SunXingzhi/topping_machine/firmware/STM32F103C8T6/docs/PD42S1_Motor_Driver_Requirements_Design_v1.0.md

# PD42S1 三轴 CAN 电机驱动模块

## 需求与设计说明书（V1.0）

| 项目 | 内容 |
|---|---|
| 文档编号 | FW-MOTOR-PD42S1-001 |
| 版本 | V1.0 |
| 日期 | 2026-10-27 |
| 状态 | 已评审；P5 完成，等待 P6 实机联调 |
| 适用工程 | `F:\topping\topping_machine\firmware\STM32F103C8T6` |
| 目标硬件 | STM32F103C8T6 + SN65HVD230 + 3 × ATK-PD42S1（CAN 光耦版） |
| 参考文档 | 《PD42S1 步进电机闭环驱动器用户手册 V1.2》、正点原子控制协议 V1.2、CAN 通讯例程 |
| 编制 | 项目组 |
| 审核 | 待定 |

### 修订记录

| 版本 | 日期 | 修改内容 | 状态 |
|---|---|---|---|
| V1.0-draft | 2026-10-27 | 初稿：冻结 v1 需求、协议、接口、时序、测试与风险 | 已确认 |
| V1.0 | 2026-10-27 | P1：完成 `Core/Inc/motor.h` 公共接口，C/C++ 语法检查通过 | P1 完成 |
| V1.0 | 2026-10-27 | P2：完成 `Core/Src/motor.c` CAN 传输层及 `Motor_Init` / `Motor_Ping` / `Motor_GetLastDeviceError`，严格编译检查通过 | P2 完成 |
| V1.0 | 2026-10-27 | P3：完成设备服务层全部 API；ARM 严格编译与主机侧协议测试通过 | P3 完成 |
| V1.0 | 2026-10-27 | P4：接入 CMake/main，Debug/Release 完整固件编译通过；示例默认关闭 | P4 完成 |
| V1.0 | 2026-10-27 | P5：完成干净构建、HEX/BIN 校验和 26 组主机测试；详见 P5 报告 | P5 完成 |
| V1.0 | 2026-10-29 | P6 准备：`main.c` 改为三轴 100 RPM 连续旋转测试；不生成新固件 | 测试源码 |
| V1.0 | 2026-10-30 | 仓库整理：测试移至 `tests/`，生产 `main.c` 仅保留初始化；新增 Test preset 与固件 `.gitignore` | 仓库整理完成 |

> **重要说明**
>
> 本文档已于 2026-10-27 经用户确认。P1 完成 `Core/Inc/motor.h`；P2 完成 CAN 传输层；P3 完成设备服务层；P4 完成 CMake/main 接入和整机编译；P5 完成干净构建、HEX/BIN 校验和 26 组主机测试。下一步为 P6 实机联调。后续阶段需按第 15 节和 P5 报告执行。

---

## 1. 文档目的

本文档用于冻结“三轴 PD42S1 CAN 闭环步进电机驱动模块”的 v1 需求，并作为后续编码、联调和验收的依据。

目标读者：

- 负责 STM32 主程序、CAN 通信和运动控制的开发人员；
- 负责接线、地址配置和整机联调的调试人员；
- 后续维护该模块的软件人员。

---

## 2. 项目背景与目标

### 2.1 背景

- 主控：STM32F103C8T6 最小系统板，HSE 8 MHz，系统时钟 72 MHz。
- 执行机构：3 台 42 步进电机，分别搭配 1 台正点原子 ATK-PD42S1 CAN 光耦版闭环驱动器。
- 通信：3 台驱动器挂在同一条 CAN 总线上，通过 1 块 SN65HVD230 收发器与 STM32 的 CAN1 相连。
- 当前工程已用 STM32CubeMX 配置 CAN1 和基础外设，但尚未配置 CAN 过滤器、尚未启动 CAN，也没有电机控制代码。

### 2.2 目标

提供一个可复用的电机驱动模块，使调用方可以：

1. 不关心 CAN 帧拆分、重组、校验和、超时和重试；
2. 用简单接口控制 3 个电机的使能、相对位置、绝对位置、速度和停止；
3. 读取位置、速度、运行状态、到位标志和堵转标志；
4. 在裸机主循环中安全使用，不引入动态内存和 RTOS 依赖；
5. 在后续整机程序中直接复用，而不必把协议细节散落在 `main.c` 中。

### 2.3 非目标

v1 不实现：

- 驱动器内部 FOC/PID 算法（由 PD42S1 完成）；
- 自动回零、限位开关逻辑；
- 多轴直线/圆弧插补；
- 力矩模式、开环模式、脉冲模式、PWM 脉宽模式；
- PID、电流、细分、波特率、地址、CAN ID 等参数的在线配置；
- FreeRTOS 任务封装；
- CAN 总线错误注入和完整诊断工具。

---

## 3. 术语

| 术语 | 说明 |
|---|---|
| PD42S1 | 正点原子 42 步进电机 FOC 闭环驱动器，本文指 CAN 光耦版 |
| counts | 驱动器通信位置单位；51200 counts = 电机轴 1 圈 |
| 单圈绝对定位 | 上电后可确定电机在一圈内的绝对角度，但不知道掉电前累计转了多少圈 |
| 事务（transaction） | 一次“主机发一条完整指令 + 驱动器回一条完整应答”的过程 |
| 帧（frame） | 协议层完整帧：`0xC5 ... 0x5C` |
| CAN 报文 | CAN 总线上的一个数据帧，最多 8 字节 |
| 多帧 | 一条协议帧超过 8 字节，需要拆成多个 CAN 报文 |
| ACK | 驱动器对指令的应答；不是 CAN 硬件 ACK |
| 到位 | 驱动器 `0x30` 指令返回的 in-position 标志为 1 |

---

## 4. 系统概述

### 4.1 硬件拓扑

```text
                    +----------------------+
                    |  STM32F103C8T6       |
                    |  CAN1: PA11 / PA12   |
                    +----------+-----------+
                               |
                        CAN_TX / CAN_RX
                               |
                    +----------v-----------+
                    |  SN65HVD230          |
                    |  3.3V CAN 收发器      |
                    +----------+-----------+
                               |
                    CAN_H / CAN_L / GND
                               |
        +----------------------+----------------------+
        |                      |                      |
+-------v--------+     +-------v--------+     +-------v--------+
| PD42S1 #1      |     | PD42S1 #2      |     | PD42S1 #3      |
| addr = 1       |     | addr = 2       |     | addr = 3       |
| 42 stepper     |     | 42 stepper     |     | 42 stepper     |
+----------------+     +----------------+     +----------------+
```

### 4.2 软件边界

```text
应用层（main.c / 整机逻辑）
        |
        |  motor.h 公共接口
        v
电机驱动模块（motor.c）
        |
        +-- 设备服务层：命令组包、状态解析、单位换算、重试策略
        |
        +-- CAN 传输层：过滤器/启动、多帧发送、应答重组、2 ms 间隔、超时
        |
        v
STM32 HAL CAN1 -> SN65HVD230 -> CAN 总线 -> PD42S1
```

模块内部不动态申请内存，所有缓冲区为静态数组。

---

## 5. 已确认需求

| 编号 | 需求 | 确认结果 |
|---|---|---|
| REQ-001 | 控制对象 | 3 台 PD42S1，从机地址规划为 1/2/3 |
| REQ-002 | 闭环位置 | 闭环在驱动器内部完成；STM32 只发指令、读状态 |
| REQ-003 | 总线 | CAN1，500 kbps，扩展帧；仅使用正点原子自定义协议 |
| REQ-004 | 发送与应答 | 主机固定发送 ID `0x1000`；应答按报文内 `addr + code + 校验` 匹配，不依赖唯一回传 ID |
| REQ-005 | 运动接口语义 | 收到驱动器 ACK 即返回；到位等待由独立接口完成 |
| REQ-006 | 位置单位 | 底层 counts；51200 counts/圈；对外提供圈、度换算 |
| REQ-007 | 绝对定位 | 三轴行程均小于 1 圈；v1 不做回零；绝对目标默认限制 ±51200 counts |
| REQ-008 | 功能范围 | 初始化、使能/失能、相对/绝对位置、速度、立即停止、位置/速度/状态/到位/堵转读取、到位等待 |
| REQ-009 | 初始化安全 | 上电不自动使能、不自动运动 |
| REQ-010 | 运行环境 | 裸机、STM32 HAL、C11、CMake、arm-none-eabi-gcc |
| REQ-011 | 地址配置 | 使用驱动器屏幕菜单逐台设置为 1/2/3，代码按 1/2/3 固定 |
| REQ-012 | 当前硬件状态 | 尚未接线；先完成代码与编译验证，接线后联调 |
| REQ-013 | 多轴协同 | 独立运动；需要同时启动时由上层依次下发指令，不做插补 |
| REQ-014 | 重试策略 | 相对运动不自动重试；读、绝对运动、停止、使能可安全重试 |
| REQ-015 | 等待超时 | 只返回错误，不擅自刹车；需要安全停机时显式调用停止接口 |
| REQ-016 | 示例 | 提供最小示例，但默认关闭，不能在上电时自动动作 |

---

## 6. 硬件与总线前提

### 6.1 主控与 CAN

| 项目 | 配置 |
|---|---|
| MCU | STM32F103C8T6，LQFP48 |
| 系统时钟 | 72 MHz（HSE 8 MHz × 9） |
| CAN 外设 | CAN1 |
| CAN_RX | PA11 |
| CAN_TX | PA12 |
| CAN 波特率 | 500 kbps |
| CAN 模式 | Normal，AutoBusOff = ENABLE，AutoRetransmission = ENABLE |
| CAN 帧类型 | 扩展帧（29-bit ID） |
| 收发器 | SN65HVD230，3.3 V |
| 当前 CubeMX 状态 | `MX_CAN_Init()` 已存在；过滤器未配置，CAN 未启动 |

### 6.2 驱动器与电机

| 项目 | 配置 |
|---|---|
| 驱动器 | ATK-PD42S1 CAN 光耦版 × 3 |
| 电机 | 42 步进电机，1.8°，200 全步/圈 |
| 驱动器供电 | 12~32 V；手册建议 24 V、3 A |
| 通信协议 | 正点原子自定义协议；MODBUS 必须失能 |
| 从机地址 | 1、2、3 |
| CAN 速率 | 500 kbps |
| 位置分辨率 | 51200 counts/圈（通信位置模式） |
| 编码器 | 单圈绝对值；多圈累计位置掉电丢失 |

### 6.3 总线接线与终端电阻

- CAN_H 接 CAN_H，CAN_L 接 CAN_L，所有节点共地。
- 使用双绞线，CAN_H/CAN_L 成对走线，分支尽量短。
- 总线两端各保留一个 120 Ω 终端电阻，中间节点不应再并联终端。
- PD42S1 每台自带 120 Ω；SN65HVD230 模块通常也带 120 Ω 或终端跳线。
- 三台驱动器 + 一个模块全部保留终端会导致终端过多，通信可能不稳定。
- 断电测量 `CAN_H` 与 `CAN_L` 之间电阻，正常应约为 **60 Ω**；明显低于 60 Ω 说明终端过多。

### 6.4 接线前检查清单

- [ ] 三台驱动器地址已通过屏幕菜单分别设为 1、2、3。
- [ ] 三台驱动器 CAN 速率均为 500 kbps。
- [ ] 三台驱动器 MODBUS 均为“失能”，使用正点原子自定义协议。
- [ ] 总线只保留两个 120 Ω 终端；断电测量约 60 Ω。
- [ ] STM32、SN65HVD230、驱动器共地。
- [ ] 驱动器 24 V 供电容量足够，极性正确。
- [ ] 电机四线 A+ / A− / B− / B+ 接线正确，未带电拔插。
- [ ] 首次上电不带机械负载，或机械机构处于安全位置。
- [ ] 准备急停/断电手段。

> 当前状态：**尚未接线**。以上检查必须在首次上电前完成。

---

## 7. 协议摘要

### 7.1 协议选择

PD42S1 的 CAN 版本**只支持正点原子自定义协议，不支持 Modbus-RTU**。因此本模块只实现自定义协议。

### 7.2 协议帧格式

| 帧头 | 从机地址 | 功能码 | 指令数据 | 校验和 | 帧尾 |
|---|---|---|---|---|---|
| `0xC5` | `addr` | `code` | `data[0..N-1]` | `checksum` | `0x5C` |

- 地址范围：0 为广播；1~255 为从机地址。
- 校验和：`checksum = (0xC5 + addr + code + data 所有字节) & 0xFF`。
- 多字节整数使用**大端序**（高字节在前）。
- 32 位浮点数使用 IEEE-754 单精度，按高字节到低字节发送。
- 一条完整协议帧可能超过 8 字节，需要拆成多个 CAN 报文。

### 7.3 CAN 传输规则

| 规则 | 要求 |
|---|---|
| CAN ID | 必须为 `0x100x` 扩展帧；主机发送固定使用 `0x1000` |
| 单条协议帧 | 从 `0xC5` 到 `0x5C` 连续输出 |
| CAN 拆分 | 每 8 字节一包，最后一包 1~8 字节 |
| 指令间隔 | 两条完整指令之间至少 2 ms |
| 应答 | 驱动器回复一条完整协议帧，可能跨多个 CAN 报文 |
| 多机 | 同一时刻只允许一个从机应答；主机必须串行发指令 |
| 广播/分组 | 广播地址和分组地址不应答 |

### 7.4 位置、方向、速度、加减速度

| 项目 | 说明 |
|---|---|
| 位置单位 | 51200 counts/圈 |
| 方向 | `0` 正转，`1` 反转 |
| 绝对位置/相对位置 | 数据域为“方向 + 加减速度 + 速度 + 位置幅值” |
| 位置幅值 | `uint32_t`，按大端发送；API 的带符号 counts 在内部拆成方向和幅值 |
| 位置模式速度 | `uint16_t`，0~6000 RPM；API 实际要求 1~6000 RPM |
| 速度模式速度 | `float`，0.1~6000 RPM |
| 加减速度 | `uint8_t`，0~200；0 表示直接启动 |
| 绝对定位限制 | v1 软件限制 `abs(target_counts) <= 51200` |

### 7.5 v1 使用的功能码

| 功能 | 功能码 | 下行数据长度 | 下行总长 | 上行数据长度 | 上行总长 | v1 |
|---|---|---:|---:|---:|---:|---|
| 读取软硬件版本（Ping） | `0x20` | 0 | 5 | 3 | 8 | 是 |
| 读实时转速 | `0x29` | 0 | 5 | 3 | 8 | 是 |
| 读实时位置 | `0x2A` | 0 | 5 | 5 | 10 | 是 |
| 读运行状态 | `0x2C` | 0 | 5 | 2 | 7 | 是 |
| 读堵转标志 | `0x2D` | 0 | 5 | 2 | 7 | 是 |
| 读使能状态 | `0x2F` | 0 | 5 | 2 | 7 | 是 |
| 读到位标志 | `0x30` | 0 | 5 | 2 | 7 | 是 |
| 电机使能控制 | `0xFA` | 1 | 6 | 2 | 7 | 是 |
| 速度模式控制 | `0xF1` | 6 | 11 | 1 | 6 | 是 |
| 绝对位置模式控制 | `0xF2` | 8 | 13 | 1 | 6 | 是 |
| 相对位置模式控制 | `0xF3` | 8 | 13 | 1 | 6 | 是 |
| 立即停止（刹车） | `0xFC` | 0 | 5 | 1 | 6 | 是 |
| 当前位置清零 | `0xF8` | 0 | 5 | 1 | 6 | 可选 |
| 设置从机地址 | `0x60` | 1 | 6 | 2 | 7 | 否（屏幕配置） |
| 设置发送 CAN_ID | `0x6C` | 4 | 9 | 5 | 10 | 否 |

> 表中的“总长”包含帧头、地址、功能码、数据、校验和、帧尾。
>
> 0xF2 / 0xF3 的 13 字节长度以手册 V1.2 为准。厂商 CAN 例程中这两个函数多发送了一个保留 0 字节（14 字节），首次联调时需要实机确认，详见第 14 节风险 R-03。

### 7.6 驱动器错误码

| 错误码 | 含义 | 本模块映射 |
|---|---|---|
| `0x01` | 应答成功 | `MOTOR_OK` |
| `0xE1` | 帧长度不足 | `MOTOR_ERR_FRAME` |
| `0xE2` | 帧头错误 | `MOTOR_ERR_FRAME` |
| `0xE3` | 帧尾错误 | `MOTOR_ERR_FRAME` |
| `0xE4` | 校验和错误 | `MOTOR_ERR_CHECKSUM` |
| `0xE5` | 不支持的功能码 | `MOTOR_ERR_DEVICE` |
| `0xE6` | 数据不合法 | `MOTOR_ERR_DEVICE` |

原始错误码通过 `Motor_GetLastDeviceError()` 保留，便于调试。

### 7.7 运行状态编码

| 值 | 状态 |
|---:|---|
| 0 | 停止 |
| 1 | 任务完成 |
| 2 | 正在运行 |
| 3 | 过载 |
| 4 | 堵转 |
| 5 | 欠压 |

### 7.8 使能状态编码

驱动器 `0x2F` 返回值：

- `0`：电机使能；
- `1`：电机失能。

注意这是反逻辑。公共接口 `Motor_ReadEnabled()` 会转换成 `true = 使能`。

> 手册 4.3.16 的示例说明存在一处自相矛盾：正文写“0：使能、1：失能”，但示例说明把 `0x00` 写成了“失能”。`0x31` 系统参数也写“0：使能、1：失能”。本设计以正文和 `0x31` 为准，联调时用 `Motor_Enable` 后读取 `0x2F` 实测确认。

---

## 8. 软件架构

### 8.1 文件规划

| 文件 | 作用 |
|---|---|
| `Core/Inc/motor.h` | 公共类型、常量、API 声明 |
| `Core/Src/motor.c` | CAN 传输、协议组包/解析、设备服务、单位换算 |
| `Core/Src/main.c` | 增加初始化和默认关闭的示例（只改 USER CODE 区） |
| `CMakeLists.txt` | 增加 `motor.c` 源文件 |
| `docs/PD42S1_Motor_Driver_Requirements_Design_v1.0.md` | 本文档 |

不修改：

- `Core/Src/can.c` 中 CubeMX 生成的初始化逻辑；
- `Core/Src/stm32f1xx_it.c` 的中断框架；
- `cmake/stm32cubemx/CMakeLists.txt` 的自动生成内容。

### 8.2 分层职责

| 层 | 职责 |
|---|---|
| 应用层 | 决定什么时候使能、运动、停止；处理业务错误 |
| 设备服务层 | 构造功能码和数据域；解析状态；单位换算；决定是否重试 |
| CAN 传输层 | 过滤器、启动、发送拆分、接收重组、2 ms 间隔、超时、校验 |
| HAL | CAN1 寄存器操作、邮箱、FIFO |

### 8.3 初始化流程

1. 应用先调用 CubeMX 生成的 `MX_CAN_Init()`（已存在，500 kbps）。
2. 应用调用 `Motor_Init()`。
3. `Motor_Init()` 配置 CAN 过滤器：接收所有扩展帧，具体地址在软件层匹配。
4. `Motor_Init()` 调用 `HAL_CAN_Start()`。
5. 清空 RX FIFO 中的残留报文。
6. 标记模块已初始化。
7. **不发送使能命令，不发送运动命令。**

### 8.4 一次指令事务

1. 检查模块已初始化、`id` 合法、参数在范围内。
2. 检查距离上一条完整指令是否已满 2 ms；不足则等待。
3. 清空 RX FIFO 中的陈旧报文。
4. 组协议帧：帧头、地址、功能码、数据、校验和、帧尾。
5. 按 8 字节拆分，逐包发送；等待每包发送完成，保证顺序。
6. 轮询 RX FIFO，按 5 ms 空闲间隔判断应答帧结束。
7. 校验帧头、地址、功能码、帧尾、校验和。
8. 解析数据域；若是驱动器错误码，映射为本地错误。
9. 对允许重试的指令，在超时/总线错误时重试；相对运动不重试。
10. 返回统一状态码。

### 8.5 并发模型

- v1 为裸机、单调用者模型。
- 模块内部用一个 `busy` 标志防止重入；重入时返回 `MOTOR_ERR_BUSY`。
- 不建议在中断中调用任何公共 API。
- `Motor_WaitInPosition()` 会阻塞轮询；不要放在 ISR 中。
- 后续若使用 RTOS，需要把 `HAL_Delay` 和轮询替换为任务友好的等待方式；v1 不提供。

---

## 9. 公共接口设计

### 9.1 类型

| 类型 | 定义 | 说明 |
|---|---|---|
| `motor_id_t` | `MOTOR_1 = 0`、`MOTOR_2 = 1`、`MOTOR_3 = 2`、`MOTOR_COUNT = 3` | 电机编号 |
| `motor_status_t` | 见 9.3 | 统一返回状态 |
| `motor_run_state_t` | 0~5，对应 7.7 | 运行状态 |
| `bool` | `<stdbool.h>` | 使能、到位、堵转等布尔量 |

### 9.2 常量

| 常量 | 建议值 | 说明 |
|---|---:|---|
| `MOTOR_COUNTS_PER_REV` | 51200 | 每圈 counts |
| `MOTOR_ABS_LIMIT_COUNTS` | 51200 | 绝对目标默认限制 |
| `MOTOR_MAX_SPEED_RPM` | 6000 | 最大速度 |
| `MOTOR_MAX_ACCEL` | 200 | 最大加减速度参数 |
| `MOTOR_ACK_TIMEOUT_MS` | 50 | 单次 ACK 超时 |
| `MOTOR_CMD_GAP_MS` | 3 | 指令间隔；保证 ≥2 ms |
| `MOTOR_RX_GAP_MS` | 5 | 应答多帧空闲判定 |
| `MOTOR_WAIT_POLL_MS` | 50 | 到位轮询周期 |
| `MOTOR_DEFAULT_WAIT_TIMEOUT_MS` | 30000 | 默认到位超时 |
| `MOTOR_RETRY_COUNT` | 1 | 安全指令重试次数 |
| `MOTOR_RX_BUF_SIZE` | 64 | 应答缓冲区 |
| `MOTOR_TX_BUF_SIZE` | 32 | 指令缓冲区 |

### 9.3 状态码

| 状态码 | 含义 |
|---|---|
| `MOTOR_OK` | 成功 |
| `MOTOR_ERR_PARAM` | 参数非法（空指针、速度/加速度越界等） |
| `MOTOR_ERR_RANGE` | 绝对目标超出 ±51200 限制 |
| `MOTOR_ERR_NOT_INIT` | 模块未初始化 |
| `MOTOR_ERR_BUSY` | 重入或总线忙 |
| `MOTOR_ERR_TIMEOUT` | ACK 或到位等待超时 |
| `MOTOR_ERR_CAN` | HAL CAN 发送/启动/状态错误 |
| `MOTOR_ERR_FRAME` | 应答帧结构错误 |
| `MOTOR_ERR_CHECKSUM` | 应答校验和错误 |
| `MOTOR_ERR_DEVICE` | 驱动器返回错误码 |
| `MOTOR_ERR_STALL` | 堵转 |
| `MOTOR_ERR_STATE` | 过载/欠压/状态不允许 |

### 9.4 API 列表

| 函数 | 主要参数 | 返回 | 行为 | 阻塞 |
|---|---|---|---|---|
| `Motor_Init` | 无 | `motor_status_t` | 配置过滤器、启动 CAN、清 FIFO；不使能、不运动 | 短暂 |
| `Motor_Ping` | `id` | `motor_status_t` | 发送 `0x20`，验证地址和应答 | 等待 ACK |
| `Motor_Enable` | `id`、`enable` | `motor_status_t` | `0xFA`；0 使能，1 失能 | 等待 ACK |
| `Motor_ReadEnabled` | `id`、`bool *enabled` | `motor_status_t` | `0x2F`，转换为 true=使能 | 等待 ACK |
| `Motor_MoveRelative` | `id`、`int32_t delta_counts`、`speed_rpm`、`accel` | `motor_status_t` | `0xF3`；ACK 后返回 | 等待 ACK |
| `Motor_MoveAbsolute` | `id`、`int32_t target_counts`、`speed_rpm`、`accel` | `motor_status_t` | `0xF2`；检查 ±51200 | 等待 ACK |
| `Motor_MoveRelativeRev` | `id`、`float rev`、`speed_rpm`、`accel` | `motor_status_t` | 圈→counts 后调用相对运动 | 等待 ACK |
| `Motor_MoveRelativeDeg` | `id`、`float deg`、`speed_rpm`、`accel` | `motor_status_t` | 度→counts 后调用相对运动 | 等待 ACK |
| `Motor_MoveAbsoluteRev` | `id`、`float rev`、`speed_rpm`、`accel` | `motor_status_t` | 圈→counts 后调用绝对运动 | 等待 ACK |
| `Motor_MoveAbsoluteDeg` | `id`、`float deg`、`speed_rpm`、`accel` | `motor_status_t` | 度→counts 后调用绝对运动 | 等待 ACK |
| `Motor_SetSpeed` | `id`、`int32_t rpm`、`accel` | `motor_status_t` | `0xF1`；带符号速度 | 等待 ACK |
| `Motor_Stop` | `id` | `motor_status_t` | `0xFC`；单轴刹车 | 等待 ACK |
| `Motor_StopAll` | 无 | `motor_status_t` | 广播 `0xFC`；不应答 | 只等发送完成 |
| `Motor_ReadPosition` | `id`、`int32_t *counts` | `motor_status_t` | `0x2A` | 等待 ACK |
| `Motor_ReadSpeed` | `id`、`int16_t *rpm` | `motor_status_t` | `0x29` | 等待 ACK |
| `Motor_ReadState` | `id`、`motor_run_state_t *state` | `motor_status_t` | `0x2C` | 等待 ACK |
| `Motor_ReadInPosition` | `id`、`bool *in_position` | `motor_status_t` | `0x30` | 等待 ACK |
| `Motor_ReadStall` | `id`、`bool *stalled` | `motor_status_t` | `0x2D` | 等待 ACK |
| `Motor_WaitInPosition` | `id`、`uint32_t timeout_ms` | `motor_status_t` | 轮询 `0x30`，检测堵转/故障 | 阻塞到到位/超时 |
| `Motor_ZeroPosition` | `id` | `motor_status_t` | `0xF8`，当前位置清零；可选 | 等待 ACK |
| `Motor_GetLastDeviceError` | `id` | `uint8_t` | 返回最近一次驱动器错误码 | 不通信 |
| `Motor_CountsToRev` | `int32_t counts` | `float` | counts → 圈 | 不通信 |
| `Motor_CountsToDeg` | `int32_t counts` | `float` | counts → 度 | 不通信 |
| `Motor_RevToCounts` | `float rev` | `int32_t` | 圈 → counts，四舍五入 | 不通信 |
| `Motor_DegToCounts` | `float deg` | `int32_t` | 度 → counts，四舍五入 | 不通信 |

### 9.5 参数范围

| 参数 | 范围 | 处理 |
|---|---|---|
| `id` | `MOTOR_1` ~ `MOTOR_3` | 越界返回 `MOTOR_ERR_PARAM` |
| 位置 counts | `int32_t`；绝对目标 `abs <= 51200` | 越界返回 `MOTOR_ERR_RANGE` |
| 位置模式速度 | 1~6000 RPM | 0 或超限返回 `MOTOR_ERR_PARAM` |
| 速度模式速度 | `abs(rpm)` 1~6000 | 0 用 `Motor_Stop`，不通过速度接口 |
| 加减速度 | 0~200 | 超限返回 `MOTOR_ERR_PARAM` |
| `timeout_ms` | 0 表示使用默认 30000 ms | 其他值按调用者给定 |

### 9.6 方向与符号

- `Motor_MoveRelative` / `Motor_MoveAbsolute` 接受带符号 counts。
- 内部映射：
  - `target >= 0`：方向 0，幅值 `target`；
  - `target < 0`：方向 1，幅值 `-target`。
- `int32_t` 的 `INT32_MIN` 取绝对值会溢出，直接返回 `MOTOR_ERR_PARAM`。
- `Motor_SetSpeed` 接受带符号 RPM：
  - `rpm > 0`：方向 0；
  - `rpm < 0`：方向 1，幅值 `-rpm`。

---

## 10. 关键行为与策略

### 10.1 指令间隔

- 两条完整指令之间至少 2 ms。
- 实现使用 3 ms 保护间隔，避免 `HAL_GetTick()` 1 ms 分辨率导致不足 2 ms。
- 间隔从上一条指令的最后一个 CAN 报文发送完成开始计时。
- 同一条指令内部的多个 CAN 报文连续发送，不插入 3 ms 间隔。

### 10.2 多帧发送

- 协议帧长度 ≤ 8 字节：一包发送。
- 协议帧长度 > 8 字节：按 8 字节拆分，最后一包为剩余长度。
- 例如 13 字节的 `0xF2` 指令拆为 8 + 5。
- 逐包等待发送完成，保证 CAN 报文顺序。
- 发送超时返回 `MOTOR_ERR_CAN`。

### 10.3 多帧接收与重组

- 接收所有扩展帧，按到达顺序追加到 RX 缓冲区。
- 每收到一包刷新“最后接收时间”。
- 当总线空闲达到 `MOTOR_RX_GAP_MS`（5 ms）且至少收到一包时，认为应答结束。
- 校验：
  - 首字节 `0xC5`；
  - 末字节 `0x5C`；
  - 地址等于目标电机；
  - 功能码等于期望值；
  - 校验和正确；
  - 总长度不小于 5。
- 任一校验失败返回对应错误，不把数据交给上层。
- 缓冲区最大 64 字节；v1 实际最长应答为 10 字节。

### 10.4 应答 ID 与匹配

- 主机发送 ID 固定 `0x1000`。
- 驱动器回传 ID 由 `0x6C` 配置，当前未确认。
- 本模块**不依赖回传 ID 唯一**：接受任意扩展帧，按报文内 `addr + code + checksum` 匹配。
- 这样即使三台驱动器都使用默认回传 ID，也能工作；前提是主机串行发指令，避免同时应答冲突。
- 若总线上存在其他扩展帧设备，应在软件层忽略不匹配的报文；v1 假设这是专用总线。

### 10.5 重试策略

| 指令 | 自动重试 | 原因 |
|---|---|---|
| `Motor_Ping`、所有读指令 | 是，1 次 | 幂等 |
| `Motor_Enable` / 失能 | 是，1 次 | 幂等 |
| `Motor_Stop` | 是，1 次 | 幂等 |
| `Motor_MoveAbsolute` | 是，1 次 | 目标相同，重复发送安全 |
| `Motor_SetSpeed` | 是，1 次 | 目标速度相同 |
| `Motor_MoveRelative` | **否** | ACK 丢失后重发会多走一段 |
| `Motor_ZeroPosition` | **否** | 电机可能已移动，重复清零会改变零点 |
| `Motor_StopAll` | 否 | 广播无应答，无法确认；由上层决定是否重发 |

重试时同样要满足 3 ms 指令间隔。

### 10.6 超时建议值

| 超时 | 值 | 说明 |
|---|---:|---|
| ACK 超时 | 50 ms | 500 kbps 下足够覆盖多帧应答和驱动器处理 |
| 应答空闲间隔 | 5 ms | 判断一帧结束 |
| 到位轮询周期 | 50 ms | 避免总线过载 |
| 默认到位超时 | 30000 ms | 调用者可覆盖 |
| 单次重试 | 1 次 | 避免总线异常时长时间阻塞 |

### 10.7 到位等待

`Motor_WaitInPosition(id, timeout_ms)` 的行为：

1. 每 50 ms 读取一次 `0x30` 到位标志。
2. 若到位为 1，返回 `MOTOR_OK`。
3. 每次轮询读取 `0x2D` 堵转标志；为 1 返回 `MOTOR_ERR_STALL`。
4. 每 5 次轮询读取一次 `0x2C` 运行状态；若为 3/4/5（过载/堵转/欠压），返回 `MOTOR_ERR_STATE`。
5. 到达总超时仍未到位，返回 `MOTOR_ERR_TIMEOUT`。
6. **超时后不自动刹车**；调用者应视安全要求调用 `Motor_Stop` 或 `Motor_StopAll`。
7. 通信连续失败两次，返回通信错误，不继续无限重试。

### 10.8 停止

- `Motor_Stop(id)`：单轴 `0xFC`，等待 ACK，幂等，可重试。
- `Motor_StopAll()`：广播地址 0 发送 `0xFC`，所有驱动器执行但不应答。
  - 返回 `MOTOR_OK` 仅表示 CAN 报文发送成功，不表示每个驱动器都已确认。
  - 广播会影响总线上所有从机，只能在专用总线使用。
- 急停优先使用 `Motor_StopAll()`，随后再逐个读取状态确认。

### 10.9 绝对定位保护

- `Motor_MoveAbsolute` 在组包前检查 `abs(target_counts) <= 51200`。
- 超出返回 `MOTOR_ERR_RANGE`，**不发送任何 CAN 报文**。
- `±51200` 是单圈绝对定位的坐标合理性保护，不是机械行程限制。
- 实际机械安全范围应由硬限位、限位开关或上层更小的软件范围保证。
- 相对运动不受该硬限制，但累计行程仍应保持在一圈以内，否则会回到多圈绝对位置不可靠的问题。

### 10.10 绝对零点

- 绝对坐标的 0 点是驱动器零点，不一定是机械零点。
- 如果两者不一致，需要在装配时对齐，或在上层加固定偏移，或在已知位置调用 `Motor_ZeroPosition()` 后重新建立坐标。
- `0xF8` 清零是否会掉电保持，手册未明确保证；v1 不依赖它跨上电保持。
- 由于三轴行程都小于 1 圈，单圈绝对位置在机械连接不打滑的前提下可跨上电使用。

### 10.11 上电安全

- `Motor_Init()` 不使能、不运动。
- 示例默认关闭，不能在上电时自动动作。
- 调用者必须显式 `Motor_Enable(..., true)` 后才允许运动。
- 建议整机上电流程：初始化 CAN → 读取状态 → 确认安全 → 使能 → 运动。

> 例外：测试构建（`MOTOR_BUILD_TESTS=ON`）会在上电 1 秒后运行 `tests/embedded/motor_validation_test.c`，逐台使能并短时旋转。生产构建默认不编译测试，`main.c` 不会自动动作。

### 10.12 CAN 错误与总线关闭

- CubeMX 已配置 `AutoBusOff = ENABLE`，硬件可自动恢复总线关闭。
- v1 不实现主动总线恢复状态机；HAL 返回错误时，API 返回 `MOTOR_ERR_CAN`。
- 若连续出现 CAN 错误，调用者应停止运动、检查接线/终端电阻/地址，再重新初始化。

---

## 11. 内部数据结构

### 11.1 配置表

内部静态配置表，每台电机一条：

| 字段 | 类型 | 值/说明 |
|---|---|---|
| `addr` | `uint8_t` | 1、2、3 |
| `tx_id` | `uint32_t` | `0x1000` |
| `counts_per_rev` | `int32_t` | 51200 |

地址固定为 1/2/3；如果后续需要修改，应改配置表或增加配置接口，不在 v1 范围内。

### 11.2 运行时状态

| 字段 | 类型 | 说明 |
|---|---|---|
| `initialized` | `bool` | 模块是否已初始化 |
| `busy` | `bool` | 防止重入 |
| `last_device_error` | `uint8_t[3]` | 每台最近一次驱动器错误码 |
| `last_cmd_tick` | `uint32_t` | 上一条指令结束时刻 |

### 11.3 缓冲区

| 缓冲区 | 大小 | 用途 |
|---|---:|---|
| TX 组包缓冲 | 32 字节 | 最长 v1 指令 13 字节 |
| RX 重组缓冲 | 64 字节 | 最长 v1 应答 10 字节，留余量 |
| CAN 单包数据 | 8 字节 | HAL 发送/接收 |

### 11.4 资源占用

- 不使用 `malloc/free`。
- 不使用全局大数组。
- 预计静态 RAM 占用小于 200 字节（不含 HAL 和栈）。
- 预计代码量小于 8 KB Flash（以实际编译为准）。

---

## 12. 集成方案

### 12.1 源文件

新增：

- `Core/Inc/motor.h`
- `Core/Src/motor.c`
- `tests/embedded/motor_validation_test.c`
- `tests/embedded/motor_validation_test.h`

### 12.2 CMake

在根 `CMakeLists.txt` 的 `target_sources` 用户区加入：

- `Core/Src/motor.c`

增加可选测试开关 `MOTOR_BUILD_TESTS`（默认 `OFF`）。打开后加入：

- `tests/embedded/motor_validation_test.c`
- `tests/embedded` 头文件路径
- `MOTOR_TEST_ENABLE=1`

`Core/Inc` 已在 CubeMX 生成的包含路径中，不需要额外添加。

根 CMake 还增加了 POST_BUILD 步骤，生成 `.hex` 和 `.bin`，便于 STM32CubeProgrammer 或其它烧录工具使用。

### 12.3 main.c

只在 USER CODE 区增加：

1. `#include "motor.h"`
2. 测试构建时包含 `motor_validation_test.h`
3. `MX_CAN_Init()` 之后调用 `Motor_Init()`，检查返回值；失败进入 `Error_Handler()`
4. 测试构建时调用 `MotorTest_RunValidation()`；生产构建不调用

生产 `main.c` 不包含测试宏、测试全局变量或自动运动逻辑。测试构建通过 `Test` preset 使用独立的 `build/Test/`。

不修改 CubeMX 生成的 `MX_CAN_Init()` 参数。

### 12.4 CAN 中断

- v1 使用轮询接收，不启用 `HAL_CAN_ActivateNotification()`。
- `can.c` 中 NVIC 已使能 `USB_LP_CAN1_RX0_IRQn`，但没有激活 RX 中断通知，不会产生回调。
- `stm32f1xx_it.c` 中的 `HAL_CAN_IRQHandler(&hcan)` 保留不动。
- 后续如改为中断接收，需要新增 `HAL_CAN_RxFifo0MsgPendingCallback`，不在 v1 范围。

### 12.5 测试构建行为

测试源码位于 `tests/embedded/motor_validation_test.c`，仅在 `MOTOR_BUILD_TESTS=ON` 时参与构建：

1. 上电等待 1 秒。
2. 逐台测试 M1/M2/M3；每台 Ping 最多 3 次，单台失败只跳过该台，不阻塞其它电机。
3. 每台执行使能、读状态/位置、100 RPM 短时旋转、停止、失能。
4. 三台分别完成后，对测试成功的电机做 50 RPM 群组运行，再调用 `Motor_StopAll()`。
5. 共 3 轮，每轮间隔 3 秒；结束后停止并失能。

测试结果保存在 `tests/embedded/motor_validation_test.c` 的 `g_test_*` 变量中，可用 GDB 观察；具体步骤见 `tests/README.md`。

> 正数对应驱动器方向 0（手册定义为顺时针/正转）。如果实际转向相反，把测试文件中的 `MOTOR_TEST_SPEED_RPM` 和 `MOTOR_TEST_GROUP_SPEED_RPM` 改成负数后重新编译。

---

## 13. 测试与验收

### 13.1 编译与静态检查

| 编号 | 测试 | 通过标准 |
|---|---|---|
| T-01 | CMake 配置 | 使用 STM32CubeCLT 的 arm-none-eabi-gcc 配置成功 |
| T-02 | 编译 | 无错误；无新增严重警告 |
| T-03 | 链接 | 生成 elf/hex/bin，Flash/RAM 不超限 |
| T-04 | 接口检查 | `motor.h` 可被 C 和 C++ 调用（`extern "C"`） |

### 13.2 协议逻辑测试

| 编号 | 测试 | 通过标准 |
|---|---|---|
| T-05 | 校验和向量 | `C5 01 FA 00` → `0xC0`；`C5 01 FC` → `0xC2`；`C5 01 F2 00 64 07 D0 00 00 64 00` → `0x57` |
| T-06 | 多帧拆分 | 13 字节拆为 8+5；10 字节拆为 8+2 |
| T-07 | 0x2A 应答解析 | 10 字节应答解析出正确的 `int32_t` 位置 |
| T-08 | 校验和错误 | 返回 `MOTOR_ERR_CHECKSUM`，不更新位置 |
| T-09 | 地址不匹配 | 忽略错误地址，最终超时或继续等待正确应答 |
| T-10 | 绝对目标越界 | `76800` 返回 `MOTOR_ERR_RANGE`，无 CAN 发送 |

### 13.3 硬件联调测试

前提：地址 1/2/3 已配置，500 kbps，MODBUS 失能，终端电阻约 60 Ω，24 V 供电正常。

| 编号 | 测试 | 通过标准 |
|---|---|---|
| H-01 | Ping 三台 | 1/2/3 均返回 `MOTOR_OK` |
| H-02 | 使能/失能 | `Motor_Enable` 后 `Motor_ReadEnabled` 为 true；失能后为 false |
| H-03 | 相对小角度 | 90° 相对运动，位置变化约 12800 counts |
| H-04 | 绝对 90° | 目标 25600 counts，到位后位置误差在允许范围内 |
| H-05 | 速度模式 | 设定 100 RPM，实际速度符号/大小正确；`Motor_Stop` 能停 |
| H-06 | 到位等待成功 | 正常运动时 `Motor_WaitInPosition` 返回 `MOTOR_OK` |
| H-07 | 到位等待超时 | 极短超时返回 `MOTOR_ERR_TIMEOUT`，不自动刹车 |
| H-08 | 堵转/故障检测 | 人为堵转时返回 `MOTOR_ERR_STALL` 或 `MOTOR_ERR_STATE` |
| H-09 | 多帧应答 | 读位置 10 字节应答正确重组 |
| H-10 | 指令间隔 | 逻辑分析仪确认两条完整指令间隔 ≥2 ms |
| H-11 | 三轴顺序控制 | 三台依次运动/读取不互相干扰 |
| H-12 | 广播停止 | `Motor_StopAll` 后三台都停止 |
| H-13 | 掉电单圈位置 | 断电再上电，单圈绝对位置仍在预期范围（机械不打滑） |
| H-14 | 上电安全 | 上电后电机不自动使能、不自动运动 |
| H-15 | 错误码透传 | 驱动器返回 0xE? 时，API 返回对应错误，原始码可读 |

### 13.4 验收标准

满足以下条件视为 v1 验收通过：

1. 编译、链接通过，无严重警告。
2. 三台驱动器可通过地址 1/2/3 独立通信。
3. 相对/绝对位置、速度、停止、使能/失能、状态读取全部可用。
4. 多帧应答重组正确，校验失败能返回错误。
5. 绝对目标超过 ±51200 时不下发。
6. 上电不自动动作，示例默认关闭。
7. 连续运行 30 分钟无通信死锁、无看门狗复位（如启用看门狗）。
8. 联调记录和接线检查表归档。

### 13.5 需求追踪矩阵

| 需求 | 验证项 |
|---|---|
| REQ-001 三轴地址 1/2/3 | H-01、H-11 |
| REQ-002 驱动器内部闭环 | H-03、H-04、H-06 |
| REQ-003 CAN 500 kbps / 自定义协议 | H-01、H-09 |
| REQ-004 发送 0x1000 / 按 addr 匹配 | H-01、H-09 |
| REQ-005 ACK 后返回 / 独立等待 | H-06、H-07 |
| REQ-006 counts + 圈/度 | H-03、H-04 |
| REQ-007 单圈绝对 / 无回零 / ±51200 | H-04、H-13、T-10 |
| REQ-008 功能范围 | H-02~H-09、H-12 |
| REQ-009 初始化不使能、不运动 | H-14 |
| REQ-010 裸机 / HAL / CMake | T-01~T-04 |
| REQ-011 屏幕配置地址 | H-01 |
| REQ-012 先编译、后联调 | P5、P6 |
| REQ-013 独立运动 | H-11 |
| REQ-014 相对运动不重试 | T-10、H-07 |
| REQ-015 超时不自动刹车 | H-07 |
| REQ-016 示例默认关闭 | H-14 |

### 13.6 当前 P3/P4 测试记录

| 项目 | 结果 |
|---|---|
| ARM 交叉编译 | `arm-none-eabi-gcc`，`-Wall -Wextra -Werror -pedantic -Wmissing-prototypes -Wstrict-prototypes -Wshadow -Wconversion -Wsign-conversion`，退出码 0 |
| 代码尺寸 | `text 7084`、`data 0`、`bss 15` 字节（`motor.c` 目标文件，不含 HAL/newlib） |
| 主机侧协议测试 | 使用临时 fake HAL + MSVC 编译运行，26 组测试全部通过 |
| 测试覆盖 | Ping 成功/错误/超时、使能/失能、使能状态、正负位置/速度/状态/到位/堵转读取、绝对位置、相对运动不重试、越界保护、速度（含负速度）、停止、广播停止、设零、到位等待、单位换算 |
| P4 Debug 完整固件 | 编译/链接通过；RAM 1632 B / 20 KB，FLASH 7972 B / 64 KB |
| P4 Release 完整固件 | 编译/链接通过；RAM 1632 B / 20 KB，FLASH 4628 B / 64 KB |
| P4 Demo 打开编译 | 编译/链接通过；RAM 1648 B，FLASH 15520 B；默认仍为关闭 |
| 构建产物 | `build/Debug/` 和 `build/Release/` 下的 `STM32F103C8T6.elf`、`.hex`、`.bin` |
| 未覆盖 | 真实 CAN 总线时序、真实驱动器应答、终端电阻、地址配置、机械到位 |
| 结论 | 固件和协议逻辑可用；硬件联调仍需按 H-01~H-15 执行 |

> 主机测试使用临时测试工程，不进入固件仓库；最终硬件行为以实机联调为准。
>
> P5 的完整构建日志、产物哈希和烧录说明见 `docs/P5_Build_and_Test_Report.md`。

---

## 14. 风险与待确认项

| 编号 | 风险/待确认 | 影响 | 处理 |
|---|---|---|---|
| R-01 | 三台驱动器地址仍为默认 1 | 多机通信会冲突 | 接线前用屏幕菜单逐台改为 1/2/3，并逐台 Ping 验证 |
| R-02 | 尚未接线，终端电阻未知 | 通信不稳定/无法通信 | 按 6.3/6.4 检查，断电测约 60 Ω |
| R-03 | 厂商 CAN 例程的 0xF2/0xF3 发送 14 字节，手册为 13 字节 | 位置指令可能不被驱动器接受 | 按手册 13 字节实现；首次联调单轴低速验证；必要时兼容两种长度 |
| R-04 | 驱动器回传 CAN ID 未确认 | 若按固定 ID 过滤可能收不到 | 本设计不依赖回传 ID，按报文 addr/code 匹配 |
| R-05 | 绝对零点与机械零点可能不一致 | 绝对定位偏差 | 装配对齐或上层加偏移；必要时用 `0xF8` 设零并验证掉电行为 |
| R-06 | 无限位开关，±51200 不是机械限位 | 可能撞机 | 加硬限位/限位开关；上层设置更小的每轴范围 |
| R-07 | Cortex-M3 无硬件 FPU，float 换算为软件运算 | 少量性能开销/舍入误差 | 只在配置和调用时换算；四舍五入到 counts |
| R-08 | 3 台电机同时运动时总线负载 | 轮询延迟、应答超时 | 串行事务；到位轮询 50 ms；必要时提高波特率或减少轮询 |
| R-09 | 24 V 电源容量不足 | 欠压、丢步、驱动器报警 | 按 3 台电机峰值电流选电源，留余量 |
| R-10 | 当前无硬件，无法实机验证 | 只能保证编译和逻辑 | 接线后按 H-01~H-15 联调 |
| R-11 | 手册与 Excel 在部分未使用功能上长度不一致 | 未来扩展踩坑 | v1 只实现已核对的功能码；扩展前重新核对 |

### 14.1 待确认项

| 编号 | 待确认 | 当前处理 | 是否阻塞编码 |
|---|---|---|---|
| OI-01 | 0xF2/0xF3 实际接受的帧长 | 按手册 13 字节，预留兼容开关 | 否 |
| OI-02 | `0xF8` 清零是否掉电保持 | v1 不依赖 | 否 |
| OI-03 | 三台驱动器实际回传 ID | 不依赖，按 addr 匹配 | 否 |
| OI-04 | 每轴机械安全范围 | v1 用全局 ±51200；后续可加每轴 min/max | 否 |
| OI-05 | 是否需要上电自动使能 | v1 明确不自动使能 | 否 |

---

## 15. 实施计划

| 阶段 | 内容 | 产出 | 进入条件 |
|---|---|---|---|
| P0 | 文档评审 | 本文档确认版（已完成 2026-10-27） | 用户确认 |
| P1 | 定义 `motor.h` 类型、常量、API | 头文件（已完成，C/C++ 语法检查通过） | P0 完成 |
| P2 | 实现 CAN 传输层 | 传输层与诊断接口（已完成，严格编译检查通过） | P1 完成 |
| P3 | 实现设备服务层 | 全部设备 API（已完成，ARM 编译/主机测试通过） | P2 完成 |
| P4 | 接入 CMake/main | 完整固件编译通过（已完成，Debug/Release） | P3 完成 |
| P5 | 编译与协议逻辑测试 | 构建日志、测试记录（已完成，见 P5 报告） | P4 完成 |
| P6 | 硬件联调 | H-01~H-15 记录 | 接线完成（下一步） |

> P5 已完成。P6 开始前必须完成接线、地址配置、终端电阻和供电检查；确认前不进行带电运动测试。

### 15.1 当前实现状态

| 公共接口 | 状态 |
|---|---|
| `Motor_Init` / `Motor_Ping` / `Motor_GetLastDeviceError` | P2 已实现 |
| `Motor_Enable` / `Motor_ReadEnabled` | P3 已实现 |
| `Motor_MoveRelative` / `Motor_MoveAbsolute` 及圈/度封装 | P3 已实现 |
| `Motor_SetSpeed` / `Motor_Stop` / `Motor_StopAll` | P3 已实现 |
| `Motor_ReadPosition` / `Motor_ReadSpeed` / `Motor_ReadState` / `Motor_ReadInPosition` / `Motor_ReadStall` | P3 已实现 |
| `Motor_WaitInPosition` / `Motor_ZeroPosition` | P3 已实现 |
| `Motor_CountsToRev` / `Motor_CountsToDeg` / `Motor_RevToCounts` / `Motor_DegToCounts` | P3 已实现 |
| CMake 接入 | P4 已完成 |
| `main.c` 生产初始化 | 已清理；默认不包含测试、不自动运动 |
| `tests/embedded` 实机验证测试 | 已接入 Test preset；覆盖读取/停止/使能/广播停止 |
| `tests/host` fake HAL 协议测试 | 已归档；Windows/MSVC 下 26 组测试通过 |
| Debug/Release 完整固件 | 本次仓库整理后重新编译通过 |
| P5 干净构建与主机测试 | 已完成，详见 `docs/P5_Build_and_Test_Report.md` |
| 三轴连续旋转测试 | 历史测试；已由逐台接口验证测试替代，不再位于 `main.c` |

---

## 16. 评审确认

请逐项确认：

- [x] 三轴行程均小于 1 圈，采用单圈绝对定位，v1 不做回零。
- [x] 三台地址通过屏幕菜单逐台设为 1/2/3，代码按 1/2/3 固定。
- [x] 绝对目标默认限制 ±51200 counts；超出返回 `MOTOR_ERR_RANGE`，不发送 CAN。
- [x] `Motor_Init()` 不自动使能、不自动运动。
- [x] 运动接口收到 ACK 即返回；到位等待使用独立接口。
- [x] 相对运动不自动重试；绝对运动/读/停止/使能可重试。
- [x] 到位等待超时不自动刹车。
- [x] 示例默认关闭。
- [x] API 列表和错误码满足使用要求。
- [x] 同意按本文档进入编码阶段。

确认人：用户（对话确认）

确认日期：2026-10-27

---

## 附录 A：关键协议帧示例

> 以下帧用于校验组包和联调。除特别注明外，均为地址 1、13 字节以内的 v1 允许指令。

| 动作 | 完整协议帧 | 说明 |
|---|---|---|
| Ping | `C5 01 20 E6 5C` | 读版本，验证通信 |
| 使能 | `C5 01 FA 00 C0 5C` | 0 = 使能 |
| 失能 | `C5 01 FA 01 C1 5C` | 1 = 失能 |
| 单轴停止 | `C5 01 FC C2 5C` | 0xFC |
| 广播停止 | `C5 00 FC C1 5C` | 广播，不应答 |
| 读位置 | `C5 01 2A F0 5C` | 应答 10 字节 |
| 读速度 | `C5 01 29 EF 5C` | 应答 8 字节 |
| 读状态 | `C5 01 2C F2 5C` | 应答 7 字节 |
| 读到位 | `C5 01 30 F6 5C` | 应答 7 字节 |
| 读堵转 | `C5 01 2D F3 5C` | 应答 7 字节 |
| 读使能 | `C5 01 2F F5 5C` | 应答 7 字节 |
| 当前位置清零 | `C5 01 F8 BE 5C` | 可选 |
| 速度 600 RPM | `C5 01 F1 00 64 44 16 00 00 75 5C` | 方向 0、加减速 100、float 600.0 |
| 相对 90° | `C5 01 F3 00 64 07 D0 00 00 32 00 26 5C` | 2000 RPM、12800 counts |
| 绝对 180° | `C5 01 F2 00 64 07 D0 00 00 64 00 57 5C` | 2000 RPM、25600 counts |
| 设置地址为 2 | `C5 01 60 02 28 5C` | 仅调试参考；v1 不提供 API |

### A.1 手册中的多圈示例（仅用于校验帧格式）

手册示例：

- 绝对 10 圈：`C5 01 F2 00 64 07 D0 00 07 D0 00 CA 5C`
- 相对 10 圈：`C5 01 F3 00 64 07 D0 00 07 D0 00 CB 5C`

> 这两个目标为 512000 counts（10 圈），超出 v1 的 ±51200 限制，**不能通过 v1 API 发送**；列出仅用于核对帧格式和校验和。

---

## 附录 B：参考文档

| 文档 | 路径 | 用途 |
|---|---|---|
| PD42S1 用户手册 V1.2 | `电机参考资料/PD42S1步进电机闭环驱动器用户手册_V1.2.pdf` | 协议、时序、接线、状态定义 |
| 正点原子控制协议 V1.2 | `电机参考资料/正点原子步进电机驱动器控制协议V1.2.xlsx` | 功能码和数据域 |
| CAN 通讯例程 | `电机参考资料/3，STM32例程/CAN通讯例程.zip` | 参考 CAN 收发和多帧处理 |
| P5 构建与测试报告 | `docs/P5_Build_and_Test_Report.md` | 最终构建、产物、主机测试和烧录说明 |
| 当前 CubeMX 工程 | `STM32F103C8T6.ioc` | CAN1、时钟、引脚配置 |

---

## 附录 C：决策记录

| 决策 | 结论 | 原因 |
|---|---|---|
| 协议选择 | 正点原子自定义协议 | CAN 版本不支持 Modbus-RTU |
| 发送 ID | 固定 0x1000 | 手册示例和厂商例程使用该 ID |
| 应答匹配 | 按 addr/code/checksum | 回传 ID 不确定，避免依赖唯一 ID |
| 运动语义 | ACK 后返回 | 便于三轴先后下发，之后分别等待 |
| 位置单位 | counts + 圈/度 | 精度和易用性兼顾 |
| 回零 | v1 不做 | 三轴行程小于 1 圈，单圈绝对定位够用 |
| 绝对限制 | ±51200 | 防止多圈绝对目标，不是机械限位 |
| 地址配置 | 屏幕菜单 | 避免总线批量改地址导致三台同时变更 |
| 重试 | 相对运动不重试 | 防止重复走位 |
| 接收方式 | 轮询 | 裸机简单可靠，v1 不需要异步 |
| 示例 | 默认关闭 | 防止上电自动动作 |

---

**文档结束**
