SunXingzhi/topping_machine/electrical/下位机控制板_原理图设计文档_v0.3.md

# 下位机控制板 PCB 原理图设计文档（v0.3）

> 范围：电源输入与分配、电源隔离、STM32 最小系统、CAN 总线（SN65HVD230）、主机接口（Windows PC 为主 / 树莓派 5B 预留）、3× 正点原子 PD42S1【光耦-CAN版 + 42电机】接口、调试接口、急停回路。
> 不含：无刷主轴电调、红外接收、蜂鸣/LED（本板预留扩展接口，v0.4 增补）。
> 状态：**原理图绘制前置输入**，本文档冻结后开始画原理图。

## 版本记录

| 版本 | 日期 | 变更 |
| --- | --- | --- |
| v0.1 | 2026-10-29 | 初稿：Pi5B 上位机 + CAN 隔离架构 |
| v0.2 | 2026-10-29 | ①上位机切换为 Windows PC，树莓派降为预留接口；②电机锁定正点原子 PD42S1【光耦-CAN版 + 42电机】；③电机接口改为 XH2.54 排线，补 CAN 波特率/地址/电流实参；④急停使能链适配光耦共阳输入；⑤新增 Lim 到位信号回采 |
| v0.3 | 2026-10-30 | ①电源规格锁定 24V/15Ah，接口待定；②依据固件协议文档（基于官方手册 V1.2）关闭 O1 大部分待办：CAN 扩展帧/主机 0x1000、自定义协议功能码表、控制口 9 信号线序；③J_TERM 改默认不贴（电机自带 120Ω，以 60Ω 实测为准）；④新增 MODBUS 失能与终端电阻验收项；⑤硬件 EN 极性降级为实测项（固件走 CAN 软使能 0xFA） |

---

## 0. 与 README v0.2 的差异声明（需评审确认）

| # | README v0.2 | 本板实际 | 处理 |
| --- | --- | --- | --- |
| C1 | 树莓派 4B 上位机 | **Windows PC 为主上位机**（板载 UART1 + USB-TTL 直连），树莓派 5B 接口保留为部署选项 | 待评审后更新 README |
| C2 | STM32F407 核心板 + 脉冲发生 | **STM32F103C8T6（LQFP48）**，脉冲发生取消，改为 CAN 指令控制闭环驱动器 | 同上 |
| C3 | 关节驱动：57 机座闭环步进 + 行星减速（D4） | **3× 正点原子 PD42S1【光耦-CAN版 + 42电机】**，CAN 总线直连 | 42 与 57 机座冲突，D4 需按扭矩校核结果裁决 |
| C4 | 通信：UART 115200（Pi↔STM32） | 保留 UART（主机↔STM32 状态机协议不变），新增 **CAN 500 kbps**（STM32↔电机） | 两级链路并存 |

## 1. 系统架构

```text
                        ┌────────────────────────────────────────────┐
  24V 电池 ──┬─ 熔断+防反接+TVS ─ 24V_M 动力轨 ──┬─ X3 PD42S1#1 (24V+光耦控制) │
             │                                  ├─ X4 PD42S1#2              │
             │                                  └─ X5 PD42S1#3              │
             │                                                            │
             ├─ BUCK1 5V/5A【选装, 默认DNP】──► 树莓派5B（部署选项，预留）  │
             │                                                            │
             └─ BUCK2 5V/1A ─► 3V3_SYS(LDO) ─► STM32F103C8T6 ── USART1 ── 主机接口
                                    │  3V3_SYS     │ PA12 TX / PA11 RX    ├ Windows PC: USB-TTL
                                    │              ▼                       └ 树莓派5B: 40-pin排母(预留)
                                    │        ISO7721 数字隔离器  ◄─ 3V3_ISO（隔离域）
                                    │              ▼
                                    │        SN65HVD230（VCC=3V3_ISO）
                                    │           │ CANH/CANL（GND_ISO 参考域）
                                    └─ 24V→5V 隔离 DC-DC（B2405S-2WR3）+ LDO
                                                   │
   急停常闭触点(干接点) ══════ 硬件使能链 ══════► 3× PD42S1 EN（共阳光耦输入，不经过软件）
```

- **主运行形态**：Windows PC 跑上位机（感知/逆解/状态机），经 USB-TTL 接本板 UART1；前期调试同样用 Windows/WSL2 主机（usbipd-win 接入 ST-Link 与串口）。
- **部署选项**：树莓派 5B 接口（40-pin 排母 + 选装 5V/5A 供电）保留在板上，量产形态如需边缘化部署直接换 Pi，无需改板。
- **职责**：STM32 只做 CAN 电机指令收发、状态机翻译、遥测汇聚；上位机职责不变（README §7）。

## 2. 电源设计

### 2.1 电源域划分

| 电源域 | 电压 | 来源 | 负载 | 隔离 |
| --- | --- | --- | --- | --- |
| 24V_M 动力域 | 24 V（电池 20–27 V） | 电池直入 | 3× PD42S1（V+ 输入 12–32V，建议 24V） | — |
| 5V_SYS / 3V3_SYS 逻辑域 | 5 V / 3.3 V | BUCK2 + LDO | STM32、调试口、光耦 COM 上拉 | 与 24V_M 非隔离但独立轨 |
| 5V_PI【选装】 | 5 V | BUCK1 | 树莓派 5B（部署选项） | 与 24V_M 非隔离 |
| **5V_ISO / 3V3_ISO / GND_ISO CAN 隔离域** | 5 V / 3.3 V | 隔离 DC-DC + LDO | SN65HVD230、隔离器副边 | **与全板隔离** |

### 2.2 24V 输入与保护（依次串联）

```text
电池+ ── X1(接口待定: 5.08端子 / XT60, 二者留一) ── F1 保险丝 15A ── TVS SMCJ26A(对地) ──
       防反接 PMOS(AOD4185, Rds<10mΩ, 栅极稳压+RC缓启) ── 共模磁环(选配) ── 24V_M 母线
电池- ── X1 ── PGND
母线入口并联: 2× 470µF/35V 低ESR 电解 + 10µF/100nF 陶瓷
```

- **电池规格：24V / 15Ah**（≈360 Wh）。TVS 选 **SMCJ26A**（LiFePO4 8S 满电 ≈26.4 V，standoff 26 V，钳位 ~42 V，1500 W）。
- 防反接用 PMOS 而非二极管：9 A 峰值下二极管损耗 >12 W，PMOS 损耗 <1 W。
- 分支熔断：每路电机 **F2/F3/F4 = 3.15A 慢断**（PD42S1 单台最大输入 3 A），Pi/逻辑支路 2A。

### 2.3 DC-DC 选型

| 编号 | 轨 | 选型（首选/备选） | 理由 |
| --- | --- | --- | --- |
| BUCK1 | 5V_PI 5A【**默认 DNP**】 | TPS5450（36V/5A） | 仅 Pi 上板供电时贴装；Pi 用官方电源时留空 |
| BUCK2 | 5V_SYS 1A | LMR51430 / MP1584EN | STM32 逻辑 <150 mA，留裕量 |
| DCDC1 | 5V_ISO 2W | **金升阳 B2405S-2WR3** | CAN 副边功耗 <100 mW，2W 足够 |
| LDO1 | 3V3_SYS | AMS1117-3.3（或 ME6211C33） | 5V→3.3V，Δ=1.7V 可压差 |
| LDO2 | 3V3_ISO | ME6211C33 / XC6206 | 隔离域内 5→3.3V，供 SN65HVD230 |

- Pi 供电跳线 J_PI_PWR：BUCK1 输出 / USB-C PD 诱骗器 二选一（**禁止同时供电**）；经 GPIO 5V 供电需 `usb_max_current_enable=1`。

### 2.4 功率预算

| 负载 | 峰值 | 典型 | 备注 |
| --- | --- | --- | --- |
| PD42S1 ×3 | 3 A/台 → **9 A** | ~1.5 A 合计 | 单台最大输入 3A（官方手册）；三轴同时加速为峰值工况 |
| Pi 5B（选装） | 5 A@5V | 1.5 A@5V | 满载 25 W |
| STM32 逻辑 | 0.15 A@5V | 0.05 A@5V | — |
| **24V 总需求** | **~10 A 峰值 / 250 W 峰值** | ~2 A / 50 W | 不含 Pi；Pi 上板时加 5A@5V ≈ 1.1A@24V |

- 电池 **24V/15Ah** 需支持 ≥12 A 放电（0.8C，常见动力电池满足）[待核定电芯规格]；主板 24V_M 铺铜 ≥4 mm 宽 @2oz，连接器端就近加粗铺铜。
- 续航估算：典型作业功耗 ~50 W（电机 1.5A 合计 + 逻辑）→ 360 Wh ÷ 50 W ≈ **7 h**；峰值工况（三轴同时加速 250 W）→ ≥1.4 h，均远超单日打顶作业需求。

## 3. CAN 总线设计（核心）

### 3.1 拓扑、帧格式与地址规划

```text
[STM32节点：本板, 总线一端] ══ CANH/CANL ══ [PD42S1#1 ID=01] ── [#2 ID=02] ── [#3 ID=03]
```

**帧格式与传输规则（已由固件协议文档冻结，来源：官方手册 V1.2，见 [PD42S1_Motor_Driver_Requirements_Design_v1.0.md](file:///c:/Users/q1325/Documents/Project/topping_machine/firmware/STM32F103C8T6/docs/PD42S1_Motor_Driver_Requirements_Design_v1.0.md)）：**

- **扩展帧（29-bit ID）**：主机发送固定 `0x1000`；应答不依赖回传 ID（回传 ID 由 `0x6C` 配置、未确认），固件按报文内 `addr+功能码+校验和` 匹配——硬件无需为 ID 做任何处理。
- 协议帧 `0xC5 + addr + code + data + checksum + 0x5C`，校验和 `(0xC5+addr+code+Σdata)&0xFF`，大端序；一帧最长 13 字节 → 拆 2 个 CAN 报文，指令间隔 ≥2 ms。
- **CAN 版仅支持正点原子自定义协议，MODBUS 必须失能**（面板菜单配置）。
- **PD42S1 默认从机地址 01H，三台逐台面板改为 01/02/03**（固件按 1/2/3 固定）。
- 500 kbps 与固件位时序匹配（§3.2）。

**终端电阻（v0.3 修订）：** PD42S1 **每台自带 120 Ω**，SN65HVD230 板也常带——全保留会过终端。本板 **J_TERM 默认不贴（DNP）**，联调时以「断电实测 CANH–CANL ≈ 60 Ω」为准调整：仅保留总线两端各一个终端（本板或边缘电机）。

- 拓扑为直线菊花链，支线 ≤0.3 m；CANH/CANL 双绞。
- TVS **PESD1CAN**、共模扼流圈 AC3225 选贴保留。

### 3.2 位时序核对（闭式推导）

APB1 = 72/2 = 36 MHz：

```text
TQ   = Prescaler / APB1 = 9 / 36MHz = 250 ns
位时间 = (1 SYNC + 6 BS1 + 1 BS2) × TQ = 8 × 250 ns = 2 µs  →  500 kbps
采样点 = (1+6)/8 = 87.5 %   ← CiA 推荐 87.5%@500k
SJW  = 2 TQ
```

### 3.3 SN65HVD230 外围（原理图逐脚）

```text
                 3V3_ISO
                   │ 100nF + 10µF
  ISO7721 out ──► D(1)  SN65HVD230  CANH(7) ──► 总线 CANH
  ISO7721 in  ◄── R(4)               CANL(6) ──► 总线 CANL
                   Vref(5) NC        RS(8) ── 0Ω ── GND_ISO   (高速模式)
                                              └─(备选) 10k + 10nF 斜率控制, EMC 超标时切换
```

- HVD230 为 **3.3 V 收发器**，与 STM32 及隔离器电平天然匹配。
- 总线端：120 Ω 端接电阻串 **跳线 J_TERM（默认 DNP**，见 §3.1 终端电阻修订）；TVS **PESD1CAN**；共模扼流圈 AC3225 选贴。
- 隔离器 **ISO7721DR**：VCC1=3V3_SYS / VCC2=3V3_ISO，两侧各 100 nF。备选集成方案：金升阳 **CTM8251T**（一体化隔离收发器）——**本板按 ISO7721+HVD230 画，CTM8251 留兼容方案不画**。

### 3.4 隔离定位说明（诚实声明）

3 台 PD42S1 与本板共用同一块 24V 电池，**电机侧 CAN 参考地与 24V_M 本就连通**，因此本隔离是**功能隔离而非安规隔离**：切断 CAN 线缆长距离共模地环路、阻断驱动器开关噪声地弹注入。若后续电机改独立供电，自动升级为真隔离，无需改图。

> 注意：PD42S1 光耦-CAN 版在**电机侧**对 CAN 口已做光耦隔离——本板侧隔离与其叠加，共模抑制链路完整。

## 4. STM32 最小系统（STM32F103C8T6，LQFP48）

| 项目 | 设计 |
| --- | --- |
| 时钟 | HSE 8 MHz 晶振 + 2×18 pF，PLL×9 = 72 MHz（与 .ioc 一致） |
| 复位 | NRST 10 kΩ 上拉 + 100 nF + 复位按键 |
| BOOT0 | 10 kΩ 下拉 + 跳线（拉高进串口下载） |
| SWD | PA13 SWDIO / PA14 SWCLK → 4P SWD 排针（3V3/GND/SWDIO/SWCLK） |
| 解耦 | 每对 VDD/VSS 100 nF，VDDA 100 nF + 1 µF + 磁珠 FB 自 VDD |
| CAN | PA11=CAN_RX、PA12=CAN_TX（**F103 上 USB 与 CAN1 共用 PA11/12，本板无 STM32 USB 口**，下载调试全走 SWD+串口） |
| 电池采样 | PA0/ADC0 ← 68k/10k 分压（24 V→3.07 V），节点 10 nF |
| Lim 到位回采 | PB3/PB4/PB5 ← 3× PD42S1 Lim 输出（0–3.3V 直入，输入加 100nF + 上拉；**PB3/PB4 默认为 JTAG 引脚，固件需 AFIO 重映射释放**） |

预留（贴 0Ω 或排针，不贴器件）：PB6/PB7（I2C1，OLED/IMU 扩展）、PB0/PB1（ADC，主轴电流采样扩展）、PB10/PB11（USART3，红外接收扩展）、PB12（急停软使能门控）。

## 5. 主机接口（Windows PC 为主 / 树莓派 5B 预留）

### 5.1 UART1 共享总线（两主机互斥使用）

STM32 USART1（PA9 TX / PA10 RX）经 3P 2.54mm 排针 X6（TX/RX/GND）引出，串 100 Ω + 双向 TVS（PESD3V3）：

- **Windows PC（主）**：USB-TTL 适配器（CP2102/CH340）直插 X6，串口协议沿用 README §4 帧格式（0xAA 0x55 | CMD | LEN | PAYLOAD | CRC16-CCITT），CMD 表不变。
- **树莓派 5B（预留）**：X6 线序同时连至 J7 排母的 GPIO14/15（见 5.3）；**同一时刻只能接一个主机**，板上丝印注明。

### 5.2 树莓派 5B 预留接口（部署选项）

| Pi 引脚 | 信号 | 去向 |
| --- | --- | --- |
| 2/4 | 5V | BUCK1 5V_PI（选装）或 J_PI_PWR 切 PD 诱骗 |
| 6/9/14/… | GND | PGND |
| 8 (GPIO14 TXD) | Pi TX | → STM32 PA10 |
| 10 (GPIO15 RXD) | Pi RX | ← STM32 PA9 |

- 双方 3.3 V 电平，同板共地直连；Pi 侧配置 `enable_uart=1`。
- **备选方案（记录不做）**：Pi 经 MCP2515 直挂 CAN——放弃，与"实时指令归 STM32"的职责划分冲突。

## 6. PD42S1 电机接口（×3 相同）

连接器 X3/X4/X5：**XH2.54 排母**，与 PD42S1 控制口排针配对，使用官方同规格排线（XH2.54 端子压接）。控制口信号共 9 个（实机评测与手册一致）：

| # | 信号 | 方向 | 说明 |
| --- | --- | --- | --- |
| 1 | V+ | →电机 | 12–32V，建议 24V；各支路 3.15A 慢断熔断 + 就地 470 µF/35 V + 100 nF |
| 2 | GND | →电机 | 动力地 |
| 3 | COM | →电机 | 光耦公共端，**光耦版仅支持共阳，输入 3.3–5V** → 本板接 3V3_SYS |
| 4 | EN | →电机 | 使能/右限位，输入 0V~COM；经本板硬件使能链（§7）开漏驱动，**硬件 EN 为可选项**（见 §7） |
| 5 | STP | →电机 | 脉冲输入（CAN 模式不用，预留，接排针跳线默认断开） |
| 6 | DIR | →电机 | 方向/左限位/IO启停（CAN 模式不用，预留） |
| 7 | CAN_H | ↔ | 总线 CANH（非隔离域走差分规则） |
| 8 | CAN_L | ↔ | 总线 CANL |
| 9 | Lim | ←电机 | 到位输出 0–3.3V：到位=低，未到位=高 → STM32 PB3/PB4/PB5 |

> 控制口实际针序（XH 排线上 1~9 的物理顺序）以官方手册接线图为准，画原理图前与到货实物核对一次 [O1 遗留项]。
> 电机动力线（A+/A-/B-/B+）为 PD42S1 与 42 电机之间的配套线，不经过本板。
> **固件侧使能完全走 CAN（0xFA），硬件 EN 引脚仅脉冲模式必需**——本板硬件使能链作为急停冗余层保留，不接也不影响固件联调。

## 7. 急停与硬件使能链

README 约定"急停为纯硬件回路，不经过任何软件"。PD42S1 光耦版 EN 输入为**共阳光耦**（COM=3V3_SYS 上拉源），本板实现为两级串联、低电平有效：

```text
ESTOP_IN(端子, 外接常闭急停钮) ──► 光耦OC1(EL357) ──► ESTOP_OK(高=安全)
ESTOP_OK ──AND── STM32_EN_GATE(PB12, 上电默认低=禁止) ──► OC缓冲器(74HC07开漏) ──► EN_ALL(极性可配) → 3× PD42S1 EN
```

- 急停拍下 → ESTOP_OK=低 → 74HC07 输出高阻 → EN 由 3V3_SYS 经 COM 路径上拉至禁止电平 → 电机失能。
- **使能层级说明（v0.3）**：固件已实现 CAN 软使能（`0xFA`，0=使能）与广播刹车（`0xFC`/广播地址 0），急停时上位机/固件还会执行 `Motor_StopAll()`。硬件 EN 链是**独立于软件的兜底层**，其极性（拉低使能还是拉高使能）手册未给出明确值，**到货后实测确认**，板上用跳线 J_EN_POL 兼容两种极性；不接 EN 也不阻塞固件 P6 联调。
- STM32_EN_GATE 仅软件"补刀"，硬件链失效时仍独立断使能——两级缺一不可。
- **本板不切动力电**（9 A 回路用急停触点直接切 24V_M 会烧触点，属配电箱级方案，v0.4 讨论）。

## 8. 调试支持（Windows / WSL2 工作流）

| 接口 | 用途 | WSL2 接入方式 |
| --- | --- | --- |
| SWD 4P 排针 | 烧录/调试固件 | usbipd-win 绑定 ST-Link → WSL2 内 OpenOCD/pyOCD |
| UART1 X6 排针 | PC 走协议联调 | USB-TTL 插 Windows 串口终端，或 usbipd 进 WSL2 跑 Python 收发脚本 |
| 测试点 TP×8 | 24V_M / 5V_SYS / 3V3_SYS / 3V3_ISO / GND_SYS / GND_ISO / CANH / CANL | 示波器/逻辑分析仪 |
| （选贴）USB-CAN 分析仪座 | 总线抓包 | 桌面临时接入 |

- 联调顺序：SWD 空板点亮 → CAN 回环模式自测 → 单电机（ID=01）点动 → 逐台改 ID → 三电机同调 → 接 Windows 上位机 → （部署期）换 Pi。
- 固件构建沿用仓库 CMake + arm-none-eabi 工具链；`.ioc` 的 CAN 参数即硬件输入，**改波特率必须同改本文档 §3.2**。
- PD42S1 单台可先用官方 ATK_PDxx 上位机（USB-TTL 接其控制口）验证功能，再接入本板。

## 9. 关键器件清单（原理图 BOM 骨架）

| 位号 | 器件 | 规格/料号建议 |
| --- | --- | --- |
| U1 | MCU | STM32F103C8T6 |
| U2 | CAN 收发器 | SN65HVD230DR |
| U3 | 数字隔离器 | ISO7721DR（备选 ADuM1201ARZ） |
| U4 | 隔离 DC-DC | B2405S-2WR3 |
| U5 | BUCK 5V/5A【DNP】 | TPS5450 |
| U6 | BUCK 5V/1A | LMR51430 |
| U7/U8 | LDO 3.3V | AMS1117-3.3 / ME6211C33 |
| U9 | 光耦 | EL357（急停输入） |
| U10 | 开漏缓冲 | 74HC07D（使能链） |
| D1 | TVS 输入 | SMCJ26A |
| D2 | TVS CAN | PESD1CAN |
| Q1 | 防反接 PMOS | AOD4185 / SUP53P06 |
| F1–F4 | 保险丝 | 15A + 3.15A×3（慢断） |
| X1 | 电源端子【型式待定】 | 5.08mm-2P 端子 / XT60 二选一（电池 24V/15Ah） |
| X2 | 急停端子 | 5.08mm-2P |
| X3–X5 | 电机连接器 | **XH2.54-9P 排母**（针数以官方手册核定） |
| X6 | 主机串口 | 2.54mm-3P 排针 |
| X7 | 树莓派排母 | 2×20 2.54 排母（预留） |
| J_TERM / J_PI_PWR / J_EN_POL | 跳线 | 2P/3P 排针+帽 |

## 10. PCB 布局布线要点

1. **分区**：板面按「动力 24V_M → DC-DC → STM32 → 隔离区 → CAN 端子」一条流向布局，动力与逻辑地单点汇于防反接 PMOS 源极。
2. **隔离区**：GND_ISO 与 GND_SYS 间距 ≥ 4 mm，隔离带下方开 2 mm 长槽（DCDC1、ISO7721 跨槽骑放），隔离区禁止其他走线穿越。
3. **CAN 差分**：CANH/CANL 平行走线，线宽 0.5 mm、间距 0.2 mm，远离 24V_M 与 BUCK 开关节点 ≥5 mm。
4. **BUCK**：输入环路面积极小化，SW 节点铺铜收窄，反馈线远离开关节点；两片 BUCK 各自独立地岛汇入 PGND。
5. **动力铜皮**：24V_M 主干铺铜 + 镀锡，支路电流路径避免经过信号区。
6. **板框**：2 层板、2oz 铜厚、4× M3 安装孔、板边 5 mm 禁布区；尺寸随机构安装孔位 [待定：与机械组对齐]。

## 11. 上电与验收清单

```text
□ 空板（不插芯片）：24V 极性/防反接、各域电压、静态电流 < 30 mA
□ 插 STM32：SWD 识别、72 MHz 时钟、3.3V 波纹 < 50 mV
□ 接线前检查（对应固件文档 §6.4）：三台驱动器地址逐台设为 1/2/3；CAN 速率 500 kbps；MODBUS 失能；断电实测 CANH–CANL ≈ 60 Ω（过多终端先拔 J_TERM/电机端跳线）；三节点共地
□ CAN 回环模式收发自测；上 1 台电机（addr=01）Motor_Ping 在线；三台在线，错误帧率 = 0（10 min）
□ 急停拍下：EN_ALL < 10 ms 释放（示波器实测）+ Motor_StopAll 三台停止；恢复需手动复位按钮
□ Lim 回采：手转电机轴，PB3/PB4/PB5 电平跳变正确
□ Windows 主机：USB-TTL 心跳帧 ≥ 20 Hz，拔主机不影响电机待机
□ 隔离测试：GND_SYS–GND_ISO 间绝缘电阻 > 100 MΩ@250VDC
```

## 12. 开放问题（冻结前必须关闭）

| # | 问题 | 归属 | 状态 |
| --- | --- | --- | --- |
| O1 | ~~PD42S1 CAN 帧格式、自定义协议指令集、控制口信号~~ **已关闭**（v0.3，依据固件协议文档/官方手册 V1.2）；遗留：①XH 排线物理针序与到货实物核对；②硬件 EN 极性到货实测（J_EN_POL 兼容）；③0xF2/0xF3 帧 13 vs 14 字节（固件 R-03，联调确认） | 硬件+固件联调 | **基本关闭** |
| O2 | README C1–C4 差异项评审（Windows 主机、F103、42 机座、CAN 架构） | 评审会 | 待办 |
| O3 | ~~电池规格~~ **已关闭**：24V/15Ah，≥12A 放电满足；**遗留：电池输出接口型式待定**（X1 留 5.08 端子/XT60 二选一） | 电源组 | 接口待定 |
| O4 | 主轴电调/红外/蜂鸣并入本板 v0.4 还是独立扩展板 | 下版方案 | 待办 |
| O5 | 板尺寸与安装孔位（对机械组电控舱） | 机械组 | 待办 |
| O6 | BUCK1/Pi 供电是否保留贴装（取决于部署形态评审） | 评审会 | 待办 |

---

*v0.3 2026-10-30 · 协议依据：firmware/STM32F103C8T6/docs/PD42S1_Motor_Driver_Requirements_Design_v1.0.md（源自官方手册 V1.2 + 正点原子控制协议 V1.2）· PD42S1 硬件参数：供电12–32V建议24V、最大3A/台、CAN 500Kbps、光耦版COM共阳3.3–5V、Lim到位输出0–3.3V、自带120Ω终端*
