SunXingzhi/topping_machine/simulation/delta_arm/Kinematics/02_约束建模.md

# Delta 机械臂约束建模（约束版）

> **定位**：在《01_运动学建模.md》的纯几何结论之上，叠加真实硬件约束，给出可作业工作空间与约束版逆解判定。
> **推导复用**：正解、几何环面判据、逆解闭式解均直接引用上一版结论，本文只做约束建模与裁剪分析。
>
> **参数**：$R=139$，$r=39$，$L=140$，$l=200$（mm），平台端 SQZ6-RS 球铰 $L_1=28\,\mathrm{mm}$、$\Gamma_{\text{plat}}=15^\circ$（总摆角 $30^\circ$）。
>
> **2026-11 修正**：$A_i$ 改为 $\mathbf{P}+r\mathbf{u}_i+L_1\mathbf{h}_i$；本文 §0、§2.1、§6 与附录 B 的逆解已按此更新。§4、§5、§8 的数值表仍是 40°/45° 旧假设的历史结果，仅作方法对照；SQZ6-RS 15° 的新结果见 README 与 `workspace_analysis.py`（全部满足 7,407 点、Z $-330.5\sim-226.3\,\mathrm{mm}$、最大半径 $58.7\,\mathrm{mm}$）。

---

## 0. 直接复用的结论

以下三条在本文中不再推导，只引用：

**① 正解**（三球求交）：

$$
\mathbf{E}_i = \left[(R-r-L_1\sin\delta_s)+L\cos\theta_i\right]\mathbf{u}_i
+ \left(L\sin\theta_i-L_1\cos\delta_s\right)\hat{\mathbf{z}},
\qquad
\mathbf{P} = \mathbf{m} \pm \gamma\,\mathbf{n}
\tag{0.1}
$$

**② 几何可达判据**（单腿环面）：

$$
\left(\rho_i-L\right)^2+b_i^2 \ \le\ l^2\ \le\ \left(\rho_i+L\right)^2+b_i^2,
\qquad
\rho_i=\sqrt{a_i'^2+z_{e,i}^2}
\tag{0.2}
$$

**③ 逆解**（逐腿圆–圆求交）：

$$
\theta_i=\psi_i\pm\arccos\!\left(\frac{d_i}{\rho_i}\right),
\qquad
d_i=\frac{a_i'^2+b_i^2+z_{e,i}^2+L^2-l^2}{2L},
\qquad
\psi_i=\operatorname{atan2}(z_{e,i},\ a_i')
\tag{0.3}
$$

其中局部坐标

$$
a_i=\mathbf{P}\cdot\mathbf{u}_i,\quad
b_i=\mathbf{P}\cdot\mathbf{t}_i,\quad
a_i'=a_i+r+L_1\sin\delta_s-R,\quad
z_{e,i}=P_z+L_1\cos\delta_s
\tag{0.4}
$$

**几何工作空间上界**（无约束）：纯几何 $Z\in[-350.2,\ +310.6]$，最大半径约 $199\,\mathrm{mm}$。叠加 SQZ6-RS 15° 球铰后实际可作业区为 $Z\approx-330.5\sim-226.3\,\mathrm{mm}$、最大半径 $58.7\,\mathrm{mm}$。

---

## 1. 约束清单

| # | 约束 | 数学形式 | 作用对象 | 影响的区域 |
|---|---|---|---|---|
| C1 | 主动臂行程 / 电机转角 | $\theta_i\in[\theta_{\min},\theta_{\max}]$ | 各腿独立 | 上下两端锥尖 |
| C2 | 臂端关节（当前为十字万向节） | $\alpha_i\le160^\circ,\ \beta_i\le90^\circ$；备选球铰方案为 $\hat{\mathbf{b}}_i\cdot\hat{\mathbf{s}}_i(\theta_i)\ge\cos\Gamma_{\text{arm}}$ | 各腿独立 | 高 $z$ 区 |
| C3 | 平台端球铰（SQZ6-RS） | $-\hat{\mathbf{b}}_i\cdot\hat{\mathbf{h}}_i\ge\cos15^\circ$ | 各腿独立 | 大半径区 |
| C4 | 杆间干涉 | $\operatorname{dist}(\text{rod}_k,\text{rod}_j)>d_{\text{rod}}$ | 6 根杆两两 | 内圈交叉区 |
| C5 | 奇异裕度 | $\left|d_i/\rho_i\right|\le\kappa,\ \kappa<1$ | 各腿独立 | 工作空间边界薄层 |

此外还有一类**结构约束不进入计算**：平行四边形的叉口间距 $d_{\text{fork}}$ 是设计常量，只要 $d_{\text{fork}}>d_{\text{rod}}$ 就永不干涉（同腿两杆始终平行）。

---

## 2. 约束量的几何定义

### 2.1 从动臂单位方向

$$
\hat{\mathbf{b}}_i=\frac{\mathbf{A}_i-\mathbf{B}_i}{l}
=\frac{\left(\mathbf{P}+r\mathbf{u}_i+L_1\mathbf{h}_i\right)-\mathbf{B}_i}{l}
\tag{2.1}
$$

方向从肘点 $\mathbf{B}_i$ 指向动铰点 $\mathbf{A}_i$。

### 2.2 主动臂方向

$$
\hat{\mathbf{a}}_i=\frac{\mathbf{B}_i-\mathbf{C}_i}{L}
=\cos\theta_i\,\mathbf{u}_i+\sin\theta_i\,\hat{\mathbf{z}}
\tag{2.2}
$$

### 2.3 臂端球窝轴（随主动臂转动）

球窝固定在主动臂末端的叉口上，因此它相对主动臂的偏置角是常量。取「主动臂下垂」位姿作为安装基准，则球窝轴等于把主动臂方向在腿的径向平面内反向旋转一个固定角 $\delta_0$：

$$
\hat{\mathbf{s}}_i(\theta_i)=\cos\left(\theta_i-\delta_0\right)\mathbf{u}_i+\sin\left(\theta_i-\delta_0\right)\hat{\mathbf{z}}
\tag{2.3}
$$

**安装基准角**由几何决定：主动臂下垂（$\theta_i=-90^\circ$）、动平台居中时，平台端球心相对静铰点的径向差为 $R-r-L_1\sin\delta_s$，从动臂与竖直方向的夹角为

$$
\delta_0=\arcsin\frac{R-r-L_1\sin\delta_s}{l}
\tag{2.4}
$$

代入数值：

$$
\delta_0=\arcsin\frac{139-39-28\sin45^\circ}{200}
=\arcsin\frac{80.2}{200}=23.6^\circ
$$

该值的作用是让球铰锥角的行程**围绕中间展开**，而不是从一侧极限起步。注意加入 $L_1$ 后该角从旧版的 $30^\circ$ 变为 $23.6^\circ$；当前方案臂端为万向节，$\delta_0$ 只对备选球铰方案生效。

### 2.4 平台端球窝轴（固定在动平台）

动平台姿态被平行四边形锁死，因此平台端球窝轴在空间中方向恒定：

$$
\hat{\mathbf{h}}_i=\sin\delta_s\,\mathbf{u}_i+\cos\delta_s\,\hat{\mathbf{z}}
\tag{2.5}
$$

本条**不按行程居中取值**：实际结构为球窝安装面与动平台平面成 $135^\circ$，球窝轴垂直于安装面，故相对竖直外倾

$$
\delta_s=135^\circ-90^\circ=45^\circ
\tag{2.5a}
$$

> 对比：加入 $L_1$ 后行程居中角为 $\delta_0=23.6^\circ$（式 2.4），于是标定位姿的平台端锥角为
>
> $$\gamma_{\text{plat}}(\theta=-90^\circ)=\delta_s-\delta_0=45^\circ-23.6^\circ=21.4^\circ$$
>
> 而 SQZ6-RS 只有 $\Gamma_{\text{plat}}=15^\circ$，所以**θ=-90° 标定位姿已超出球铰锥角**，实际可用下限约 θ=-81.5°（Z≈-330.5 mm）。若把安装角改到约 36°（从竖直量），可把标定位姿拉回锥角内；不改安装角时，控制上应把关节行程下限从 -90° 收到约 -81.5°。

### 2.5 三个角度量的汇总

| 角度 | 定义 | 参考基准 | 典型规格 |
|---|---|---|---|
| $\theta_i$ | 主动臂转角 | 水平径向 | 与电机行程耦合 |
| $\gamma_{\text{arm},i}$ | $\angle\left(\hat{\mathbf{b}}_i,\hat{\mathbf{s}}_i\right)$ | 臂端球窝轴 | 备选球铰方案 $25^\circ\sim45^\circ$；当前万向节用 α/β |
| $\gamma_{\text{plat},i}$ | $\angle\left(-\hat{\mathbf{b}}_i,\hat{\mathbf{h}}_i\right)$ | 平台端球窝轴 | **SQZ6-RS 15°**（总摆角 30°） |

> 注意 $\gamma_{\text{plat}}$ 用的是 $-\hat{\mathbf{b}}_i$（从动平台指向肘点），因为平台上的球窝朝上开口。

---

## 3. 各约束的数学建模

### 3.1 C1 —— 主动臂行程与电机转角

**运动学侧**：

$$
\theta_{\min}\ \le\ \theta_i\ \le\ \theta_{\max}
\tag{3.1}
$$

**执行侧**：电机转角与主动臂转角通过减速比 $G$ 线性对应：

$$
\theta_{m,i}=G\,\theta_i
\tag{3.2}
$$

于是电机侧的限位必须与式 (3.1) 一致换算：

$$
G\,\theta_{\min}\ \le\ \theta_{m,i}\ \le\ G\,\theta_{\max}
$$

本例 $\theta\in[-90^\circ,+60^\circ]$、行程 $150^\circ$，不同减速比下的电机端对应：

| 减速比 $G$ | 电机下限 | 电机上限 | 电机行程 | 折合转数 |
|---|---|---|---|---|
| 10 | $-900^\circ$ | $+600^\circ$ | $1500^\circ$ | 4.17 rev |
| 20 | $-1800^\circ$ | $+1200^\circ$ | $3000^\circ$ | 8.33 rev |
| 50 | $-4500^\circ$ | $+3000^\circ$ | $7500^\circ$ | 20.83 rev |

工程上要区分三层限位：

1. **机械硬限位**：结构挡块，永不可达，作为最后防线。
2. **电机软限位**：驱动器内部设定，按式 (3.2) 换算，略小于机械限位（留 $2^\circ\sim3^\circ$ 主动臂角度的余量）。
3. **运动学软限位**：上位机规划时就拒绝越界，见 §6。

三者必须同源换算，否则会出现「规划通过、驱动拒动」的僵持。

### 3.2 C2 —— 臂端球铰锥角

球铰的允许范围是一个以球窝轴为轴的圆锥。约束写成余弦形式（避免反三角函数，便于向量化）：

$$
\cos\gamma_{\text{arm},i}=\hat{\mathbf{b}}_i\cdot\hat{\mathbf{s}}_i(\theta_i)\ \ge\ \cos\Gamma_{\text{arm}}
\tag{3.3}
$$

其中 $\hat{\mathbf{s}}_i$ 由式 (2.3) 给出，随 $\theta_i$ 一起转动。

**仅对备选球铰方案**：40° 锥角下实测通过率 $0.63\%$，是旧方案的瓶颈。当前方案臂端为十字万向节，C2 用 α/β 判定；加上 SQZ6-RS 15° 平台球铰后，**瓶颈已转移到 C3**（1.49%）。

### 3.3 C3 —— 平台端球铰锥角

$$
\cos\gamma_{\text{plat},i}=-\hat{\mathbf{b}}_i\cdot\hat{\mathbf{h}}_i\ \ge\ \cos\Gamma_{\text{plat}}
\tag{3.4}
$$

取 SQZ6-RS 的 $\Gamma_{\text{plat}}=15^\circ$。平台端球窝轴固定（式 2.5），不随关节转动，因此这条约束只对**动平台的大幅横移**敏感，对纯上下运动不敏感。

实测单独通过率 $1.49\%$，而臂端万向节为 $29.45\%$——**平台端球铰已成为唯一瓶颈**（旧版 40° 假设下的 “3.81%、不是瓶颈” 结论已作废）。

### 3.4 C4 —— 杆间干涉

6 根杆（每腿 2 根，沿切向错开 $d_{\text{fork}}$）两两做线段最短距离：

$$
\operatorname{dist}\left(\text{rod}_k,\ \text{rod}_j\right)\ >\ d_{\text{rod}},
\qquad k<j,\quad k,j\in\{1,\dots,6\}
\tag{3.5}
$$

线段的两个端点：

$$
\text{rod}_k:\quad \mathbf{B}_i \to \mathbf{A}_i,
\qquad
\text{rod}_{k+3}:\quad \mathbf{B}_i+d_{\text{fork}}\mathbf{t}_i \to \mathbf{A}_i+d_{\text{fork}}\mathbf{t}_i
\tag{3.6}
$$

线段–线段最短距离按标准解法（求两线段参数并裁剪到 $[0,1]$）：

$$
\begin{aligned}
\mathbf{d}_1&=\mathbf{q}_1-\mathbf{p}_1,\quad \mathbf{d}_2=\mathbf{q}_2-\mathbf{p}_2,\quad \mathbf{w}=\mathbf{p}_1-\mathbf{p}_2\\
a&=\mathbf{d}_1\cdot\mathbf{d}_1,\ e=\mathbf{d}_2\cdot\mathbf{d}_2,\ b=\mathbf{d}_1\cdot\mathbf{d}_2,\ c=\mathbf{d}_1\cdot\mathbf{w},\ f=\mathbf{d}_2\cdot\mathbf{w}\\
s&=\frac{bf-ce}{ae-b^2},\quad t=\frac{bs+f}{e}
\end{aligned}
\tag{3.7}
$$

$s,t$ 超出 $[0,1]$ 时回代裁剪。

本例 $d_{\text{fork}}=30>d_{\text{rod}}=15$，实测通过率 **100%**，全程不触发。只有在缩小叉口或加粗杆径时才需要关注。

### 3.5 C5 —— 奇异裕度

由逆解式 (0.3)，$\arccos(d_i/\rho_i)$ 在 $|d_i/\rho_i|\to1$ 时导数发散。工程上不宜贴着几何边界作业：

$$
\left|\frac{d_i}{\rho_i}\right|\ \le\ \kappa,\qquad \kappa\in(0.85,\ 0.95)
\tag{3.8}
$$

$\kappa=1$ 即退化为无约束；取 $\kappa=0.9$ 大约削掉边界处 $2^\circ\sim5^\circ$ 的关节角余量，换取可控的逆解灵敏度。

### 3.6 约束合成

可作业工作空间是几何可达集与全部约束的交：

$$
\mathcal{W}_c=\left\{\mathbf{P}\ \middle|\
\begin{aligned}
&\text{FK/IK 有解}\ \wedge\\
&\theta_i\in[\theta_{\min},\theta_{\max}]\ \wedge\\
&\gamma_{\text{arm},i}\le\Gamma_{\text{arm}}\ \wedge\
\gamma_{\text{plat},i}\le\Gamma_{\text{plat}}\ \wedge\\
&\operatorname{dist}(\text{rod}_k,\text{rod}_j)>d_{\text{rod}}\ \wedge\
|d_i/\rho_i|\le\kappa,\quad i=1,2,3
\end{aligned}
\right\}
\tag{3.9}
$$

---

## 4. 裁剪效果实测

### 4.1 各约束单独通过率

采样 $n=101$（每条关节轴 101 档，共 $101^3=1{,}030{,}301$ 个组合），约束参数：$\Gamma_{\text{arm}}=\Gamma_{\text{plat}}=40^\circ$，臂端安装角 $\delta_0=30^\circ$，平台端安装角 $\delta_s=45^\circ$，$d_{\text{fork}}=30$，$d_{\text{rod}}=15$。

| 约束 | 通过点数 | 占比 |
|---|---|---|
| 正解有解 | 168,471 | 16.35% |
| 关节限位 C1 | 1,030,301 | 100.00%（扫描区间即限位区间） |
| **臂端球铰 C2** | **6,504** | **0.63%** |
| 平台端球铰 C3 | 90,489 | 8.78% |
| 杆间干涉 C4 | 1,030,301 | 100.00% |
| **全部满足** | **6,504** | **0.63%** |

关键读数：

- 「全部满足」= C2 的通过数，说明 **C2 单独就决定了整个工作空间**
- C3 的集合包含 C2 的集合，即 C3 在 C2 通过区内从不触发
- C1 与 C4 在本参数下完全不起作用

### 4.2 包络对比

| 指标 | 纯几何（无约束） | 约束后（40° 球铰） | 保留率 |
|---|---|---|---|
| $Z$ 范围 | $-322.5\sim+322.5$ | $-313.2\sim-262.8$ | — |
| $Z$ 行程 | $645.0\ \mathrm{mm}$ | $50.4\ \mathrm{mm}$ | 7.8% |
| 最大半径 | $198.0\ \mathrm{mm}$ | $64.6\ \mathrm{mm}$ | 32.6% |
| 中心轴 $Z$ 行程 | $649.9\ \mathrm{mm}$ | $50.4\ \mathrm{mm}$ | 7.8% |

即 **几何可达范围只是理论上界，真实可作业区约为其 1/13 的长度、1/3 的半径**。

注意 $Z$ 上界被砍到 $-262.8$：不是几何不允许继续上移，而是主动臂一旦抬起、肘角迅速增大，球铰先于几何极限失效。

### 4.3 瓶颈成因的解析解释

中心轴、对称位姿下，臂端锥角随 $\theta$ 的解析关系为

$$
\cos\gamma_{\text{arm}}(\theta)
=-\frac{k\cos\left(\theta-\delta_0\right)+m\sin\left(\theta-\delta_0\right)}{l},
\qquad
k=(R-r)+L\cos\theta,\quad m=\sqrt{l^2-k^2}
\tag{4.1}
$$

$\delta_0=30^\circ$ 时，$\theta=-90^\circ$ 处 $\gamma_{\text{arm}}=0^\circ$（完全居中）；$\delta_s=45^\circ$ 时，同一位置平台端锥角为 $15^\circ$。两条锥角随 $\theta$ 的变化：

| $\theta$ | $-90^\circ$ | $-85^\circ$ | $-80^\circ$ | $-75^\circ$ | $-70^\circ$ | $-65^\circ$ | $-60^\circ$ |
|---|---|---|---|---|---|---|---|
| 臂端 $\gamma_{\text{arm}}$ | $0.0^\circ$ | $9.1^\circ$ | $18.4^\circ$ | $27.9^\circ$ | $37.7^\circ$ | $47.7^\circ$ | $58.2^\circ$ |
| 平台端 $\gamma_{\text{plat}}$ | $15.0^\circ$ | $10.9^\circ$ | $6.6^\circ$ | $2.1^\circ$ | $2.7^\circ$ | $7.7^\circ$ | $13.2^\circ$ |

臂端锥角随主动臂角的平均增益约 **$1.9^\circ/^\circ$**，$40^\circ$ 锥角在 $\theta\approx-69^\circ$ 触顶，即中心轴上消耗了 $21^\circ$ 行程（占 $150^\circ$ 的 $14\%$）。

平台端在 $\theta=-90^\circ\sim-60^\circ$ 区间内始终 $\le15^\circ$，远低于 $40^\circ$——**平台端在这段根本不构成限制**，真正的瓶颈只有臂端。

**结论：臂端锥角随主动臂角的增益约 1.9 倍，$40^\circ$ 规格只能覆盖 $21^\circ$ 有效行程。**

---

## 5. 参数敏感性

### 5.1 球铰锥角 $\Gamma$ vs 可用行程

$n=101$，其余参数同上。

| $\Gamma$ | 有效点 | $Z$ 范围 | $Z$ 行程 | 最大半径 | $\rho=25$ 处行程 | $\rho=50$ 处行程 |
|---|---|---|---|---|---|---|
| $15^\circ$ | 383 | $-312.5\sim-300.1$ | 12.4 | 21.5 | 7.3 | 0.0 |
| $20^\circ$ | 857 | $-313.2\sim-293.4$ | 19.8 | 30.1 | 13.8 | 0.0 |
| $25^\circ$ | 1,638 | $-313.2\sim-287.1$ | 26.1 | 38.9 | 19.7 | 0.0 |
| $30^\circ$ | 2,795 | $-313.2\sim-280.1$ | 33.1 | 47.6 | 26.6 | 7.5 |
| $35^\circ$ | 4,393 | $-313.2\sim-272.5$ | 40.7 | 56.2 | 33.8 | 19.0 |
| $40^\circ$ | 6,504 | $-313.2\sim-262.8$ | 50.4 | 64.6 | 43.3 | 28.0 |
| $45^\circ$ | 9,190 | $-313.2\sim-255.5$ | 57.7 | 72.7 | 52.4 | 38.0 |
| $50^\circ$ | 12,549 | $-313.2\sim-245.8$ | 67.4 | 80.4 | 60.7 | 46.7 |
| $60^\circ$ | 21,405 | $-313.2\sim-224.2$ | 89.0 | 96.7 | 81.3 | 66.1 |

**$Z$ 行程与 $\Gamma$ 近乎线性**：约 $1.5\sim1.8\ \mathrm{mm}$ 行程 / 度锥角。选型时可直接按目标行程反推：

$$
\Gamma \approx \frac{S_Z}{1.7}+12^\circ
\tag{5.1}
$$

（$S_Z$ 为期望的 $Z$ 行程，单位 mm。）

**注意**：普通杆端关节轴承（SI/POS 系列）允许偏摆仅 $\pm12^\circ\sim15^\circ$，对应行程 $8\sim13\ \mathrm{mm}$——不可用。需要选大摆角球头（$\pm25^\circ$ 以上）。

### 5.2 球窝安装偏置 $\delta_s$ vs 可用行程

$\Gamma=45^\circ$，$n=81$。

| $\delta_s$ | 有效点 | $Z$ 行程 | 最大半径 |
|---|---|---|---|
| $0^\circ$ | 2,167 | 37.0 | 59.7 |
| $10^\circ$ | 4,822 | 58.2 | 73.3 |
| $20^\circ$ | 4,822 | 58.2 | 73.3 |
| $30^\circ$ | 4,822 | 58.2 | 73.3 |
| $40^\circ$ | 4,822 | 58.2 | 73.3 |
| $50^\circ$ | 4,822 | 58.2 | 73.3 |

读法：

- $\delta_s=0$（球窝轴竖直）时行程只有 37.0 mm，**损失 36%**
- $\delta_s\ge10^\circ$ 后曲线进入平台区，因为此时 C3 已宽于 C2，不再是瓶颈
- 所以 $\delta_s$ 只需「大致外倾」即可，不需要精确调到某个值；但**绝对不能取 0**。本例实际结构为 $45^\circ$，位于安全区内

### 5.3 关节类型对照：万向节 vs 球铰

同一几何、平台端同为 $40^\circ$ 球铰、$n=101$，只比较下块（可作业区）：

| 臂端关节 | 规格 | 有效点 | $Z$ 行程 | 最大半径 |
|---|---|---|---|---|
| 球头铰链 | 锥角 $40^\circ$ | 6,504 | 50.4 mm | 64.6 mm |
| **十字万向节** | 面内 $160^\circ$ / 面外 $90^\circ$ | **74,512** | **194.2 mm** | **121.2 mm** |

万向节方案的 $Z$ 行程是球铰方案的 **3.9 倍**。

> 早期版本曾用「主动臂与从动臂的夹角 $\le40^\circ$」这一模型，得出「万向节差 5.9 倍」的相反结论。该模型有两个错误：① 把两个方向的摆角合并成一个轴角；② 规格按 $40^\circ$ 的传动轴取值，与钝角万向节的实际能力不符。按 §8.2 的双轴独立限幅修正后，结论完全反转。

前提条件（缺一不可）：

1. 第一销轴必须沿 $\mathbf{t}_i$，否则 $\alpha/\beta$ 分解失效
2. 每杆 $2+3=5$ DOF，恰好不过约束（两端都用万向节会变成 4 DOF，过约束）
3. 背隙需控制在 $0.3^\circ$ 以内，否则平台精度损失 $1\sim3.5\ \mathrm{mm}$

---

## 6. 约束版逆解判定流程

几何上可达（式 0.2）只是必要条件。实际控制前必须逐条检查：

```text
输入：目标 P，上一周期 θ_prev

1. 逆解求两支 θ±            （式 0.3）
   └─ |d_i/ρ_i| > 1  → 拒绝：几何不可达

2. 按连续性从两支中选 θ_i     （|wrap(θ± − θ_prev)| 取小）
   └─ 两支跨度 > 阈值        → 拒绝：接近奇异，轨迹不连续

3. C1 行程检查：θ_i ∈ [θ_min, θ_max]
   └─ 越界 → 拒绝：超程

4. 由 θ_i 反算 B_i，再算 b̂_i
5. C2 臂端万向节：α_i ≤160°、β_i ≤90°（备选球铰方案则为 b̂_i · ŝ_i ≥ cos Γ_arm）
6. C3 平台端球铰（SQZ6-RS）：−b̂_i · ĥ_i ≥ cos 15°
   └─ 任一超限 → 拒绝：关节超摆角

7. C5 奇异裕度：|d_i/ρ_i| ≤ κ
8. C4 干涉：6 杆两两距离 > d_rod
   └─ 超限 → 拒绝：碰撞风险

9. 全部通过 → 输出 θ_i，并换算电机指令
```

拒绝时必须给出**具体原因码**（哪些腿、哪条约束、超了多少），否则现场无法定位是「目标给错」还是「机械不够」。

---

## 8. 备选方案：臂端万向节 + 平台端球铰

### 8.1 与全球铰方案的差别

| 项 | 全球铰（§3） | 本方案 |
|---|---|---|
| 臂端关节 | 球头铰链（3 DOF） | **十字万向节（2 DOF）** |
| 平台端关节 | 球头铰链（3 DOF） | 球头铰链（3 DOF） |
| 单杆自由度 | $3+3=6$（1 个冗余自转） | $2+3=5$（**恰好**，不过约束） |
| 约束形式 | 一个锥角 | **两个独立轴角** |

两种配置下单杆都满足"定长刚性杆需要 5 个自由度"，因此都不产生过约束。平行四边形保证两杆平行，动平台姿态仍被锁死，$\mathbf{A}_i=\mathbf{P}+r\mathbf{u}_i$ 不变，正解与逆解**完全沿用**式 (0.1)(0.3)。

### 8.2 万向节双轴摆角的分解

万向节是两根正交销轴串联，因此必须用**两个独立角度**描述，而不是一个"两轴夹角"。

主动臂绕 $\mathbf{t}_i$ 转动，所以 $\mathbf{t}_i$ 在基座系与主动臂系中都不变——把万向节第一根销轴装成沿 $\mathbf{t}_i$ 是唯一自然的选择：面内摆动只改变肘角，面外摆动只改变切向偏摆，两者解耦。

把从动臂方向在腿的局部系中分解：

$$
\hat{\mathbf{b}}_i=b_r\,\mathbf{u}_i+b_t\,\mathbf{t}_i+b_z\,\hat{\mathbf{z}},
\qquad b_r^2+b_t^2+b_z^2=1
\tag{8.1}
$$

其中

$$
b_r=\hat{\mathbf{b}}_i\cdot\mathbf{u}_i,\qquad
b_t=\hat{\mathbf{b}}_i\cdot\mathbf{t}_i,\qquad
b_z=\hat{\mathbf{b}}_i\cdot\hat{\mathbf{z}}
\tag{8.2}
$$

两个摆角：

$$
\boxed{\
\alpha_i=\operatorname{wrap}\left(\arctan_2\left(b_z,\ b_r\right)-\theta_i\right),
\qquad
\beta_i=\arctan_2\left(b_t,\ \sqrt{b_r^2+b_z^2}\right)
\ }
\tag{8.3}
$$

含义：

- $\alpha_i$：**面内摆角**（绕第一根销轴）——从动臂相对主动臂在径向竖直平面内的张角。$\beta=0$ 时 $|\alpha_i|$ 就等于肘角。
- $\beta_i$：**面外摆角**（绕第二根销轴）——从动臂偏离该平面的角度。因为 $\beta_i=\arcsin b_t$，其物理上限为 $90^\circ$。

> 用式 (8.3) 而不是"$\angle(\hat{\mathbf{a}}_i,\hat{\mathbf{b}}_i)$"是关键修正。后者是两根轴的夹角，把两个方向的摆角混成一个；而万向节的真实限制是**两个方向各自独立限幅**，量级为钝角。

### 8.3 约束形式

$$
\left|\alpha_i\right|\le A_{\max},
\qquad
\left|\beta_i\right|\le B_{\max}
\tag{8.4}
$$

其中 $A_{\max},B_{\max}$ 为万向节单方向允许的钝角极限（例如 $110^\circ$、$120^\circ$）。由于 $\beta_i$ 的定义域本身只有 $\pm90^\circ$，当 $B_{\max}\ge90^\circ$ 时该方向自然不限制，真正的瓶颈回到 $\alpha_i$。

### 8.4 实测裁剪效果

采样 $n=101$，臂端安装角 $\delta_0=30^\circ$，平台端 $\delta_s=45^\circ$，$B_{\max}=90^\circ$：

| $A_{\max}$ | $B_{\max}$ | 平台球铰 $\Gamma_{\text{plat}}$ | 有效点 | $Z$ 范围 | $Z$ 行程 | 最大半径 |
|---|---|---|---|---|---|---|
| $90^\circ$ | $90^\circ$ | $45^\circ$ | 21,792 | $-313.2\sim-224.2$ | 89.0 | 96.7 |
| $100^\circ$ | $90^\circ$ | $45^\circ$ | 33,858 | $-313.2\sim-201.1$ | 112.1 | 108.3 |
| **$110^\circ$** | $90^\circ$ | $45^\circ$ | **49,182** | $-313.2\sim-176.5$ | **136.7** | **118.9** |
| $120^\circ$ | $90^\circ$ | $45^\circ$ | 67,529 | $-313.2\sim-149.4$ | 163.8 | 125.9 |
| $110^\circ$ | $90^\circ$ | $40^\circ$ | 49,182 | $-313.2\sim-176.5$ | 136.7 | 118.9 |
| $110^\circ$ | $90^\circ$ | $50^\circ$ | 49,182 | $-313.2\sim-176.5$ | 136.7 | 118.9 |

两条重要读数：

- **平台球铰取 $40^\circ$、$45^\circ$、$50^\circ$ 结果完全相同**，说明在 $\delta_s=45^\circ$ 的安装角下，平台端已完全不构成限制，瓶颈只在臂端万向节。
- $A_{\max}$ 从 $90^\circ$ 增到 $120^\circ$，行程从 89.0 增到 163.8，**近乎线性**，约 $2.5\ \mathrm{mm}/^\circ$。

各约束通过率（$A_{\max}=110^\circ$，$\Gamma_{\text{plat}}=45^\circ$）：

| 约束 | 通过点数 | 占比 |
|---|---|---|
| 正解有解 | 168,471 | 16.35% |
| 关节限位 C1 | 1,030,301 | 100.00% |
| **臂端万向节 C2** | **49,182** | **4.77%** |
| 平台端球铰 C3 | 140,441 | 13.63% |
| 杆间干涉 C4 | 1,030,301 | 100.00% |
| 奇异裕度 C5 | 1,030,301 | 100.00% |
| **全部满足** | **49,182** | **4.77%** |

「全部满足」= C2 的通过数，说明 **臂端万向节单独决定工作空间**；平台端还有 2.9 倍余量。

中心轴对照：

| $A_{\max}$ | 可用 $\theta$ 区间 | $Z$ 范围 | $\alpha$ 最大值 | $\beta$ 最大值 |
|---|---|---|---|---|
| $110^\circ$ | $-90^\circ\sim-51^\circ$ | $-313.2\sim-176.7$ | $109.1^\circ$ | $0^\circ$ |
| $120^\circ$ | $-90^\circ\sim-48^\circ$ | $-313.2\sim-153.9$ | $117.6^\circ$ | $0^\circ$ |

中心轴上 $\beta\equiv0$（三点对称、无切向分量），全部由 $\alpha$ 限制。

### 8.5 两方案对比

同一几何、同一采样密度 $n=101$、平台球铰同为 $45^\circ$：

| 方案 | $Z$ 行程 | 最大半径 | 有效点 |
|---|---|---|---|
| 全球铰（$\Gamma=45^\circ$） | 57.7 mm | 72.7 mm | 9,190 |
| **万向节 $110^\circ$ + 球铰 $45^\circ$** | **136.7 mm** | **118.9 mm** | 49,182 |
| 万向节 $120^\circ$ + 球铰 $45^\circ$ | 163.8 mm | 125.9 mm | 67,529 |

**万向节 $110^\circ$ 方案把 $Z$ 行程提高到 2.4 倍、半径提高到 1.6 倍**；$120^\circ$ 则是 2.8 倍与 1.7 倍。

### 8.6 采用万向节的代价与工程前提

| 项 | 说明 |
|---|---|
| 背隙 | 冲压叉口型通常 $0.3^\circ\sim1^\circ$；按 $l=200$ 折算平台误差 $1\sim3.5\ \mathrm{mm}$，需选可调预紧型 |
| 销轴相位 | 两杆的万向节第一销轴必须**都沿 $\mathbf{t}_i$**，否则 $\alpha/\beta$ 分解失效、约束算错 |
| 载荷 | 两杆平行分担，单杆轴向力约为总载荷一半 |
| 自转 | 臂端锁死自转、平台端球铰放开，整杆仍为 5 DOF，**无过约束** |
| 维护 | 叉口销轴为易损件，需留润滑与更换通道 |

> 关键：**不能两端都用万向节**。$2+2=4$ 少于定长杆所需的 5，会形成过约束，装配误差无处释放（详见 §5.3 实测差异）。

---

## 9. 选型与作业区间建议

### 9.1 关节规格

| 项 | 建议值 | 依据 |
|---|---|---|
| 臂端关节（球铰方案） | 球铰锥角 $\Gamma\ge 45^\circ$ | 表 5.1，$45^\circ$ 给出 57.7 mm 行程 |
| **臂端关节（万向节方案）** | **$A_{\max}\ge110^\circ$，$B_{\max}\ge90^\circ$** | 表 8.4，$110^\circ$ 给出 136.7 mm 行程 |
| 平台端球铰 | $\Gamma_{\text{plat}}\ge45^\circ$ | 万向节方案下 $45^\circ$ 已不成为瓶颈 |
| 球窝安装偏置 $\delta_s$ | $45^\circ$（安装面 $135^\circ$） | §2.4；实测 $\ge10^\circ$ 即可，但以实际结构为准 |
| 主动臂行程 | $[-90^\circ,+60^\circ]$（现方案） | 球铰方案中心轴有效段约 $[-90,-69]$；万向节方案约 $[-90,-51]$ |
| 叉口间距 $d_{\text{fork}}$ | $\ge 2\,d_{\text{rod}}$ | 保证同腿杆永不干涉 |
| 奇异裕度 $\kappa$ | 0.90 | 削掉边界 $2^\circ\sim5^\circ$ |

### 9.2 一个必须正视的问题（球铰方案）

若采用全球铰方案，当前主动臂行程 $150^\circ$，受 $40^\circ$ 锥角限制，中心轴上的有效段只有约 $21^\circ$：

$$
\frac{\text{有效行程}}{\text{机械行程}}=\frac{21^\circ}{150^\circ}\approx 14\%
\tag{9.1}
$$

电机选型、减速比、编码器分辨率都按 $150^\circ$ 设计，实际只能用其中约七分之一——对减速比精度提出很高要求。

**采用万向节方案可把中心轴有效段提升到约 $39^\circ$（$26\%$）**，$Z$ 行程也从 50.4 mm 提到 136.7 mm，是当前几何下最直接有效的改进。

五条出路：

| 方案 | 做法 | 结果 |
|---|---|---|
| A | 换大摆角球铰（$\Gamma\ge60^\circ$） | $Z$ 行程 89.0 mm，成本上升 |
| B | 减小 $R-r$（收缩静平台或放大动平台） | 降低初始肘角，但横向包络缩小 |
| C | 缩短主动臂行程到 $[-90^\circ,-70^\circ]$ | 利用率提升，但几何 $Z$ 上限只有约 $-266\ \mathrm{mm}$ |
| **D** | **臂端改钝角万向节（$A_{\max}\ge110^\circ$）** | **$Z$ 行程 136.7 mm，中心轴有效段 39°** |
| E | 把主动臂上限从 $+60^\circ$ 收到 $0^\circ$ | 去掉 $z>0$ 的无用上块，电机行程减半、分辨率提升 1.67 倍 |

### 9.3 推荐作业区间（$\Gamma=45^\circ$）

| 项 | 数值 |
|---|---|
| $Z$ 范围 | $-313.2\sim-255.5\ \mathrm{mm}$ |
| $Z$ 行程 | $57.7\ \mathrm{mm}$ |
| 中心 $\rho=0$ 处行程 | $57.7\ \mathrm{mm}$ |
| $\rho=25$ 处行程 | $52.4\ \mathrm{mm}$ |
| $\rho=50$ 处行程 | $38.0\ \mathrm{mm}$ |
| 最大半径 | $72.7\ \mathrm{mm}$ |

对打顶作业的含义：横向对位余量约 $\pm50\ \mathrm{mm}$，下探行程约 $38\sim57\ \mathrm{mm}$，可按刀盘直径与打顶长度 H 反查是否够用。

---

## 10. 附录 B　约束版算法代码

```python
"""
Delta 机械臂：运动学 + 硬件约束判定（自包含，可直接运行）。

约束清单
  C1 主动臂行程 / 电机转角
  C2 臂端球铰锥角（球窝轴随主动臂转动）
  C3 平台端球铰锥角（球窝轴固定在动平台）
  C4 6 根从动臂两两干涉
  C5 奇异裕度

长度 mm，角度 rad。动平台姿态由平行四边形锁死，A_i = P + r * u_i。
"""

import numpy as np

# ---------------- 几何参数 ----------------
R = 139.0
r = 39.0       # 平台端球铰安装点半径
L = 140.0
l = 200.0
L1 = 28.0      # SQZ6-RS 球心相对安装点的偏移

# ---------------- 约束参数 ----------------
THETA_MIN = np.deg2rad(-90.0)     # C1 主动臂下限
THETA_MAX = np.deg2rad(60.0)      # C1 主动臂上限
MAX_CONE_ARM = np.deg2rad(45.0)   # C2 臂端球铰锥角（ARM_JOINT="ball" 时生效）
MAX_CONE_PLAT = np.deg2rad(15.0)  # C3 平台端 SQZ6-RS 半锥角

# 臂端关节类型："ball" = 球头铰链（锥角），"ujoint" = 十字万向节（双轴摆角）
ARM_JOINT = "ujoint"
UJ_ALPHA_MAX = np.deg2rad(160.0)  # 万向节面内摆角上限
UJ_BETA_MAX = np.deg2rad(90.0)    # 万向节面外摆角上限（90° 即不限制）
ROD_DIAMETER = 15.0               # C4 杆径
FORK_WIDTH = 30.0                 # C4 平行四边形叉口间距
SING_MARGIN = 1.0                 # C5 奇异裕度（1.0=不裁剪，建议 0.90）

# 平台端球窝安装角：安装面与动平台平面成 135°，球窝轴垂直安装面 -> 外倾 45°
SOCKET_TILT = np.deg2rad(45.0)

PHI = np.array([0.0, 2.0 * np.pi / 3.0, 4.0 * np.pi / 3.0])
U_DIR = np.stack([np.cos(PHI), np.sin(PHI), np.zeros(3)], axis=-1)
T_DIR = np.stack([-np.sin(PHI), np.cos(PHI), np.zeros(3)], axis=-1)
Z_AXIS = np.array([0.0, 0.0, 1.0])

# 平台端球窝轴（固定在动平台）
BALL_SOCKET = np.sin(SOCKET_TILT) * U_DIR + np.cos(SOCKET_TILT) * Z_AXIS
U_OFFSET = r * U_DIR + L1 * BALL_SOCKET   # A_i = P + U_OFFSET_i

# 臂端球窝安装角：按「主动臂下垂」位姿的从动臂方向居中（加入 L1 后约 23.6°）
MOUNT_ANGLE = np.arcsin(
    np.clip((R - r - L1 * np.sin(SOCKET_TILT)) / l, -1.0, 1.0)
)

def wrap(x):
    """角度折叠到 (-pi, pi]"""
    return np.remainder(x + np.pi, 2.0 * np.pi) - np.pi

# ---------------- 运动学（复用无约束版结论）----------------
def elbow_points(thetas):
    """式 (0.1)：肘点 B_i 与等效球心 E_i，形状 (..., 3 腿, 3 分量)"""
    c, s = np.cos(thetas), np.sin(thetas)
    B = (R + L * c)[..., None] * U_DIR + (L * s)[..., None] * Z_AXIS
    E = B - U_OFFSET
    return B, E

def forward_kinematics(thetas, lower=True):
    """三球求交，返回 P (...,3), B (...,3,3), ok (...,)"""
    thetas = np.asarray(thetas, dtype=float)
    B, E = elbow_points(thetas)
    E1, E2, E3 = E[..., 0, :], E[..., 1, :], E[..., 2, :]
    v1, v2 = E2 - E1, E3 - E1

    n_raw = np.cross(v1, v2)
    nn = np.linalg.norm(n_raw, axis=-1)
    ok = nn > 1e-9
    n = n_raw / np.where(ok, nn, 1.0)[..., None]

    a11 = np.sum(v1 * v1, axis=-1)
    a12 = np.sum(v1 * v2, axis=-1)
    a22 = np.sum(v2 * v2, axis=-1)
    beta1 = 0.5 * (np.sum(E2 * E2, -1) - np.sum(E1 * E1, -1))
    beta2 = 0.5 * (np.sum(E3 * E3, -1) - np.sum(E1 * E1, -1))
    b1 = beta1 - np.sum(E1 * v1, axis=-1)
    b2 = beta2 - np.sum(E1 * v2, axis=-1)

    det = a11 * a22 - a12 * a12
    ok = ok & (np.abs(det) > 1e-9)
    ds = np.where(np.abs(det) > 1e-9, det, 1.0)
    alpha = (b1 * a22 - b2 * a12) / ds
    beta = (a11 * b2 - a12 * b1) / ds

    W2 = alpha * alpha * a11 + beta * beta * a22 + 2.0 * alpha * beta * a12
    g2 = l * l - W2
    ok = ok & (g2 >= 0.0)
    g = np.sqrt(np.maximum(g2, 0.0))

    mid = E1 + alpha[..., None] * v1 + beta[..., None] * v2
    p_lo = mid - g[..., None] * n
    p_hi = mid + g[..., None] * n
    if lower:
        P = np.where((p_lo[..., 2] <= p_hi[..., 2])[..., None], p_lo, p_hi)
    else:
        P = np.where((p_lo[..., 2] <= p_hi[..., 2])[..., None], p_hi, p_lo)
    return P, B, ok

def leg_terms(P):
    """式 (0.4)+式 (0.3) 的中间量：a', b, z_e, rho, d, psi"""
    P = np.asarray(P, dtype=float)
    a = np.einsum("...k,ik->...i", P, U_DIR)
    b = np.einsum("...k,ik->...i", P, T_DIR)
    z = P[..., 2][..., None] + L1 * np.cos(SOCKET_TILT)
    ap = a + r + L1 * np.sin(SOCKET_TILT) - R
    rho = np.hypot(ap, z)
    d = (ap * ap + b * b + z * z + L * L - l * l) / (2.0 * L)
    psi = np.arctan2(z, ap)
    return ap, b, z, rho, d, psi

def inverse_kinematics(P, prev=None, branch="plus"):
    """逐腿圆-圆求交，返回 theta (...,3), ok (...,)"""
    ap, b, z, rho, d, psi = leg_terms(P)
    safe = rho > 1e-9
    ratio = np.where(safe, d / np.where(safe, rho, 1.0), np.inf)
    ok = np.all(safe, axis=-1) & np.all(np.abs(ratio) <= 1.0, axis=-1)

    delta = np.arccos(np.clip(ratio, -1.0, 1.0))
    th_p, th_m = psi + delta, psi - delta

    if prev is None:
        # 仅用于单点校验；实际控制必须传 prev，按连续性选支（D13）
        theta = th_p if branch == "plus" else th_m
    else:
        prev = np.asarray(prev, dtype=float)
        theta = np.where(
            np.abs(wrap(th_p - prev)) <= np.abs(wrap(th_m - prev)), th_p, th_m
        )
    return theta, ok

# ---------------- 约束判定 ----------------
def arm_socket(thetas):
    """式 (2.3)：臂端球窝轴，随主动臂绕切向轴转动"""
    ang = thetas - MOUNT_ANGLE
    return np.cos(ang)[..., None] * U_DIR + np.sin(ang)[..., None] * Z_AXIS

def seg_seg_dist(p1, q1, p2, q2, eps=1e-12):
    """式 (3.7)：批量线段-线段最短距离"""
    d1, d2 = q1 - p1, q2 - p2
    w = p1 - p2
    a = np.sum(d1 * d1, -1)
    e = np.sum(d2 * d2, -1)
    b = np.sum(d1 * d2, -1)
    c = np.sum(d1 * w, -1)
    f = np.sum(d2 * w, -1)

    denom = a * e - b * b
    has = denom > eps
    s = np.where(has, (b * f - c * e) / np.where(has, denom, 1.0), 0.0)
    s = np.clip(s, 0.0, 1.0)

    t = np.where(e > eps, (b * s + f) / np.where(e > eps, e, 1.0), 0.0)
    s_low = np.clip(-c / np.where(a > eps, a, 1.0), 0.0, 1.0)
    s_high = np.clip((b - c) / np.where(a > eps, a, 1.0), 0.0, 1.0)
    s = np.where(t < 0.0, s_low, s)
    s = np.where(t > 1.0, s_high, s)
    t = np.clip(t, 0.0, 1.0)

    return np.linalg.norm((p1 + s[..., None] * d1) - (p2 + t[..., None] * d2), axis=-1)

def local_components(vec):
    """式 (8.2)：把世界系方向向量分解到各腿的（径向, 切向, 竖直）"""
    vr = np.sum(vec * U_DIR, axis=-1)
    vt = np.sum(vec * T_DIR, axis=-1)
    vz = vec[..., 2]
    return vr, vt, vz

def arm_joint_mask(thetas, b_hat):
    """C2：臂端关节约束

    ARM_JOINT="ball"   -> 式 (3.3) 球铰锥角
    ARM_JOINT="ujoint" -> 式 (8.3)(8.4) 万向节双轴摆角
    """
    if ARM_JOINT == "ball":
        cos_arm = np.sum(b_hat * arm_socket(thetas), axis=-1)
        return np.all(cos_arm >= np.cos(MAX_CONE_ARM), axis=-1)

    br, bt, bz = local_components(b_hat)
    alpha = np.abs(wrap(np.arctan2(bz, br) - thetas))    # 面内摆角
    beta = np.abs(np.arctan2(bt, np.hypot(br, bz)))      # 面外摆角
    return np.all(alpha <= UJ_ALPHA_MAX, axis=-1) & np.all(beta <= UJ_BETA_MAX, axis=-1)

def constraint_masks(thetas, P, B):
    """式 (3.1)(3.3)(3.4)(3.5)(3.8)：返回各约束掩码"""
    C = R * U_DIR                                   # 静平台铰点 (3,3)
    A = P[..., None, :] + U_OFFSET                 # 动平台球心 (...,3,3)
    v_leg = A - B
    b_hat = v_leg / l

    # C1 主动臂行程
    m_joint = np.all((thetas >= THETA_MIN) & (thetas <= THETA_MAX), axis=-1)

    # C2 臂端关节（球铰锥角 或 万向节双轴摆角）
    m_arm = arm_joint_mask(thetas, b_hat)

    # C3 平台端球铰锥角（参考方向取 A→B）
    cos_plat = np.sum(-b_hat * BALL_SOCKET, axis=-1)
    m_plat = np.all(cos_plat >= np.cos(MAX_CONE_PLAT), axis=-1)

    # C5 奇异裕度
    ap, bb, zz, rho, d, _ = leg_terms(P)
    safe = rho > 1e-9
    ratio = np.where(safe, np.abs(d) / np.where(safe, rho, 1.0), np.inf)
    m_sing = np.all(ratio <= SING_MARGIN, axis=-1)

    # C4 干涉：6 根杆两两比较
    off = FORK_WIDTH * T_DIR
    starts = np.concatenate([B, B + off], axis=-2)
    ends = np.concatenate([A, A + off], axis=-2)
    m_rod = np.ones(P.shape[:-1], dtype=bool)
    for i in range(6):
        for j in range(i + 1, 6):
            m_rod &= (
                seg_seg_dist(
                    starts[..., i, :], ends[..., i, :],
                    starts[..., j, :], ends[..., j, :],
                )
                > ROD_DIAMETER
            )

    return {
        "C1_行程": m_joint,
        "C2_臂端关节": m_arm,
        "C3_平台端球铰": m_plat,
        "C4_干涉": m_rod,
        "C5_奇异": m_sing,
    }

def pose_ok(P, prev=None):
    """约束版逆解：给定 P，返回 theta、是否可作业、各约束明细"""
    P = np.atleast_2d(np.asarray(P, dtype=float))
    theta, ok_ik = inverse_kinematics(P, prev)
    B, _ = elbow_points(theta)
    masks = constraint_masks(theta, P, B)
    ok = ok_ik
    for m in masks.values():
        ok = ok & m
    return theta, ok, masks

# ---------------- 工作空间 ----------------
def iter_joint_grid(n, chunk=200_000):
    g = np.linspace(THETA_MIN, THETA_MAX, n)
    total = n ** 3
    for s in range(0, total, chunk):
        idx = np.arange(s, min(s + chunk, total))
        k = idx % n
        j = (idx // n) % n
        i = idx // (n * n)
        yield np.stack([g[i], g[j], g[k]], axis=-1)

def workspace(n=101, chunk=200_000):
    """关节空间正扫（扫描区间即 C1 区间），返回点云与各约束通过计数"""
    counts = {k: 0 for k in
              ["FK有解", "C1_行程", "C2_臂端关节", "C3_平台端球铰", "C4_干涉", "C5_奇异"]}
    total = n ** 3
    pts = []
    for th in iter_joint_grid(n, chunk):
        P, B, ok = forward_kinematics(th)
        masks = constraint_masks(th, P, B)
        counts["FK有解"] += int(ok.sum())
        for k, m in masks.items():
            counts[k] += int(m.sum())
        valid = ok
        for m in masks.values():
            valid = valid & m
        if np.any(valid):
            pts.append(P[valid])
    P_all = np.concatenate(pts) if pts else np.empty((0, 3))
    return P_all, counts, total

if __name__ == "__main__":
    print("臂端关节类型 = %s" % ARM_JOINT)
    P, counts, total = workspace(n=81)
    print("采样 n^3 = %d" % total)
    for k, v in counts.items():
        print("  %-8s %9d  (%.2f%%)" % (k, v, 100.0 * v / total))
    print("  %-8s %9d" % ("全部满足", len(P)))
    if len(P):
        z = P[:, 2]
        rad = np.hypot(P[:, 0], P[:, 1])
        print("Z 范围 [%.1f, %.1f]，行程 %.1f mm，最大半径 %.1f mm"
              % (z.min(), z.max(), z.max() - z.min(), rad.max()))

    th, ok, masks = pose_ok([0.0, 0.0, -280.0])
    print("P=(0,0,-280) 可作业=%s  theta=%s" % (ok[0], np.round(np.degrees(th[0]), 2)))
    print("  明细：", {k: bool(v[0]) for k, v in masks.items()})
```
