SunXingzhi/topping_machine/resources/model/三角机器人/三角机器人.SLDASM

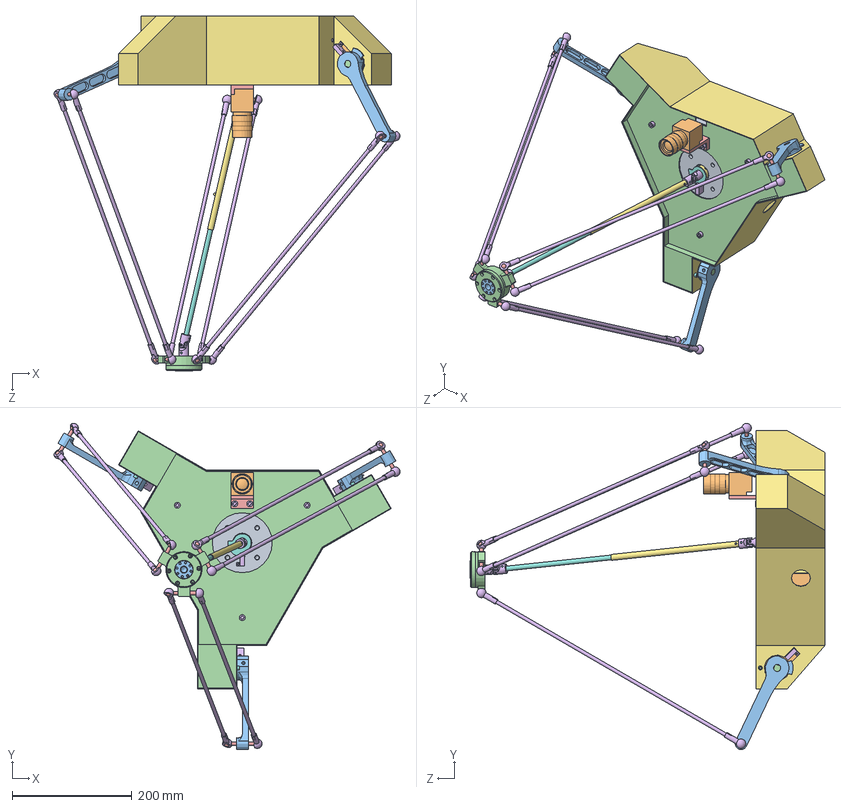
[picture p1: CAD file, 2026-10-21]
resources/model/三角机器人/三角机器人.SLDASM
577.1 x 544.4 x 591.8 mm
零件1
零件2 x 3
零件3 x 3
零件4
零件5 x 12
零件6 x 6
dianji x 3
零件8 x 3
轴晨 x 3
轴承盖 x 3
零件9 x 3
轴 x 3
wangxiang2 x 2
wangxiang1 x 4
kunben10
kun2
pidai2 x 3
pidai1SLDPRT x 3
J4
J4gai
dianjijia
chuanganqi x 4
LIANZHOUQI
z_ganyingpian
pidailu_25_60 x 3
ZHOUCHEN_8 x 6
ZHOU8 x 3
零件7 x 3
dianji2
zhougai x 3
huading
xiaoding x 4
xiao x 2
相机
xiebozhouchen30_42 x 2
keti3
xiangjijia
M6 x 5
keti
M4 x 3
