SunXingzhi/topping_machine/resources/model/三角机器人/轴晨.SLDPRT

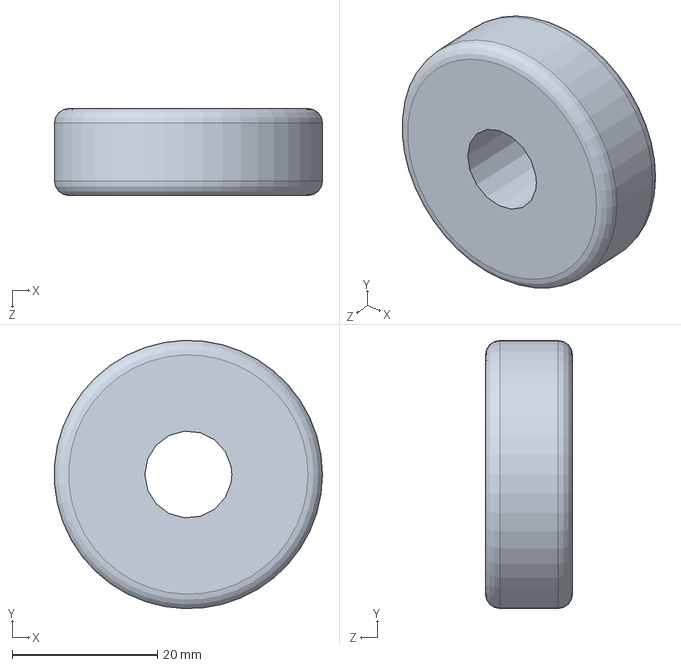
[picture p2: CAD file, 2026-10-21]
resources/model/三角机器人/轴晨.SLDPRT
37.0 x 37.0 x 12.0 mm
