SunXingzhi/topping_machine/resources/model/三角机器人/零件6.SLDPRT

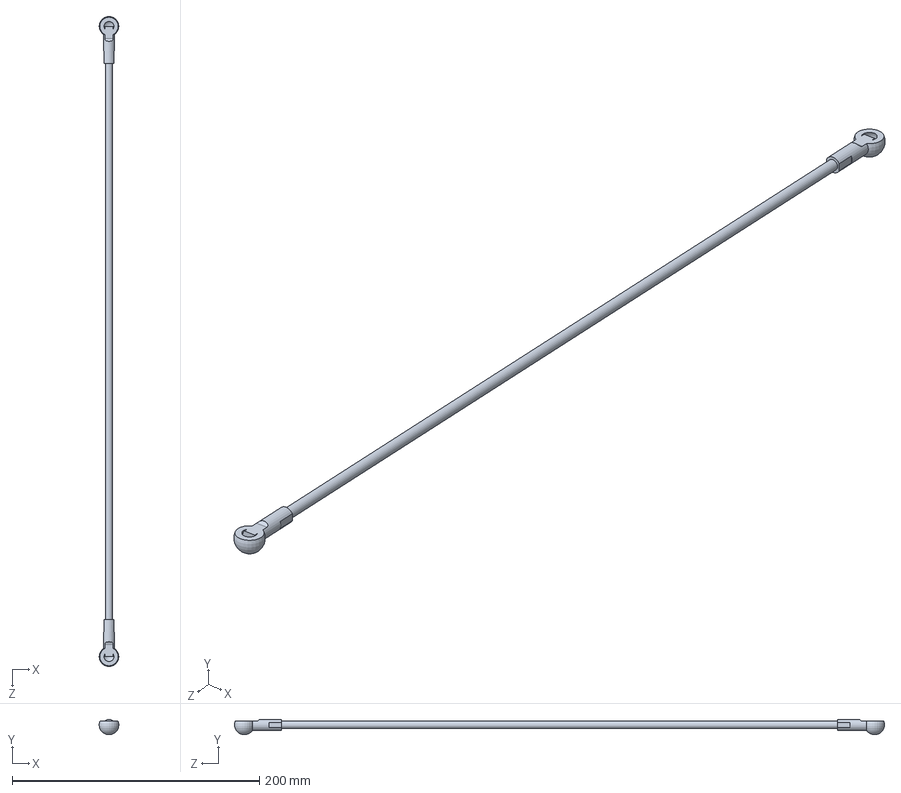
[picture p3: CAD file, 2026-10-21]
resources/model/三角机器人/零件6.SLDPRT
15.9 x 12.5 x 525.9 mm
