SunXingzhi/topping_machine/resources/model/三角机器人/ZHOUCHEN_8.SLDPRT

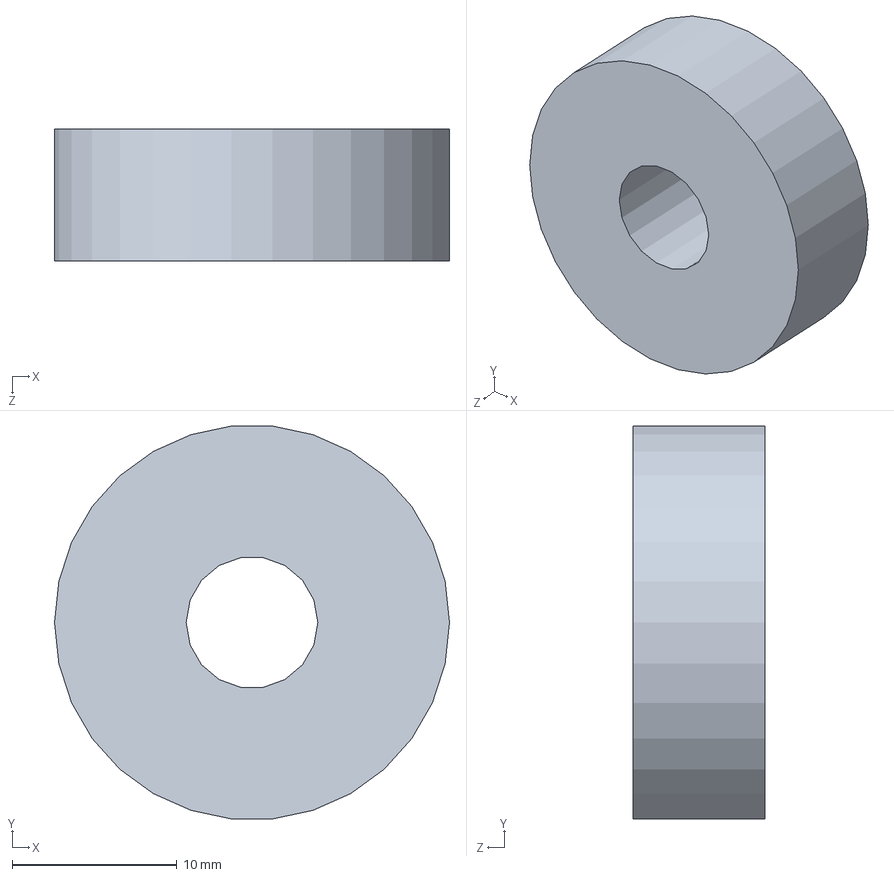
[picture p4: CAD file, 2026-10-21]
resources/model/三角机器人/ZHOUCHEN_8.SLDPRT
24.0 x 23.9 x 8.00 mm
