SunXingzhi/topping_machine/resources/model/三角机器人/pidai1SLDPRT.SLDPRT

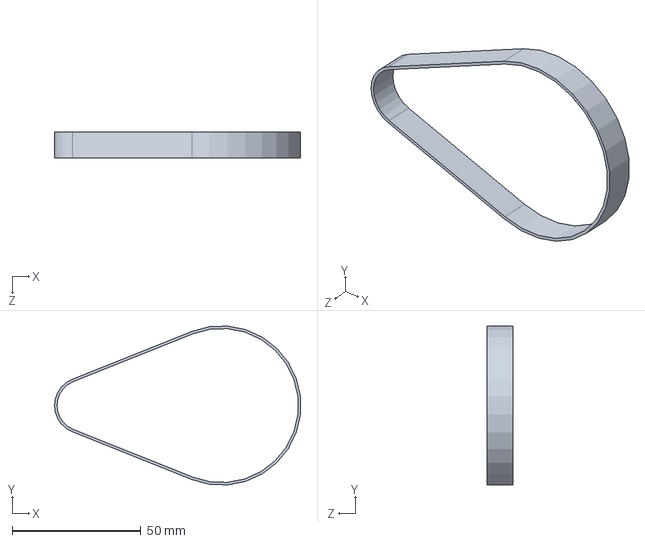
[picture p5: CAD file, 2026-10-21]
resources/model/三角机器人/pidai1SLDPRT.SLDPRT
95.7 x 61.8 x 10.0 mm
