SunXingzhi/topping_machine/resources/model/三角机器人/dianji2.SLDPRT

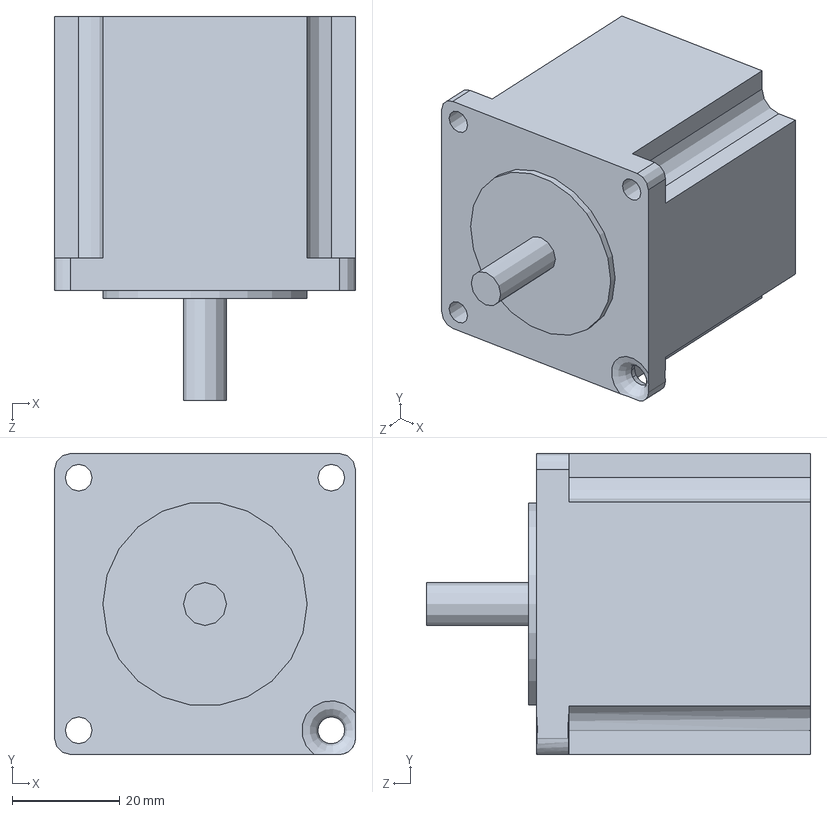
[picture p6: CAD file, 2026-10-21]
resources/model/三角机器人/dianji2.SLDPRT
56.0 x 56.0 x 71.5 mm
