SunXingzhi/topping_machine/resources/model/三角机器人/零件8.SLDPRT

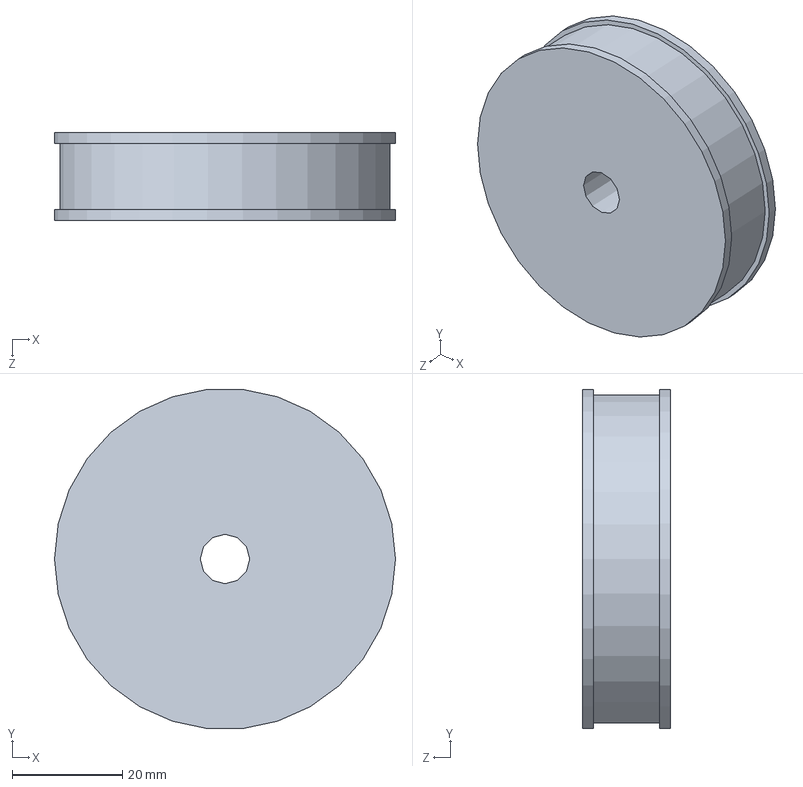
[picture p7: CAD file, 2026-10-21]
resources/model/三角机器人/零件8.SLDPRT
62.0 x 61.7 x 16.0 mm
