SunXingzhi/topping_machine/resources/model/三角机器人/xiangjijia.SLDPRT

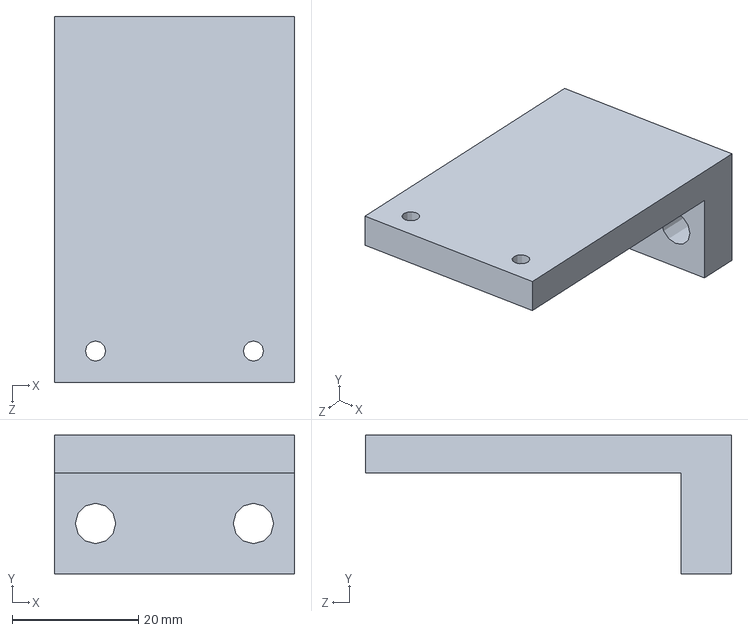
[picture p8: CAD file, 2026-10-21]
resources/model/三角机器人/xiangjijia.SLDPRT
38.0 x 22.0 x 58.0 mm
