SunXingzhi/topping_machine/resources/model/三角机器人/wangxiang1.SLDPRT

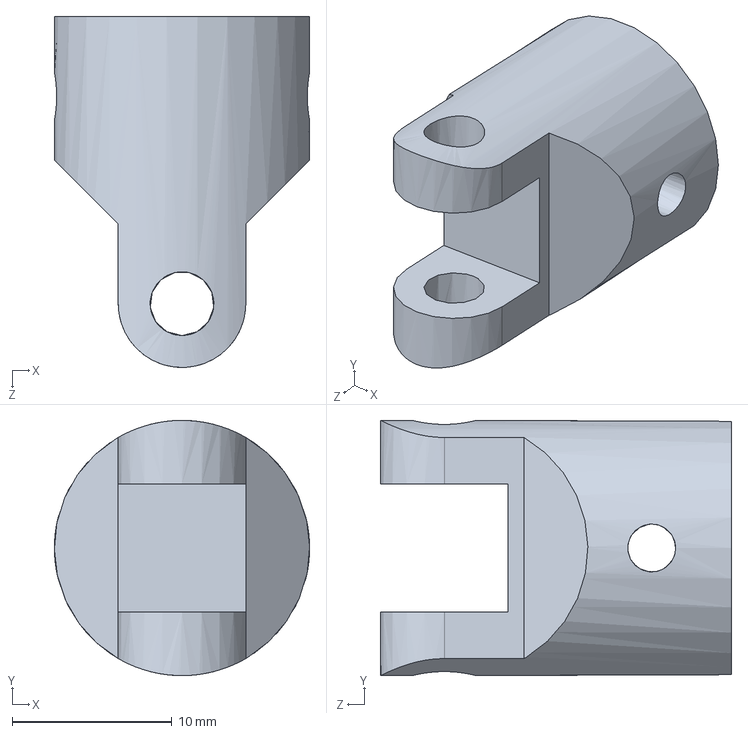
[picture p9: CAD file, 2026-10-21]
resources/model/三角机器人/wangxiang1.SLDPRT
16.0 x 16.0 x 22.0 mm
