SunXingzhi/topping_machine/resources/model/三角机器人/chuanganqi.SLDPRT

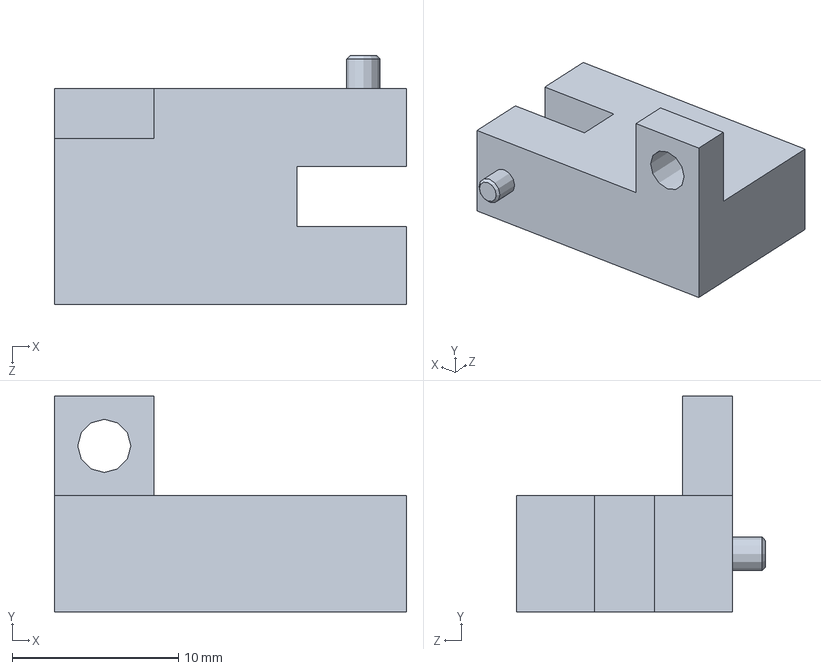
[picture p10: CAD file, 2026-10-21]
resources/model/三角机器人/chuanganqi.SLDPRT
21.2 x 13.0 x 15.0 mm
