SunXingzhi/topping_machine/resources/model/三角机器人/零件3.SLDPRT

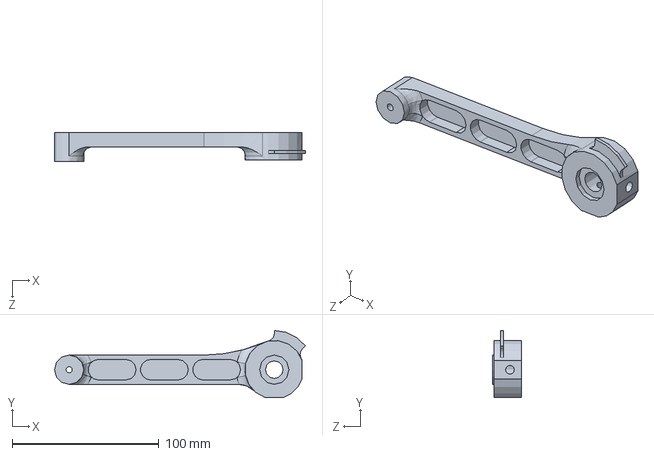
[picture p11: CAD file, 2026-10-21]
resources/model/三角机器人/零件3.SLDPRT
171.3 x 45.8 x 20.0 mm
