SunXingzhi/topping_machine/resources/model/三角机器人/pidailu_25_60.SLDPRT

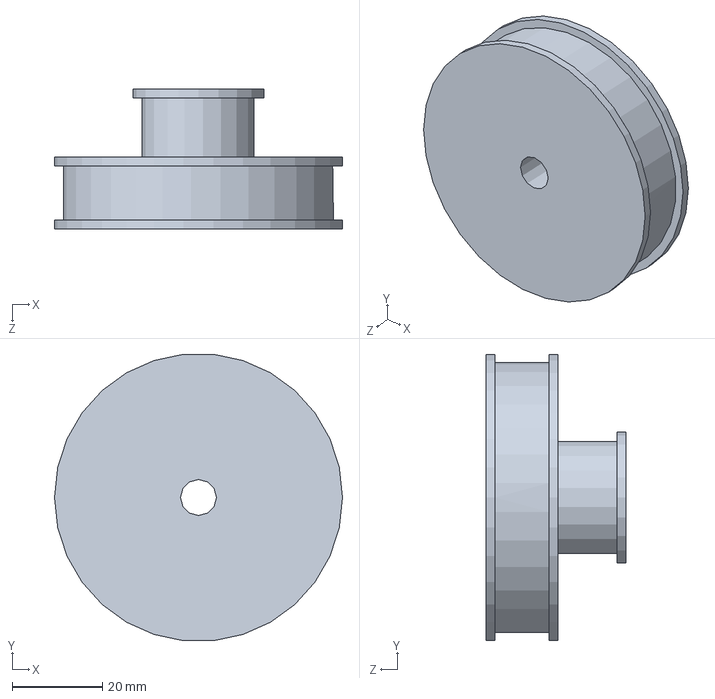
[picture p12: CAD file, 2026-10-21]
resources/model/三角机器人/pidailu_25_60.SLDPRT
64.0 x 63.6 x 31.0 mm
