SunXingzhi/topping_machine/resources/model/三角机器人/gangpian.SLDPRT

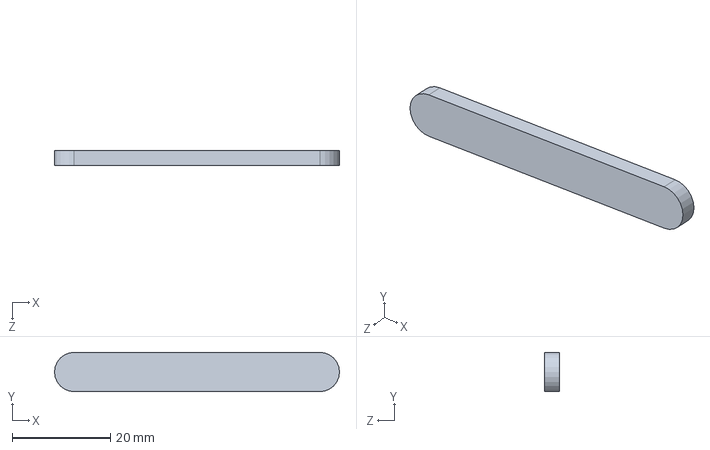
[picture p13: CAD file, 2026-10-21]
resources/model/三角机器人/gangpian.SLDPRT
58.0 x 8.00 x 3.00 mm
