SunXingzhi/topping_machine/resources/model/三角机器人/kun2.SLDPRT

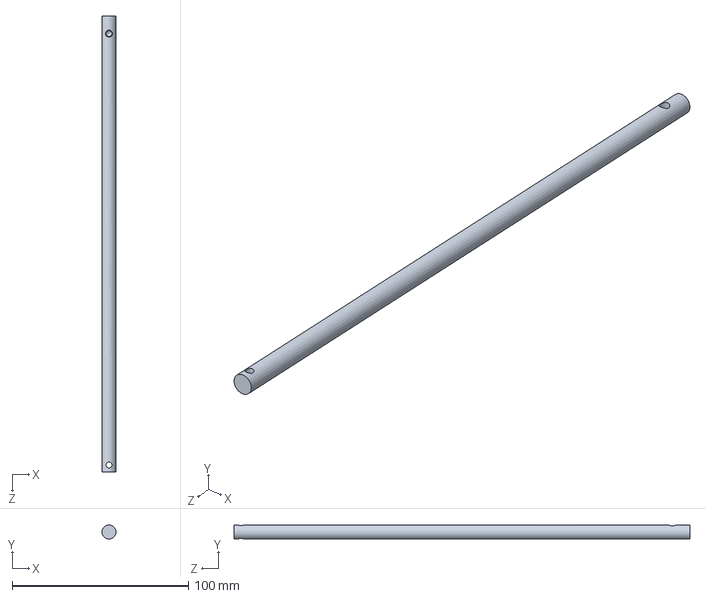
[picture p14: CAD file, 2026-10-21]
resources/model/三角机器人/kun2.SLDPRT
8.00 x 8.00 x 259.0 mm
