SunXingzhi/topping_machine/resources/model/三角机器人/keti3.SLDPRT

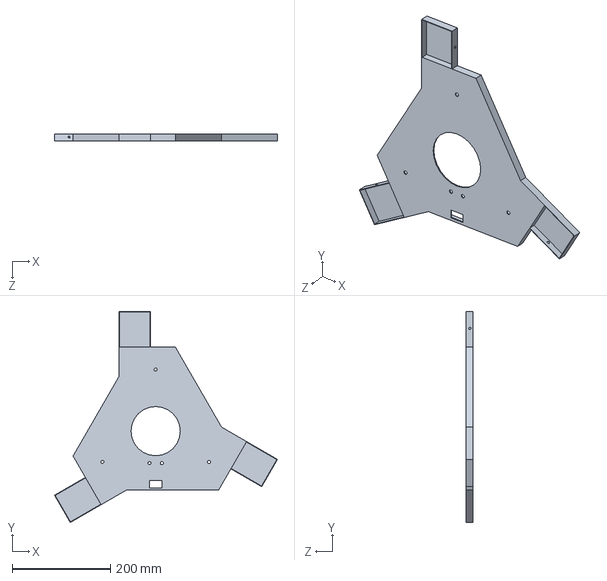
[picture p15: CAD file, 2026-10-21]
resources/model/三角机器人/keti3.SLDPRT
452.9 x 428.6 x 14.0 mm
