SunXingzhi/topping_machine/resources/model/三角机器人/xiebozhouchen30_42.SLDPRT

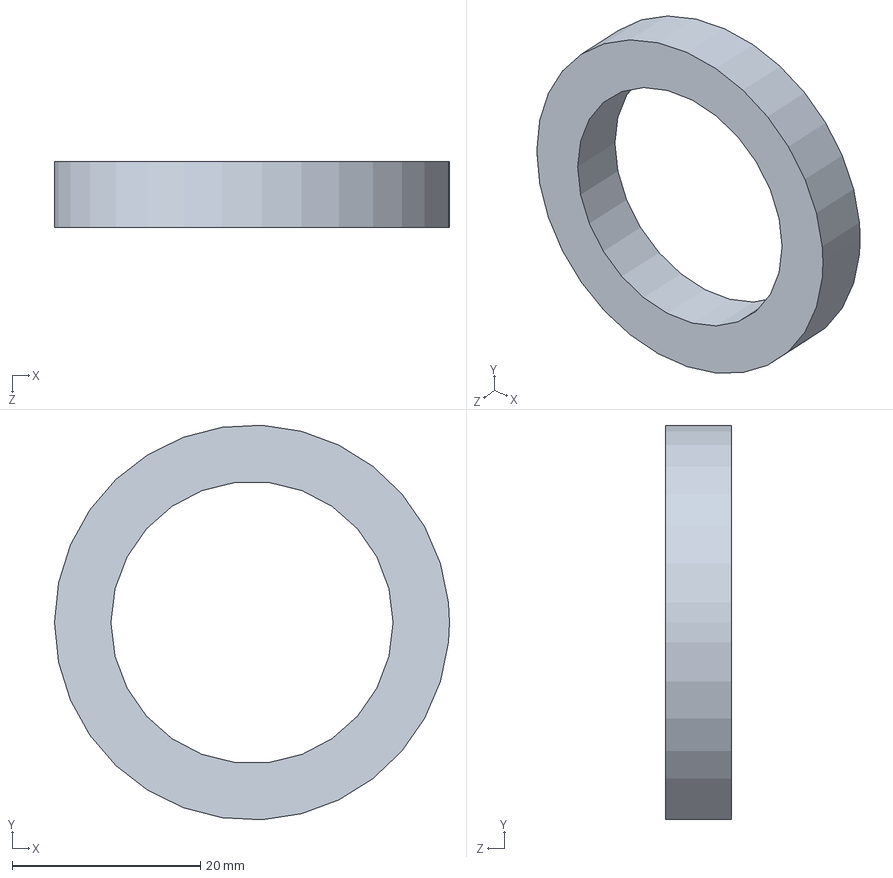
[picture p16: CAD file, 2026-10-21]
resources/model/三角机器人/xiebozhouchen30_42.SLDPRT
42.0 x 41.9 x 7.00 mm
