SunXingzhi/topping_machine/resources/model/三角机器人/xiao.SLDPRT

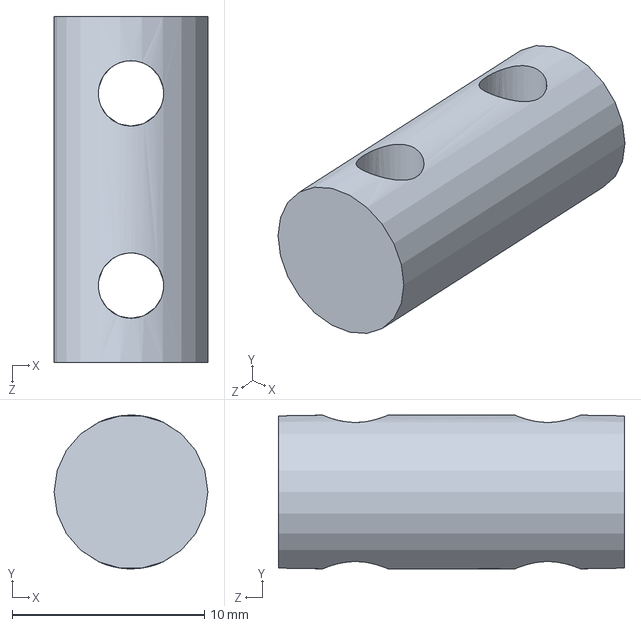
[picture p17: CAD file, 2026-10-21]
resources/model/三角机器人/xiao.SLDPRT
8.00 x 8.00 x 18.0 mm
