SunXingzhi/topping_machine/resources/model/三角机器人/J4gai.SLDPRT

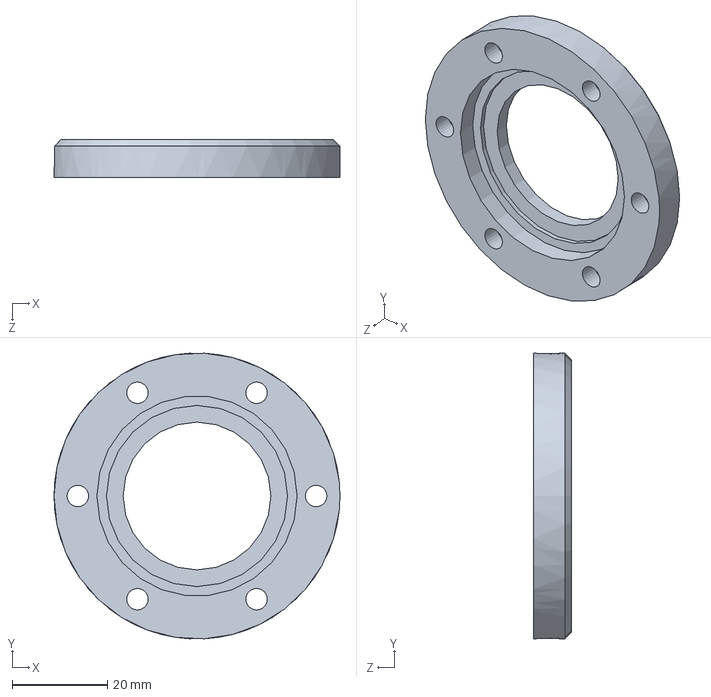
[picture p18: CAD file, 2026-10-21]
resources/model/三角机器人/J4gai.SLDPRT
60.0 x 59.9 x 8.00 mm
