SunXingzhi/topping_machine/resources/model/三角机器人/dianjijia.SLDPRT

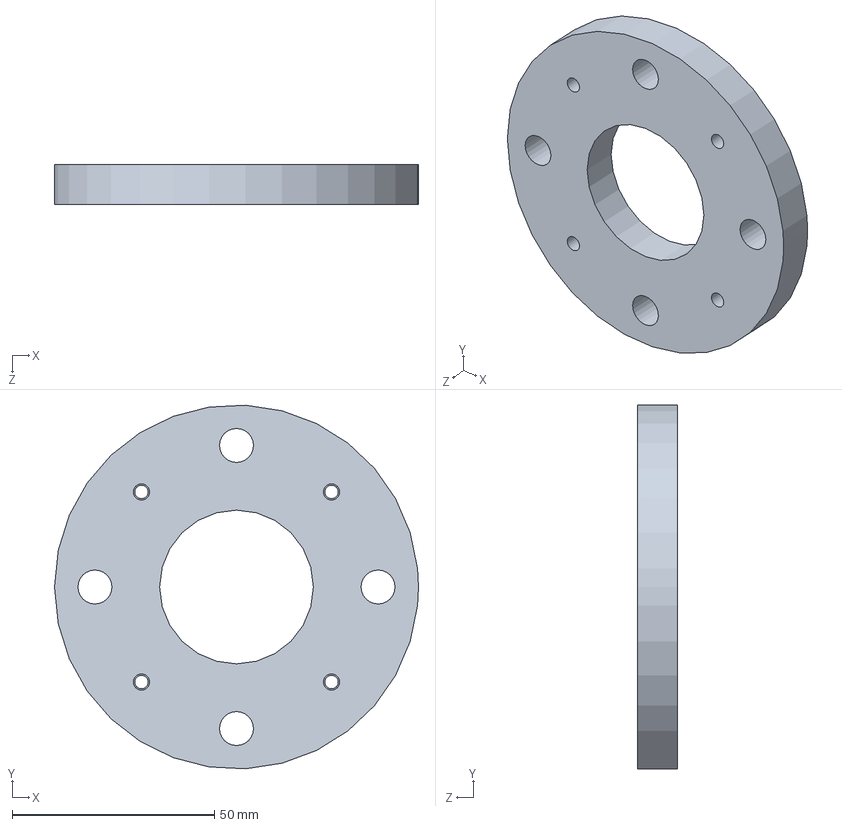
[picture p19: CAD file, 2026-10-21]
resources/model/三角机器人/dianjijia.SLDPRT
90.0 x 89.9 x 10.0 mm
