SunXingzhi/topping_machine/resources/model/三角机器人/huading.SLDPRT

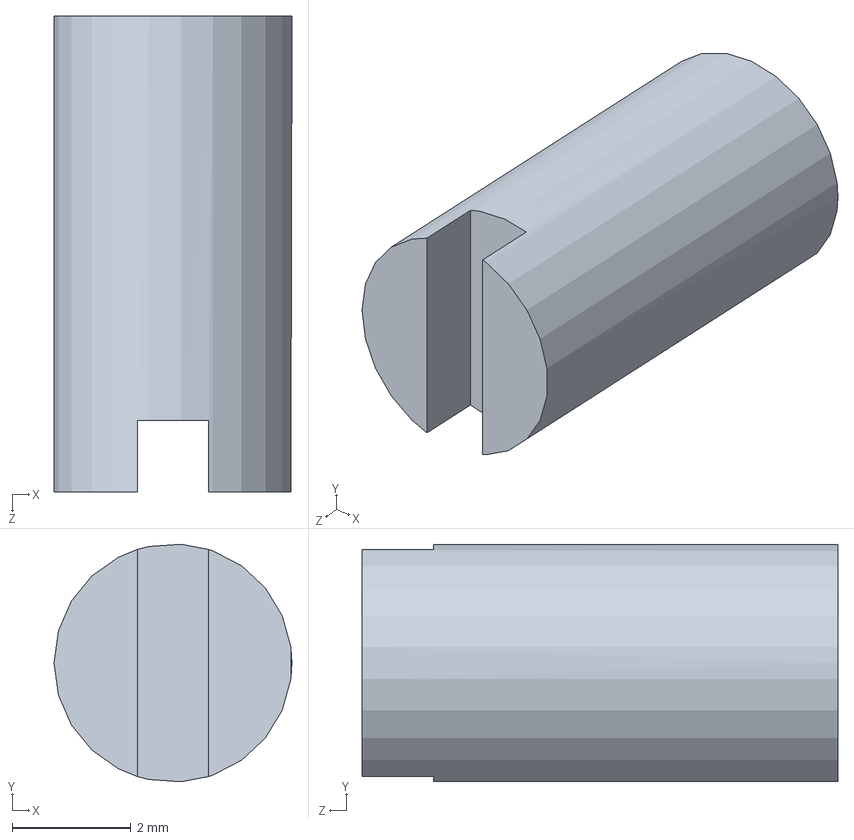
[picture p20: CAD file, 2026-10-21]
resources/model/三角机器人/huading.SLDPRT
4.00 x 3.99 x 8.00 mm
