SunXingzhi/topping_machine/resources/model/三角机器人/pidai2.SLDPRT

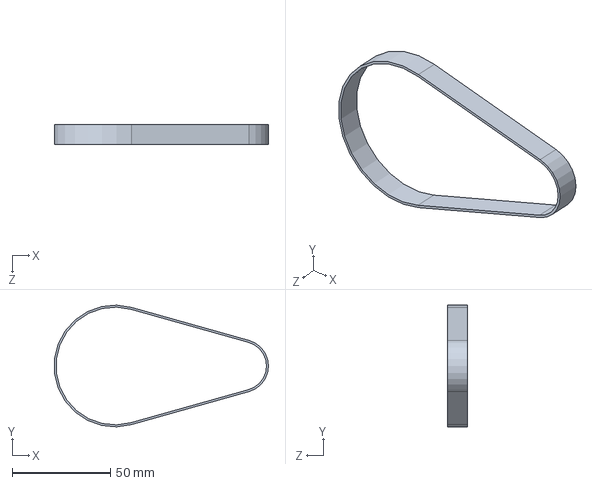
[picture p21: CAD file, 2026-10-21]
resources/model/三角机器人/pidai2.SLDPRT
109.0 x 62.0 x 10.0 mm
