SunXingzhi/topping_machine/resources/model/三角机器人/零件5.SLDPRT

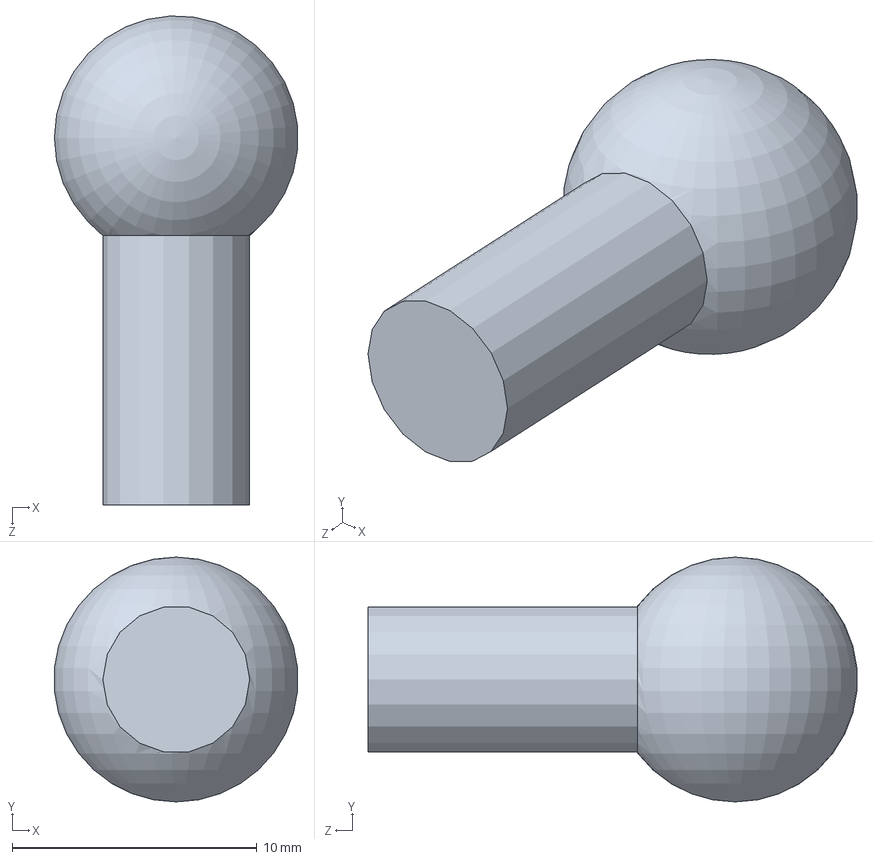
[picture p22: CAD file, 2026-10-21]
resources/model/三角机器人/零件5.SLDPRT
9.93 x 10.0 x 20.0 mm
