SunXingzhi/topping_machine/resources/model/三角机器人/相机.SLDPRT

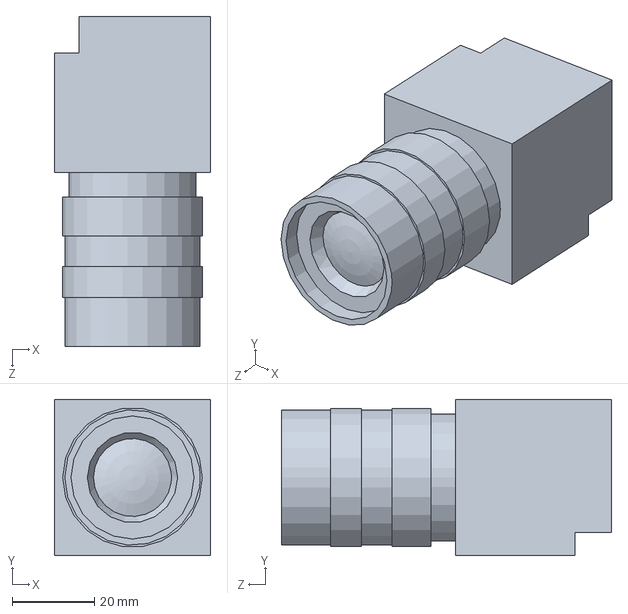
[picture p23: CAD file, 2026-10-21]
resources/model/三角机器人/相机.SLDPRT
38.0 x 38.0 x 80.5 mm
