SunXingzhi/topping_machine/resources/model/三角机器人/M6.SLDPRT

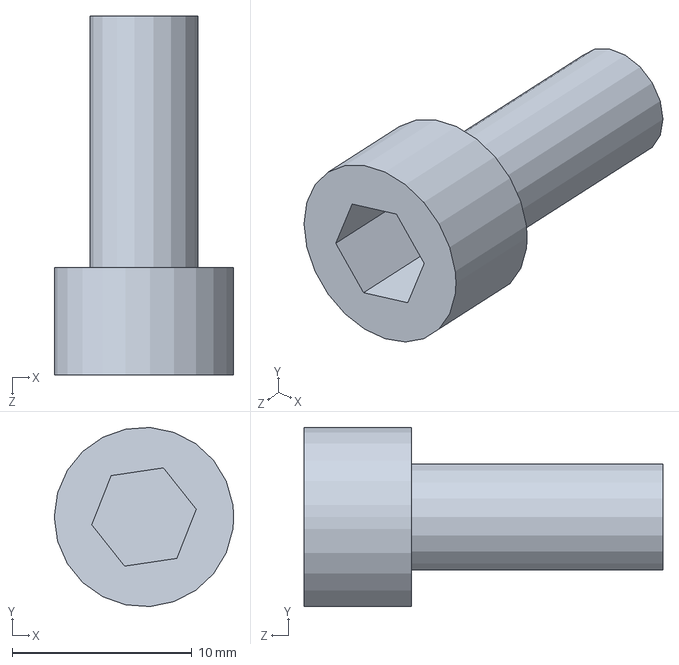
[picture p24: CAD file, 2026-10-21]
resources/model/三角机器人/M6.SLDPRT
10.0 x 9.98 x 20.0 mm
