SunXingzhi/topping_machine/resources/model/三角机器人/零件7.SLDPRT

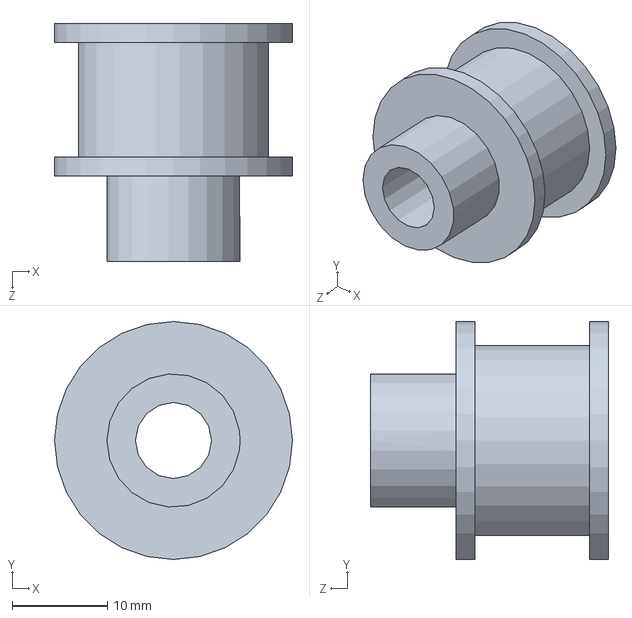
[picture p25: CAD file, 2026-10-21]
resources/model/三角机器人/零件7.SLDPRT
25.0 x 25.0 x 25.0 mm
