SunXingzhi/topping_machine/resources/model/三角机器人/LIANZHOUQI.SLDPRT

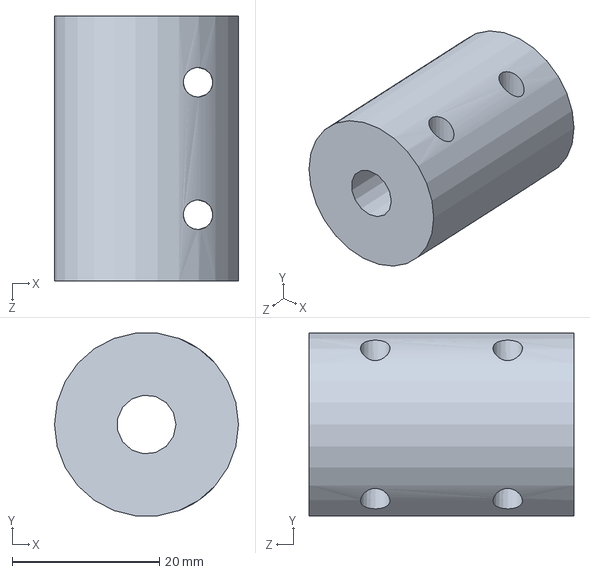
[picture p26: CAD file, 2026-10-21]
resources/model/三角机器人/LIANZHOUQI.SLDPRT
25.0 x 24.8 x 36.0 mm
