SunXingzhi/topping_machine/resources/model/三角机器人/J4.SLDPRT

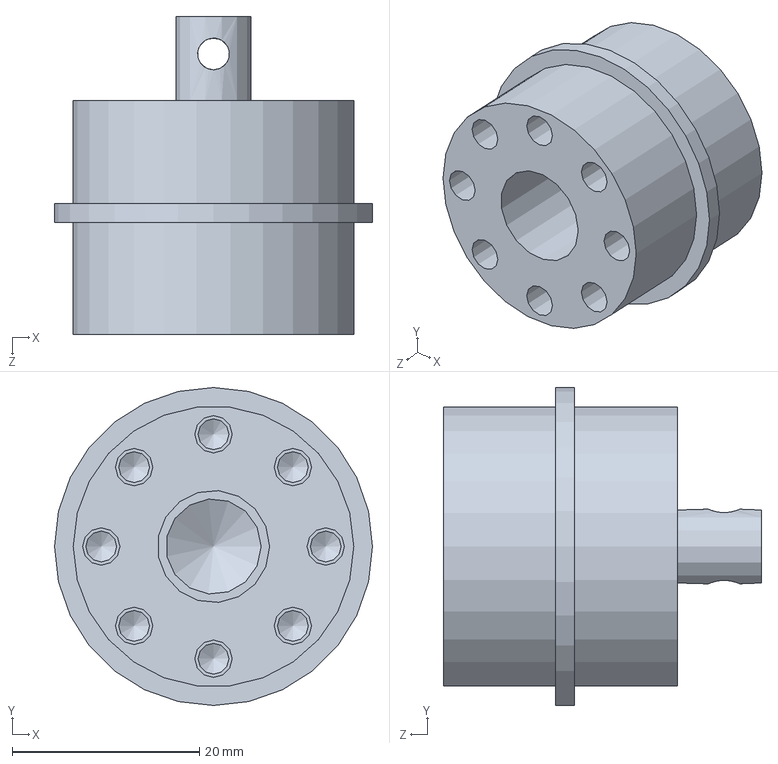
[picture p27: CAD file, 2026-10-21]
resources/model/三角机器人/J4.SLDPRT
34.0 x 34.0 x 34.0 mm
