SunXingzhi/topping_machine/resources/model/三角机器人/零件2.SLDPRT

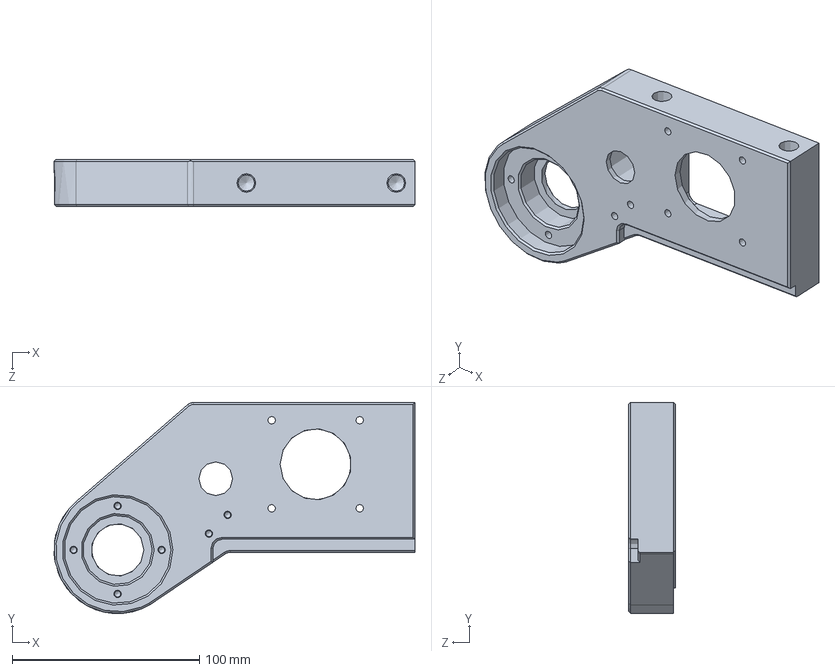
[picture p28: CAD file, 2026-10-21]
resources/model/三角机器人/零件2.SLDPRT
192.7 x 112.7 x 25.0 mm
