SunXingzhi/topping_machine/resources/model/三角机器人/零件9.SLDPRT

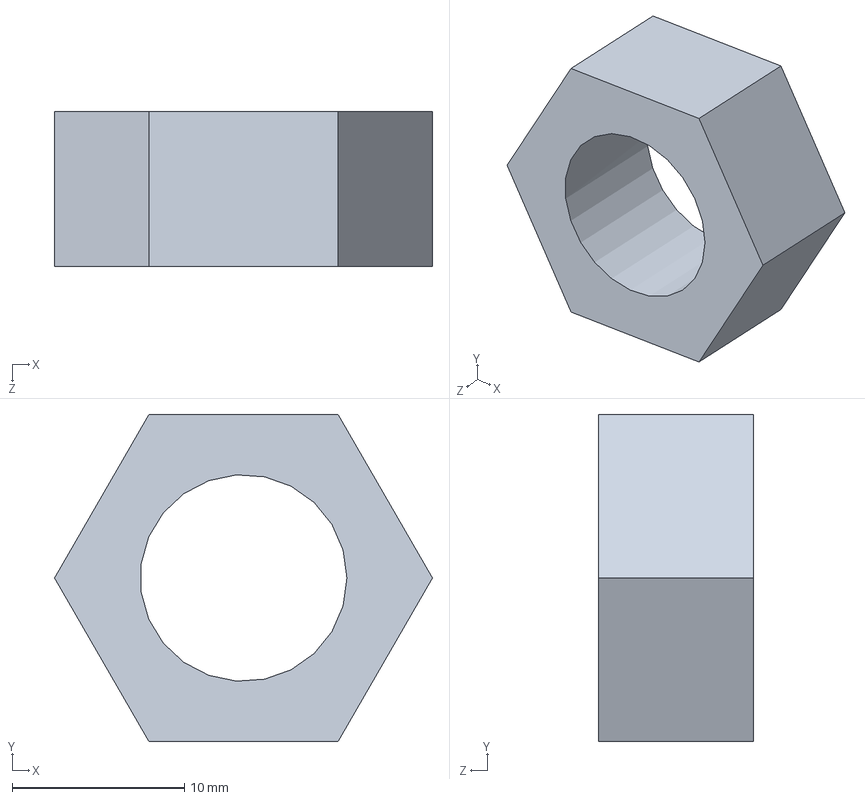
[picture p29: CAD file, 2026-10-21]
resources/model/三角机器人/零件9.SLDPRT
21.9 x 19.0 x 9.00 mm
