SunXingzhi/topping_machine/resources/model/三角机器人/wangxiang2.SLDPRT

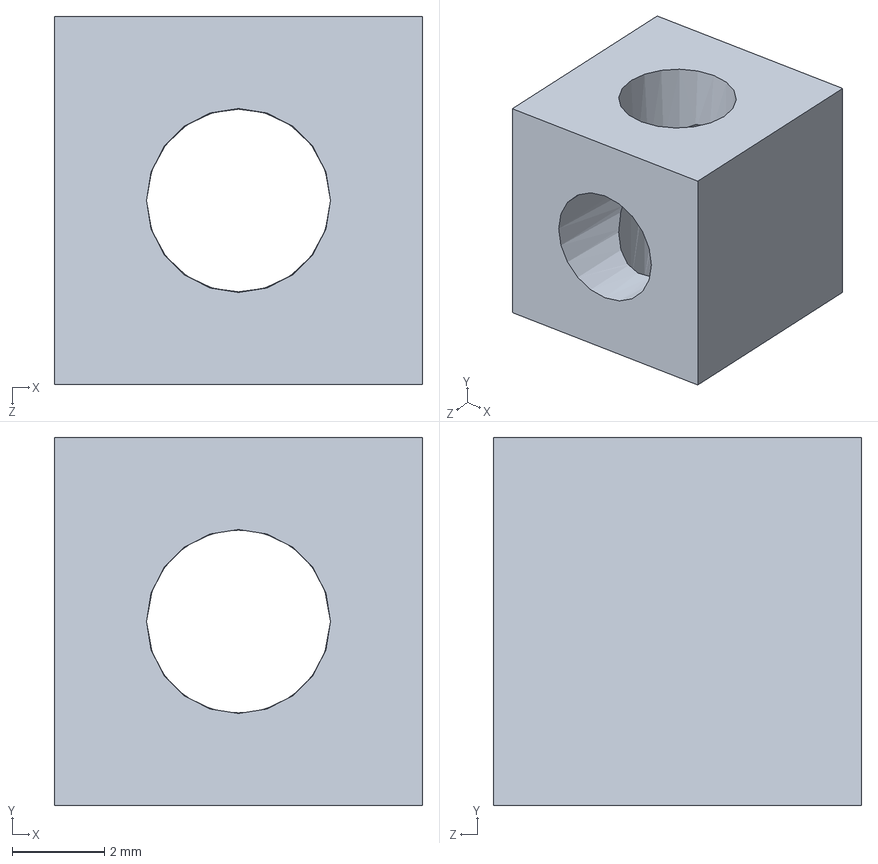
[picture p30: CAD file, 2026-10-21]
resources/model/三角机器人/wangxiang2.SLDPRT
8.00 x 8.00 x 8.00 mm
