SunXingzhi/topping_machine/resources/model/三角机器人/零件1.SLDPRT

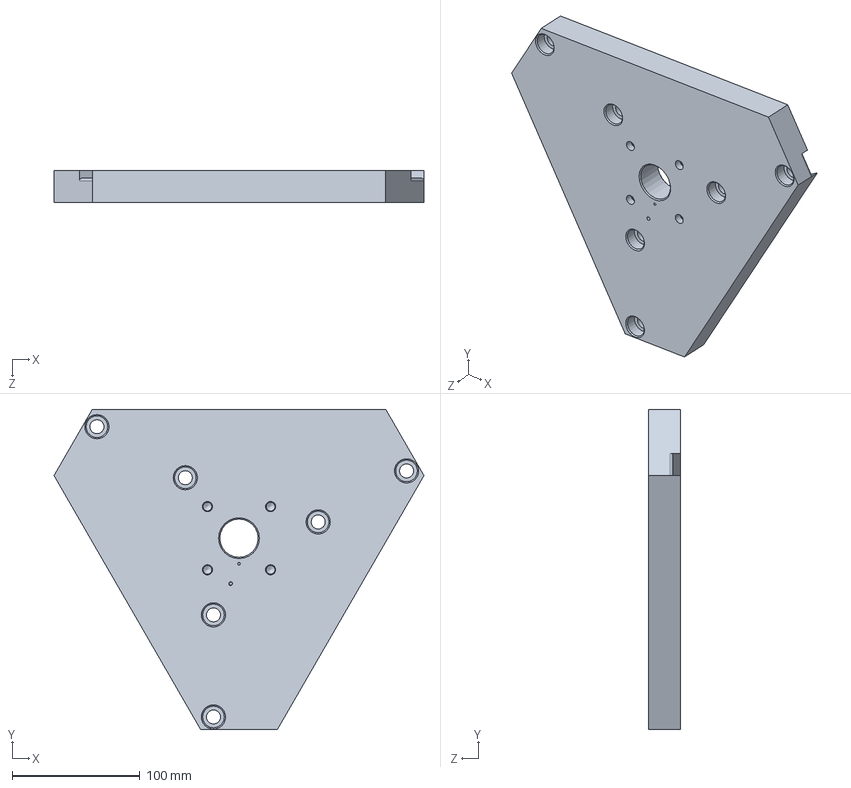
[picture p31: CAD file, 2026-10-21]
resources/model/三角机器人/零件1.SLDPRT
290.0 x 251.1 x 25.0 mm
