SunXingzhi/topping_machine/resources/model/三角机器人/M4.SLDPRT

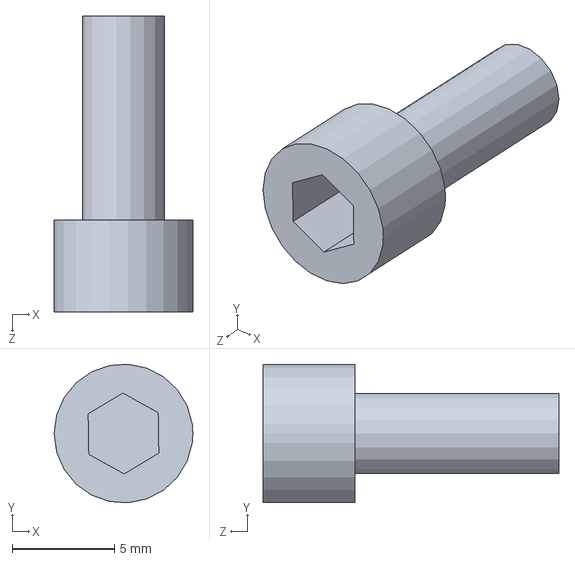
[picture p32: CAD file, 2026-10-21]
resources/model/三角机器人/M4.SLDPRT
6.80 x 6.78 x 14.5 mm
