SunXingzhi/topping_machine/resources/model/三角机器人/轴承盖.SLDPRT

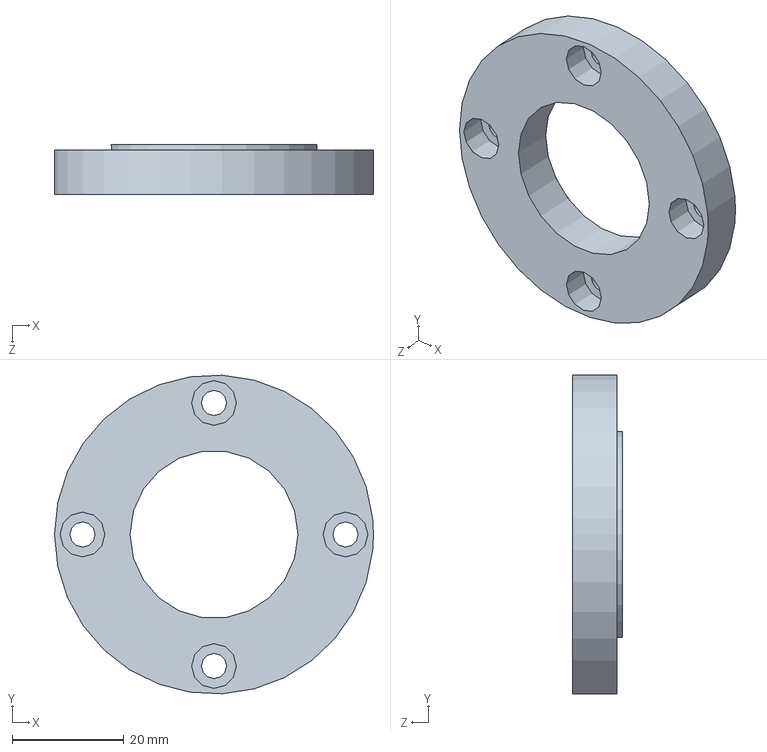
[picture p33: CAD file, 2026-10-21]
resources/model/三角机器人/轴承盖.SLDPRT
57.0 x 56.9 x 9.00 mm
