SunXingzhi/topping_machine/resources/model/三角机器人/零件4.SLDPRT

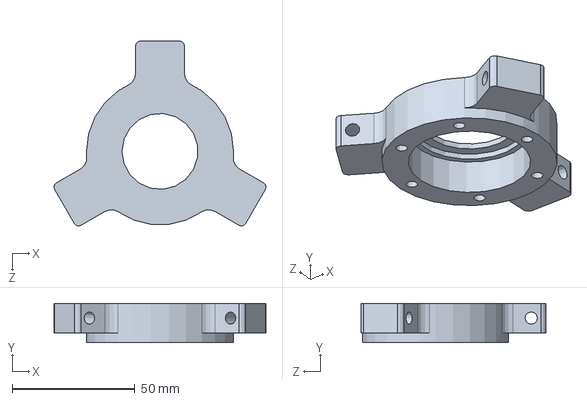
[picture p34: CAD file, 2026-10-21]
resources/model/三角机器人/零件4.SLDPRT
86.5 x 16.0 x 75.4 mm
