SunXingzhi/topping_machine/resources/model/三角机器人/轴.SLDPRT

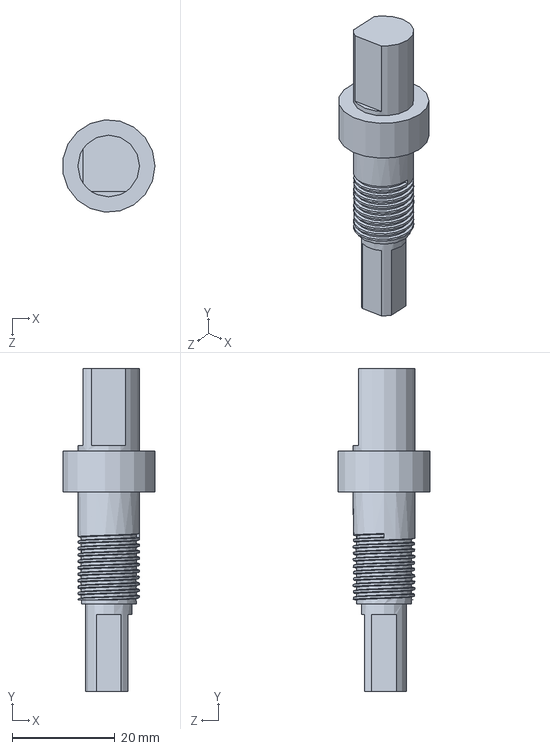
[picture p35: CAD file, 2026-10-21]
resources/model/三角机器人/轴.SLDPRT
17.9 x 62.8 x 17.9 mm
