SunXingzhi/topping_machine/resources/model/三角机器人/zhougai.SLDPRT

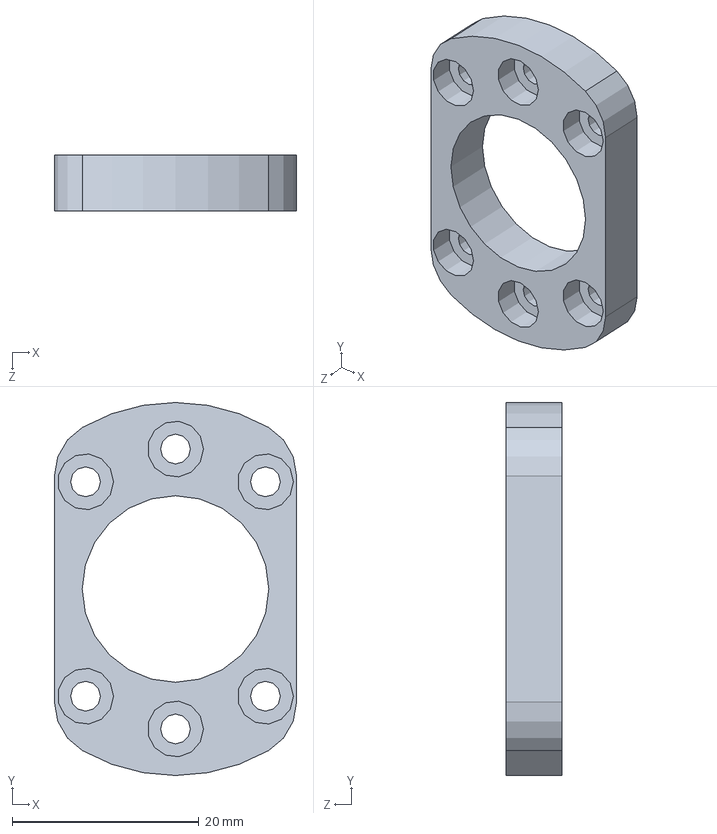
[picture p36: CAD file, 2026-10-21]
resources/model/三角机器人/zhougai.SLDPRT
26.0 x 40.0 x 6.00 mm
