SunXingzhi/topping_machine/resources/model/三角机器人/dianji.SLDPRT

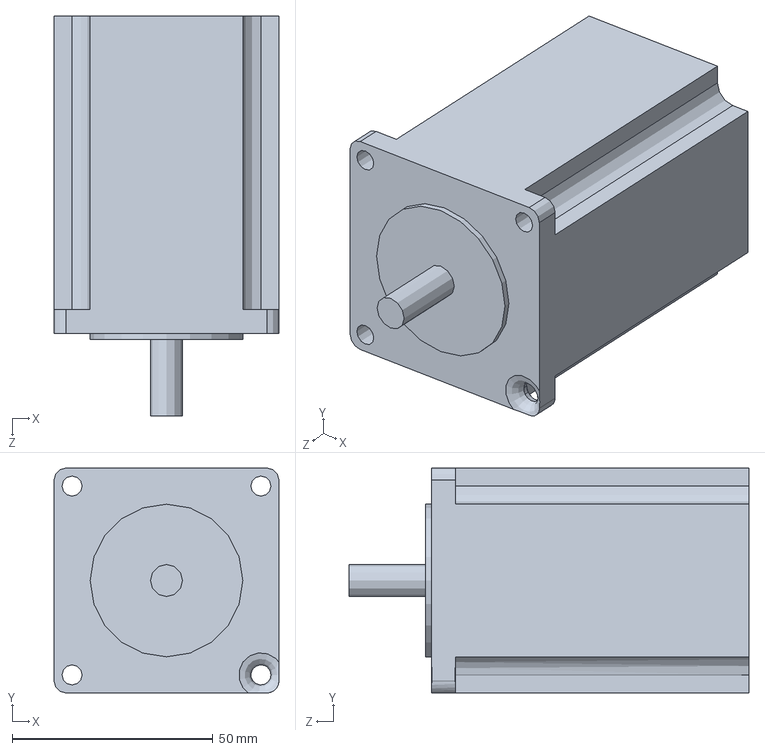
[picture p37: CAD file, 2026-10-21]
resources/model/三角机器人/dianji.SLDPRT
56.0 x 56.0 x 99.5 mm
