SunXingzhi/topping_machine/resources/model/三角机器人/keti.SLDPRT

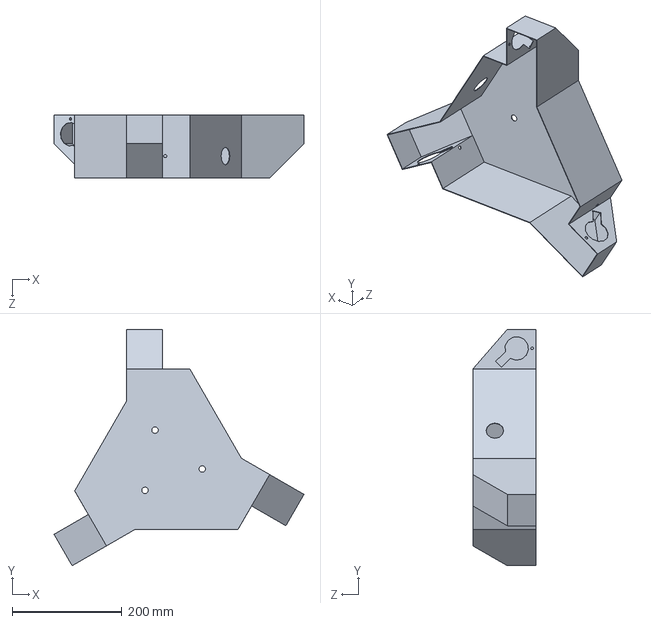
[picture p38: CAD file, 2026-10-21]
resources/model/三角机器人/keti.SLDPRT
455.1 x 430.5 x 115.0 mm
