SunXingzhi/topping_machine/resources/model/三角机器人/z_ganyingpian.SLDPRT

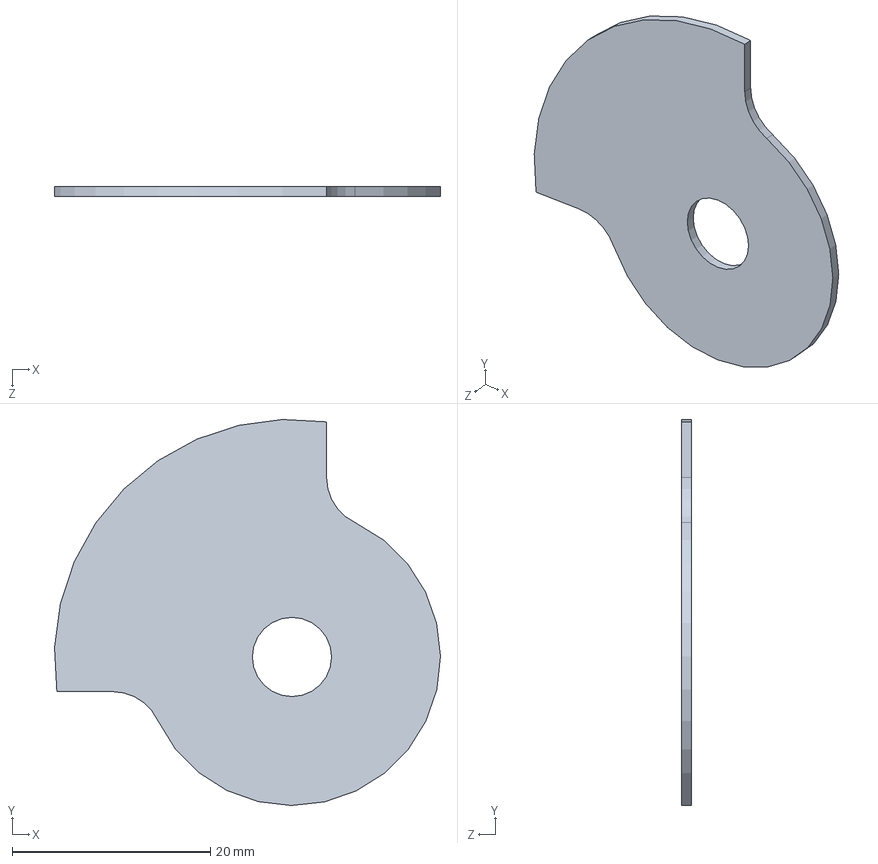
[picture p39: CAD file, 2026-10-21]
resources/model/三角机器人/z_ganyingpian.SLDPRT
39.0 x 39.0 x 1.00 mm
