SunXingzhi/topping_machine/resources/model/三角机器人/xiaoding.SLDPRT

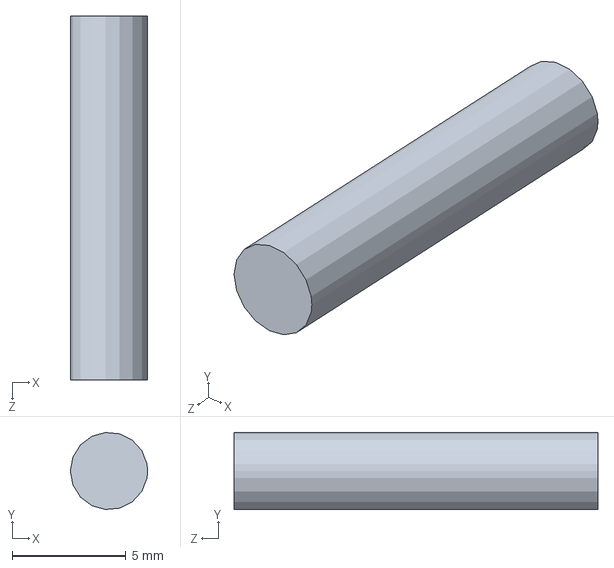
[picture p40: CAD file, 2026-10-21]
resources/model/三角机器人/xiaoding.SLDPRT
3.40 x 3.39 x 16.0 mm
