SunXingzhi/topping_machine/resources/model/三角机器人/kunben10.SLDPRT

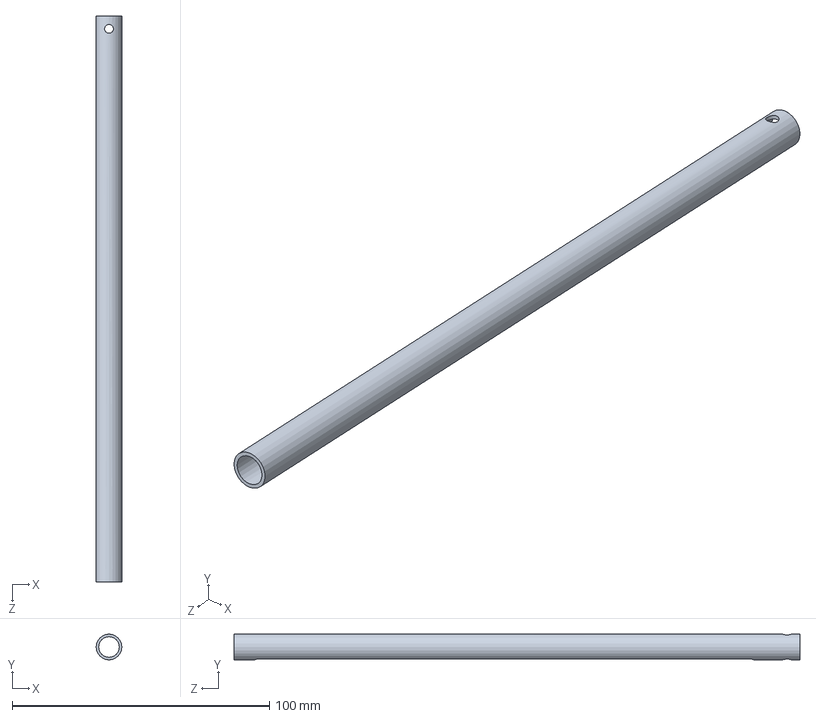
[picture p41: CAD file, 2026-10-21]
resources/model/三角机器人/kunben10.SLDPRT
10.0 x 10.0 x 220.0 mm
