SunXingzhi/topping_machine/resources/model/三角机器人/ZHOU8.SLDPRT

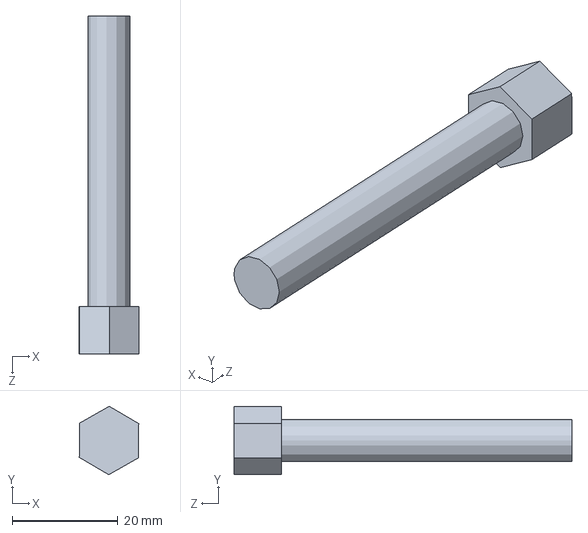
[picture p42: CAD file, 2026-10-21]
resources/model/三角机器人/ZHOU8.SLDPRT
11.3 x 13.0 x 64.0 mm
