SunXingzhi/topping_machine/simulation/ros2_ws/src/topping_delta_description/urdf/topping_delta.pdf

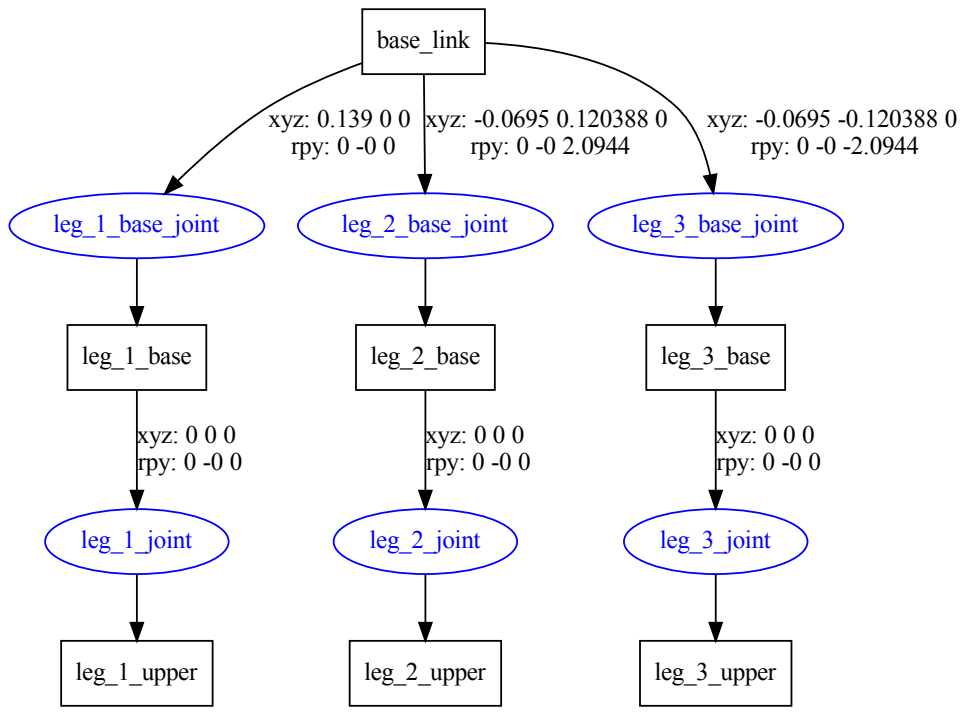
[picture p43: page 1]
base_link; leg_1_base_joint; xyz: 0.139 0 0 rpy: 0 -0 0; leg_2_base_joint; xyz: -0.0695 0.120388 0 rpy: 0 -0 2.0944; leg_3_base_joint; xyz: -0.0695 -0.120388 0 rpy: 0 -0 -2.0944; leg_1_base; leg_1_joint; xyz: 0 0 0 rpy: 0 -0 0; leg_1_upper; leg_2_base; leg_2_joint; leg_2_upper; leg_3_base; leg_3_joint; leg_3_upper
