SunXingzhi/topping_machine/firmware/STM32F103C8T6/STM32F103C8T6.ioc

Mcu.UserName=STM32F103C8Tx
PA11.Signal=CAN_RX
PA12.Signal=CAN_TX
PA13.Signal=SYS_JTMS-SWDIO
PA14.Signal=SYS_JTCK-SWCLK
PD0-OSC_IN.Signal=RCC_OSC_IN
PD1-OSC_OUT.Signal=RCC_OSC_OUT
