SunXingzhi/topping_machine/(commit log)

2026-10-18 feat: 添加网页需求展示
2026-10-21 feat: 添加了3D示例模型, 以及python 虚拟环境配置文件
2026-10-24 feat: 增加 python 环境支持, 增加视觉设计方案 以及 delta机械臂算法支持
2026-10-26 feat: 增加 BOM 表清单和 delta机械臂(运动学/约束版本) 分析
2026-10-26 feat: 增加机械臂逆解算法即轨迹采样绘制, 以及正解运动学(带物理约束)版本的算法支持
2026-10-26 feat: 增加多方案对比
2026-10-27 feat: 添加STM32F103(下位机)cubemx配置初始程序, 包括CAN1总线配置以及72MHz系统时钟配置
2026-10-30 feat(firmware): 增加 PD42S1 三轴 CAN 电机驱动
    - 新增 motor.h/motor.c，实现自定义 CAN 协议、三轴控制与状态读取
    - 测试代码移至 tests/，生产 main.c 仅保留初始化
    - CMake 增加可选测试构建与 Test preset
    - 增加固件 .gitignore，排除构建产物、IDE 配置和本地参考资料
    - 补充需求设计、测试报告和仓库说明文档
2026-11-03 fix(motor): 支持刹车状态并增加清除状态接口
    - Motor_ReadState 接受实测 0x08 刹车状态，映射为 MOTOR_STATE_BRAKE
    - 新增 Motor_ClearState，发送 0xFB 清除刹车/堵转/失能状态
2026-11-09 fix: 更新了delta机械臂运动学约束分析
2026-11-10 feat: 增加 了delta_arm 的ros2 支持（RVIZ2， 控制算法 核心， 以及URDF 描述 层）； 合并了Astra pro 相机ROS SDK, libuvc 作为子模块到工作区 中
